arisfebriyanto193/EWS/EWS/eror_code.md

  #### Tabel Referensi Kode Anomali:

                    Kode                  |                 Status                 | Arti / Deskripsi Singkat
  ----------------------------------------|----------------------------------------|---------------------------------------------------------------
                     OK                   |             Normal / Aman              | Semua parameter sensor berada dalam batas aman
                     A1                   |             Baterai Lemah              | Tegangan baterai/aki lemah atau sensor daya 0.00V
                     A2                   |                 Bahaya                 | Kemiringan lereng Gyro Pitch / Roll ekstrem (≥ Ambang Bahaya)
                     A3                   |                 Siaga                  | Kemiringan lereng Gyro Pitch / Roll waspada (≥ Ambang Siaga)
                     A4                   |                 Bahaya                 | Curah hujan ekstrem tinggi (≥ Ambang Bahaya)
                     A5                   |                 Siaga                  | Curah hujan lebat (≥ Ambang Siaga)
                     A6                   |                 Bahaya                 | Getaran gempa / pergerakan tanah ekstrem (≥ Ambang Bahaya)
                     A7                   |                 Siaga                  | Kelembapan tanah kritis / jenuh air (≥ Ambang Siaga)
                     A8                   |                 Siaga                  | Getaran sesaat terdeteksi (tahap filter persistensi)
