arisfebriyanto193/EWS/dokumen/Penguatan_Kapasitas_Karang_Taruna_dan_Masyarakat_Karanggayam.pptx

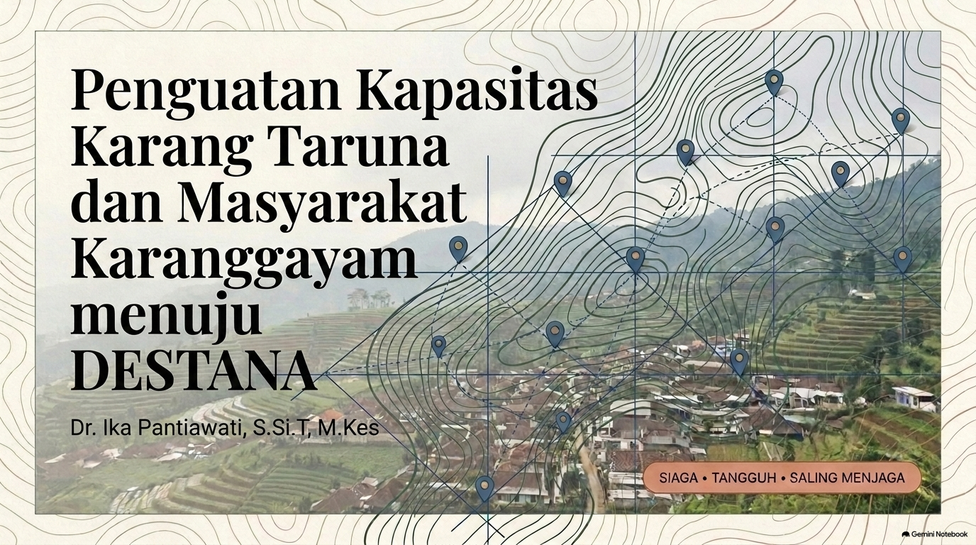
[picture p6: figure]

## Slide 2

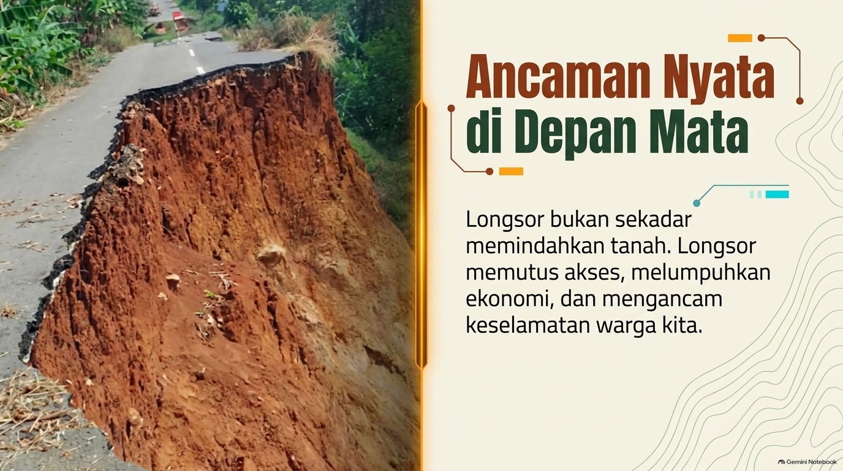
[picture p7: figure]

## Slide 3

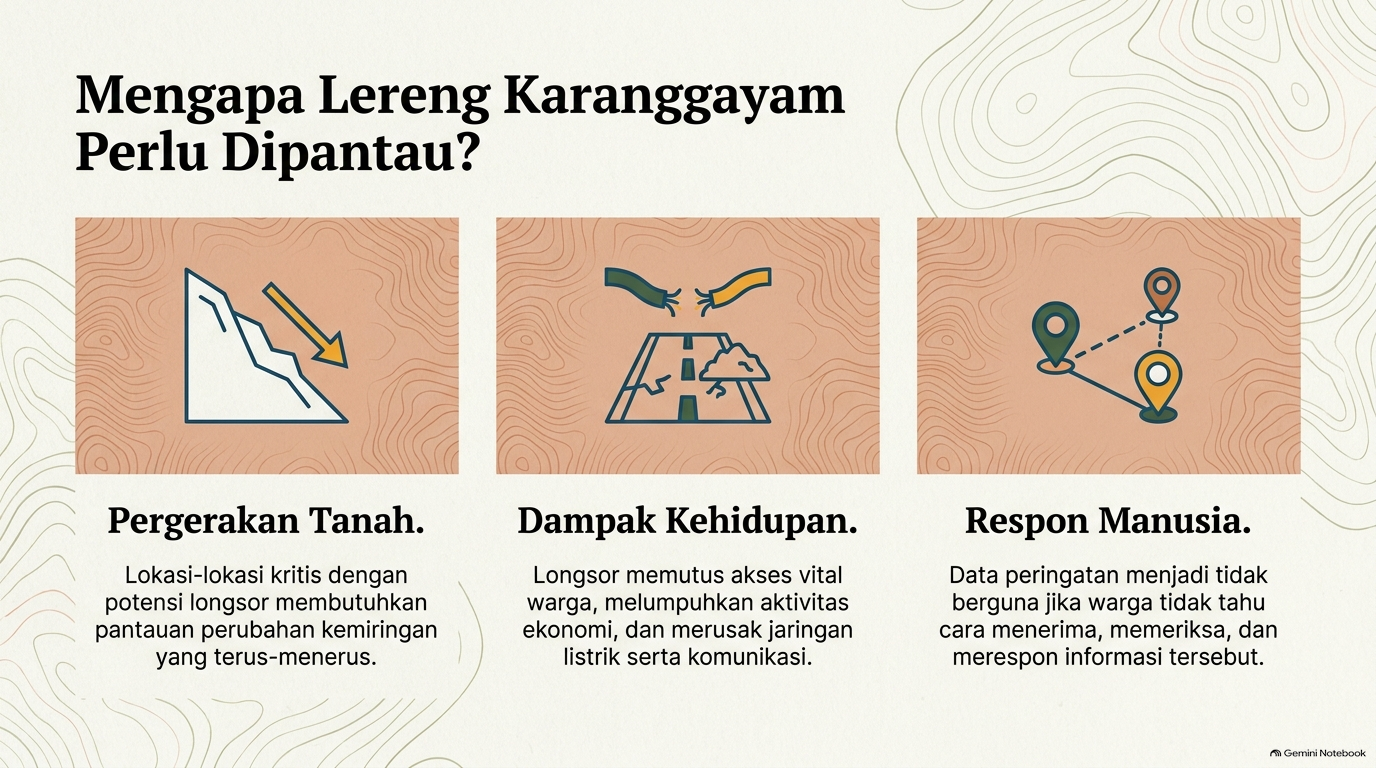
[picture p8: figure]

## Slide 4

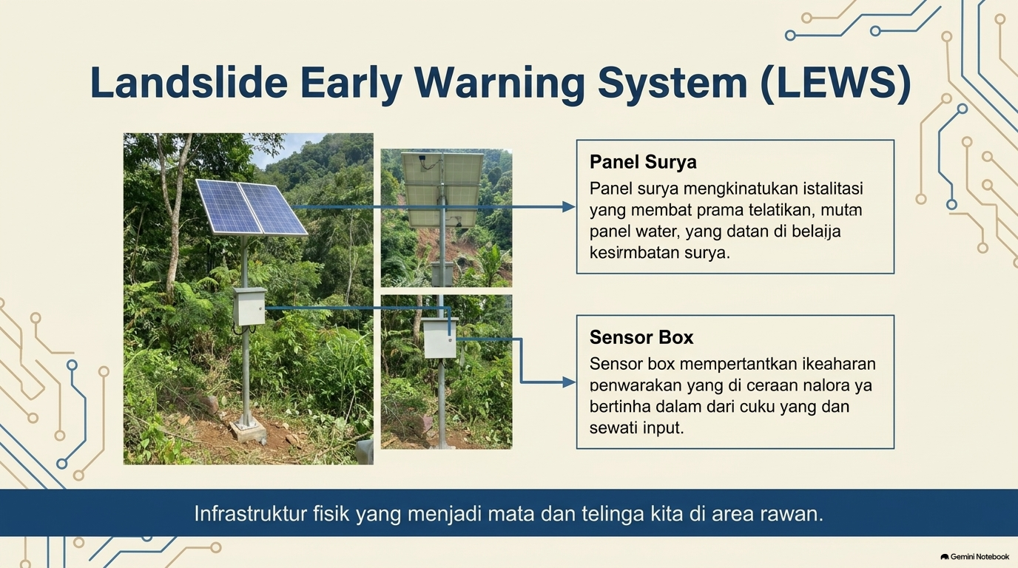
[picture p9: figure]

## Slide 5

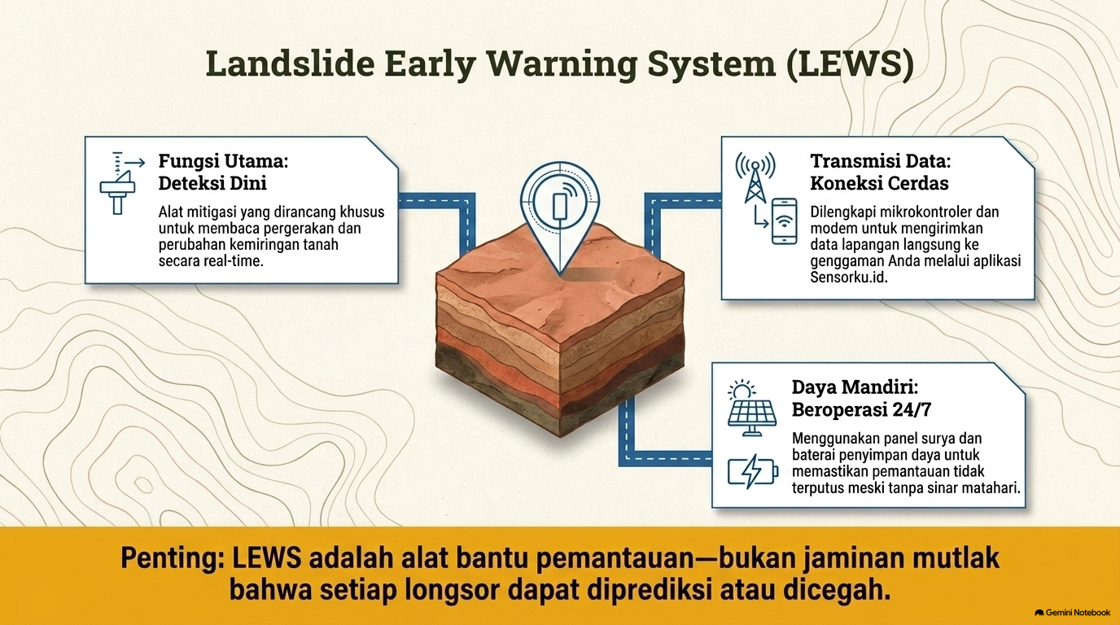
[picture p10: figure]

## Slide 6

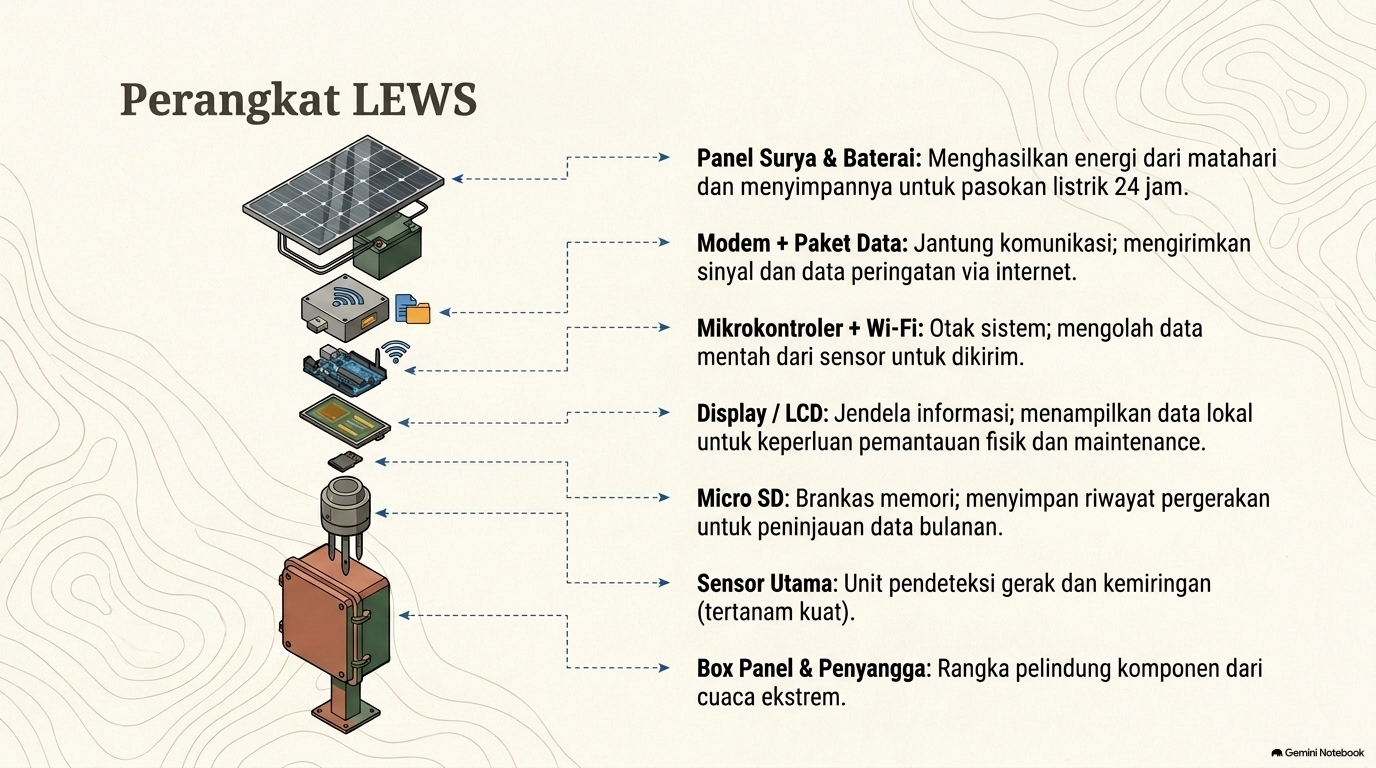
[picture p11: figure]

## Slide 7

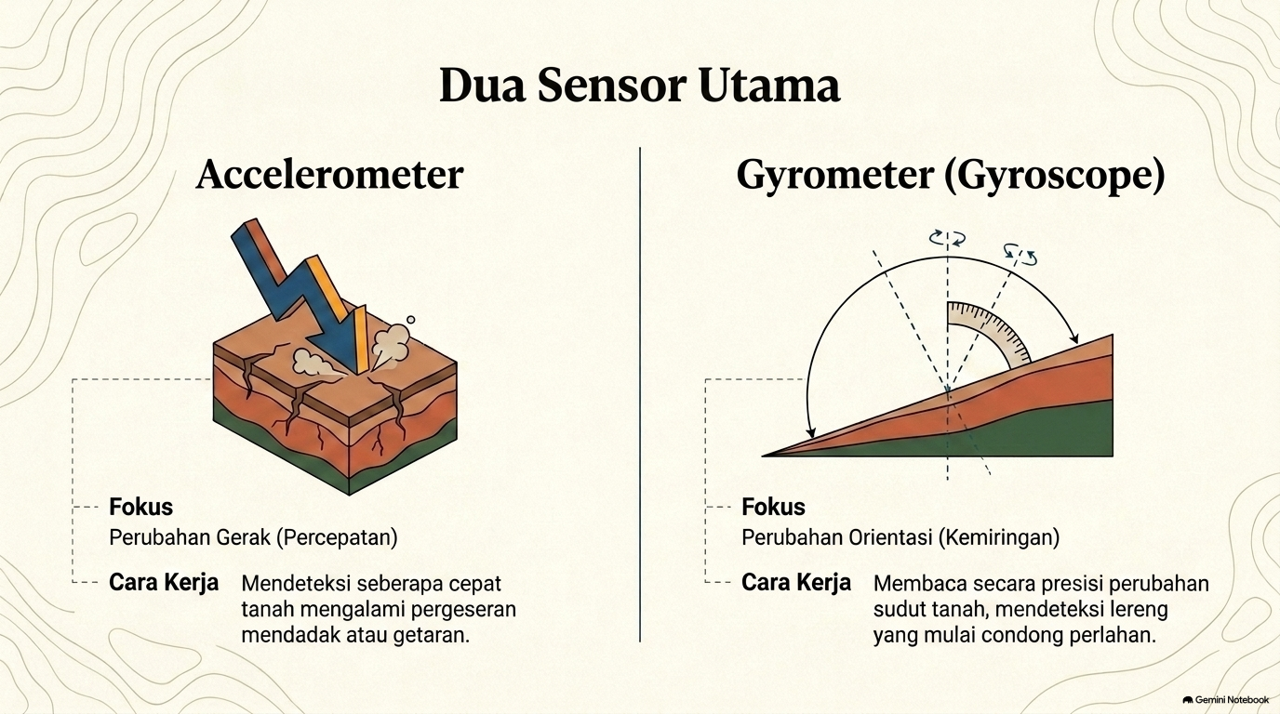
[picture p12: figure]

## Slide 8

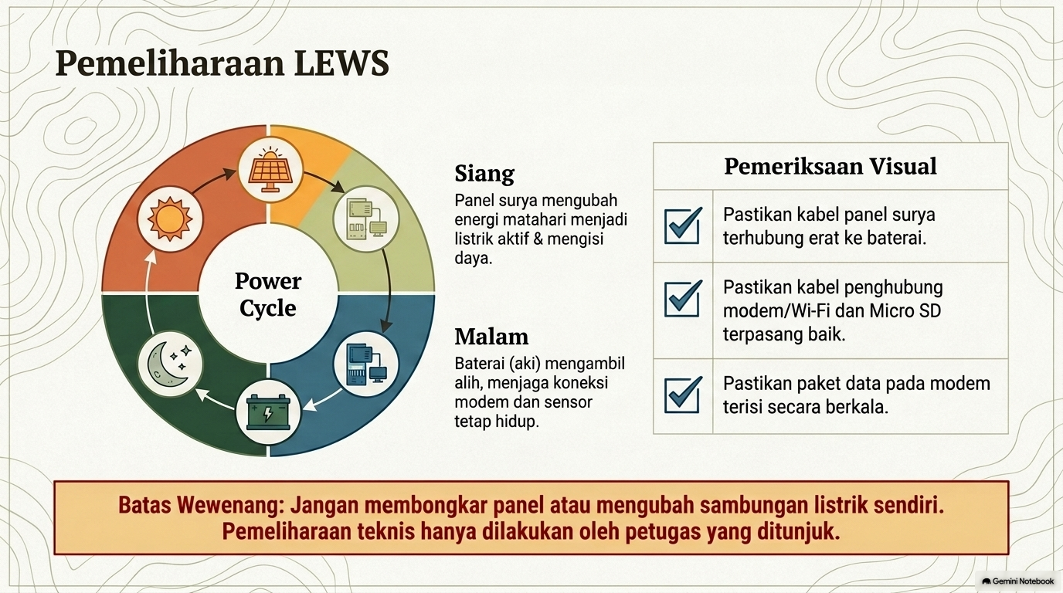
[picture p13: figure]

## Slide 9

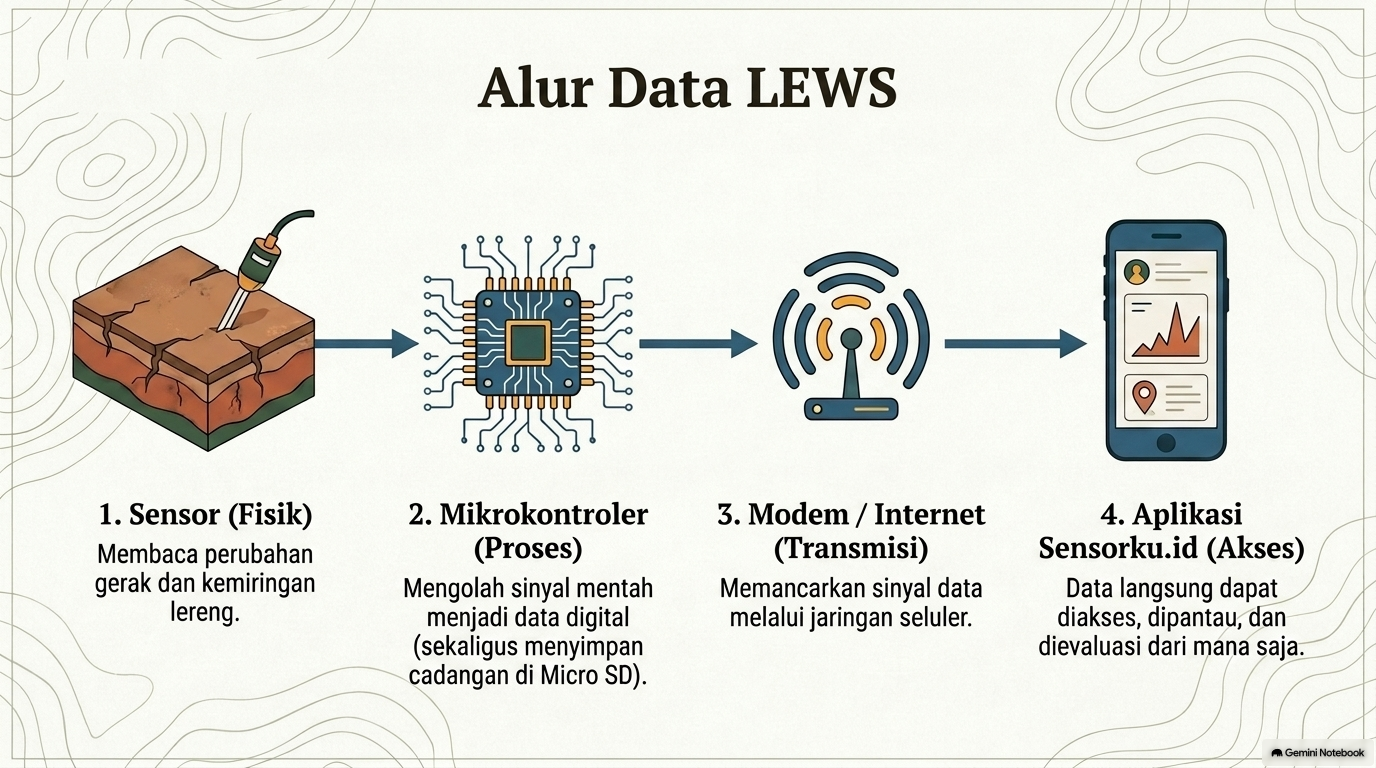
[picture p14: figure]

## Slide 10

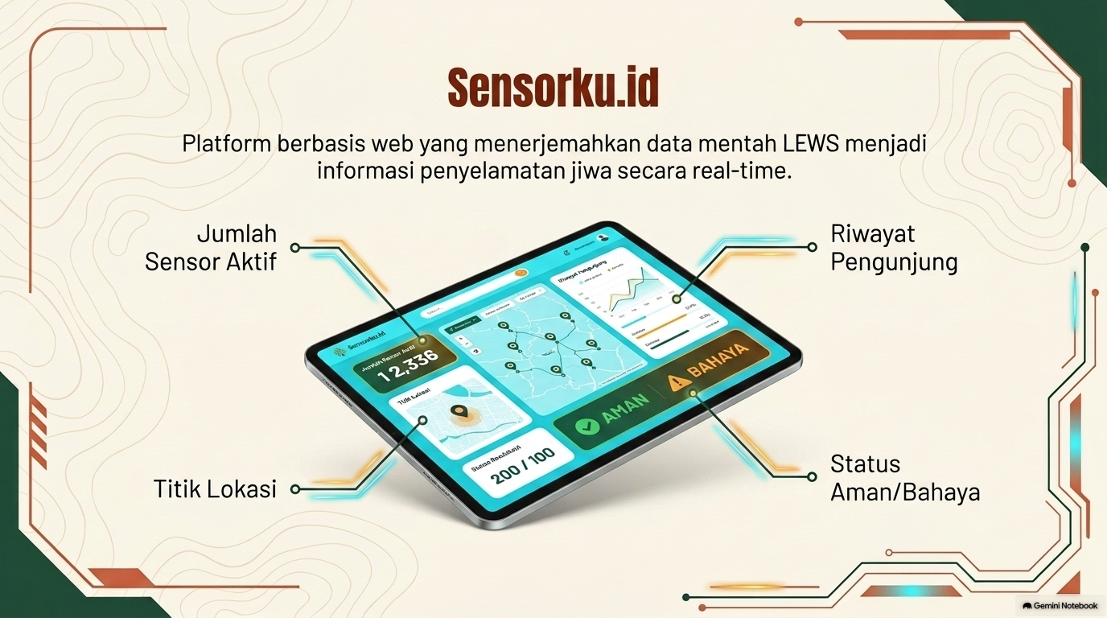
[picture p15: figure]

## Slide 11

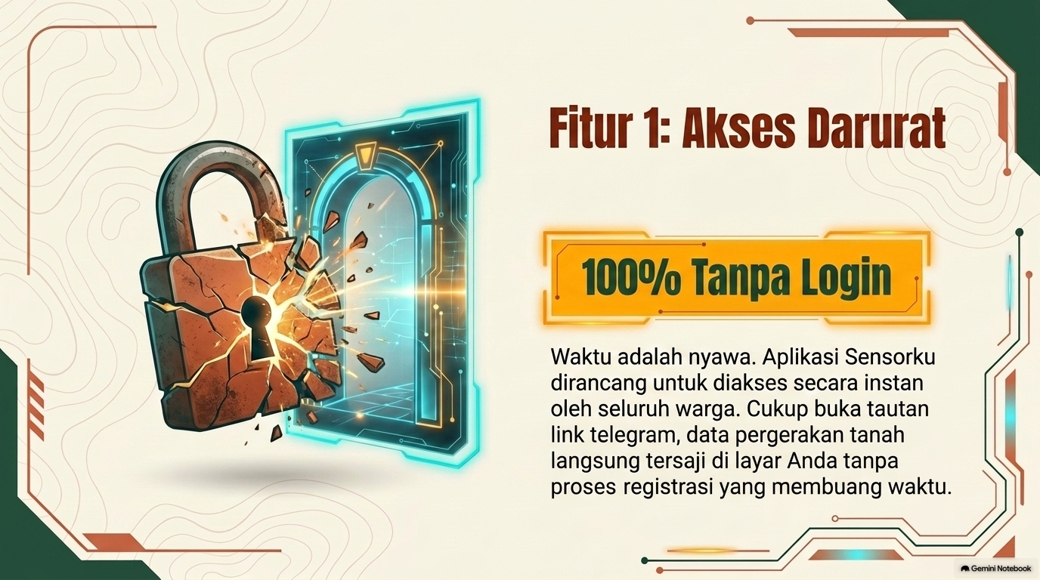
[picture p16: figure]

## Slide 12

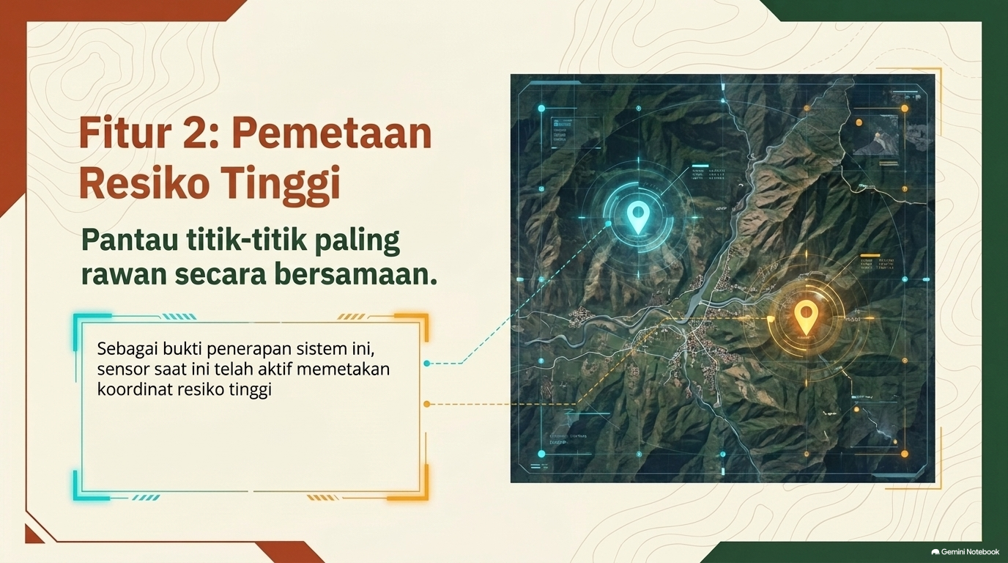
[picture p17: figure]

## Slide 13

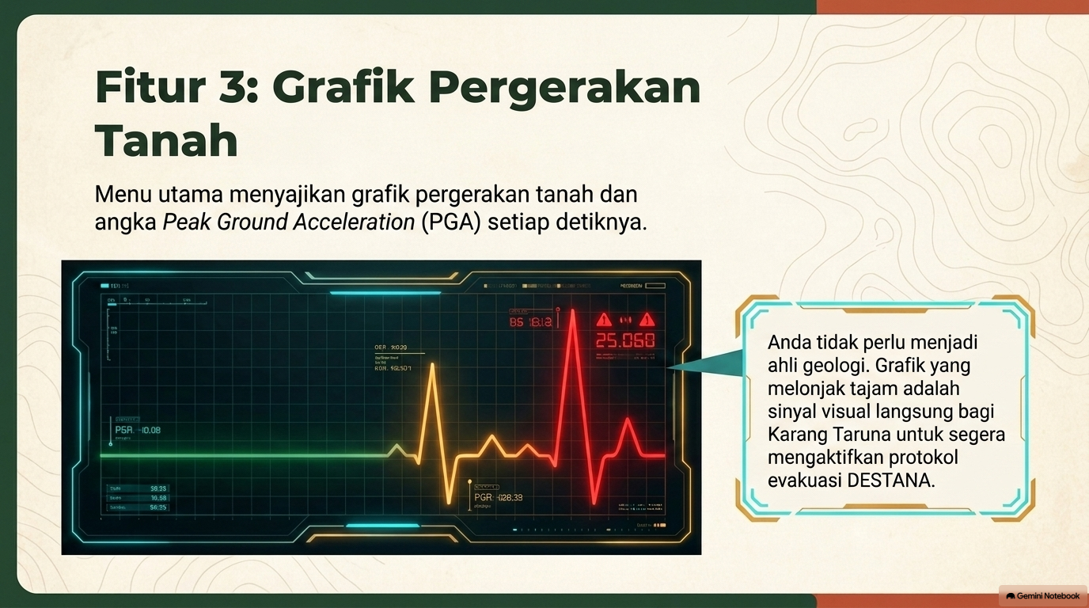
[picture p18: figure]

## Slide 14

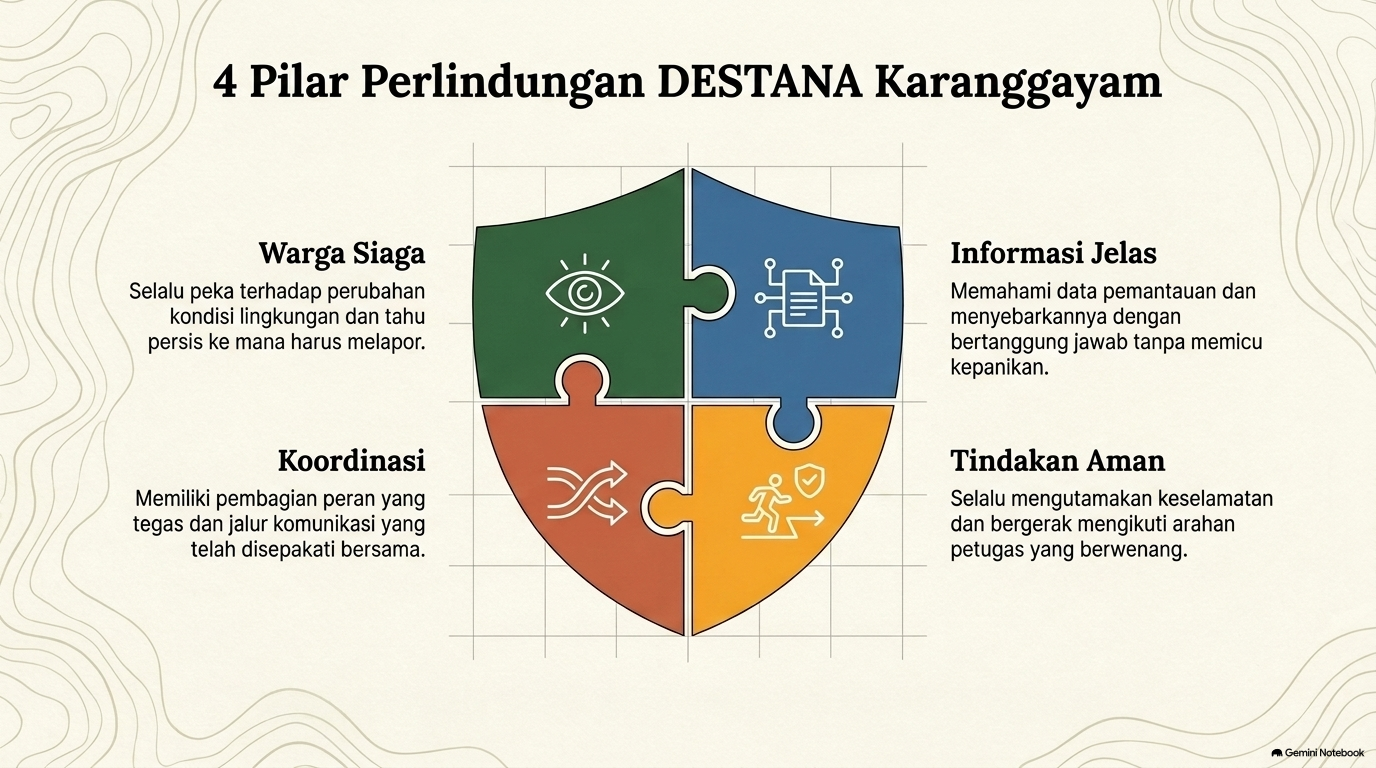
[picture p19: figure]

## Slide 15

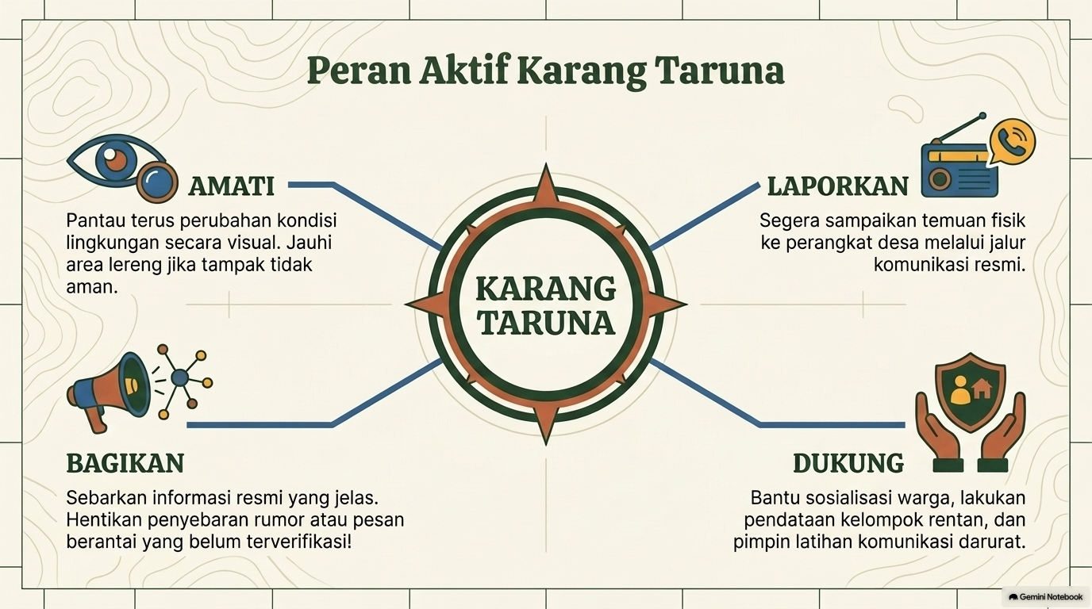
[picture p20: figure]

## Slide 16

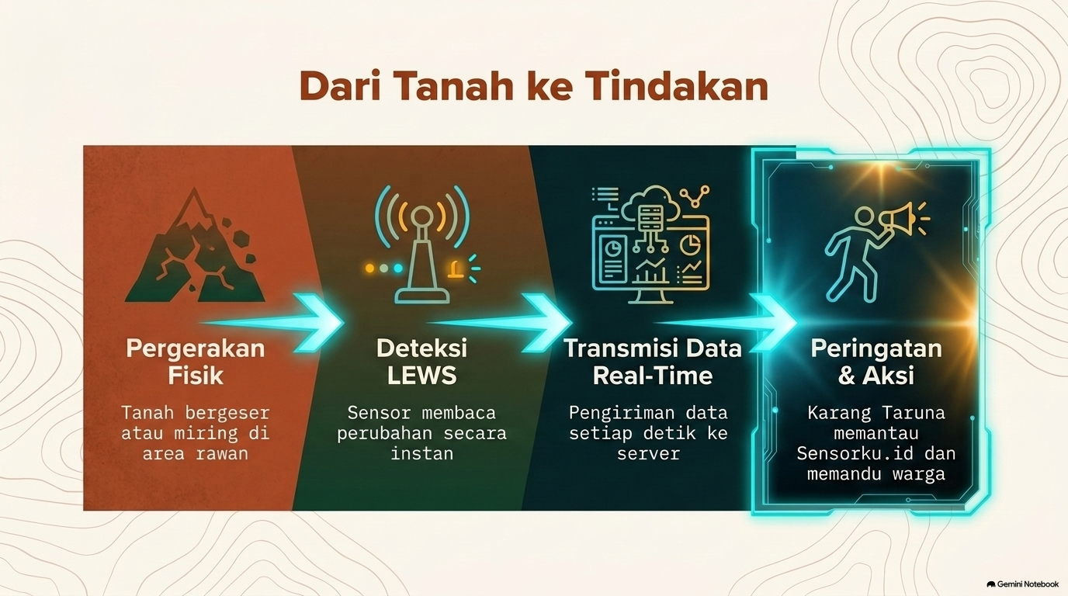
[picture p21: figure]

## Slide 17

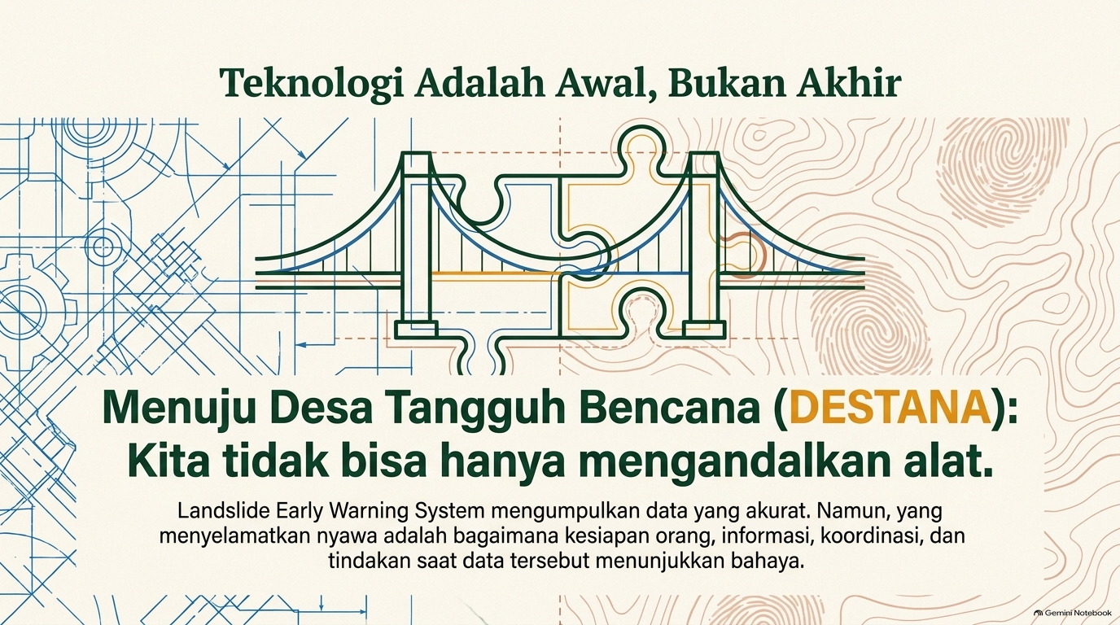
[picture p22: figure]

## Slide 18

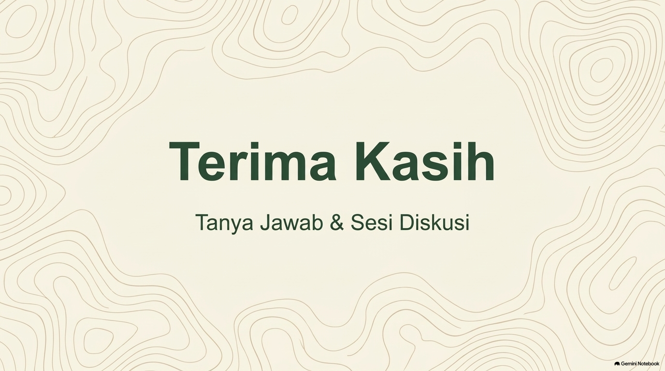
[picture p23: figure]
