arisfebriyanto193/EWS/3d/batre/bracket_check.png

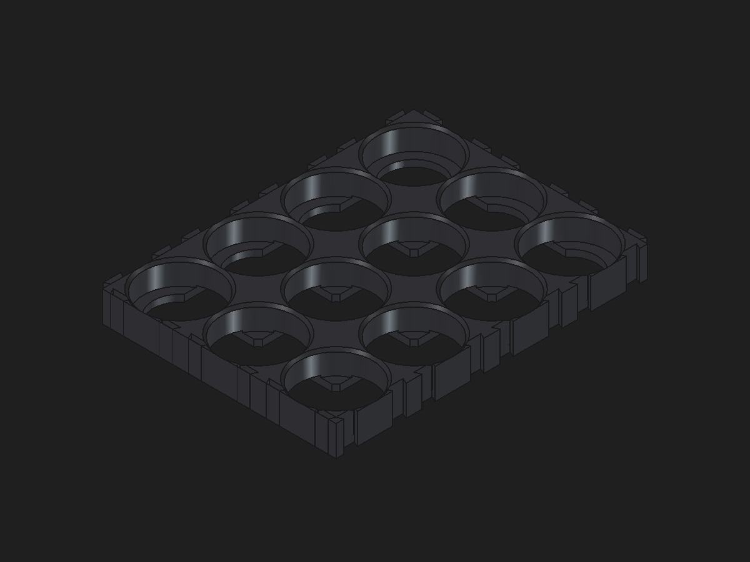
3d/batre/bracket_check.png
