arisfebriyanto193/EWS/3d/batre/bracket_check_bottom.png

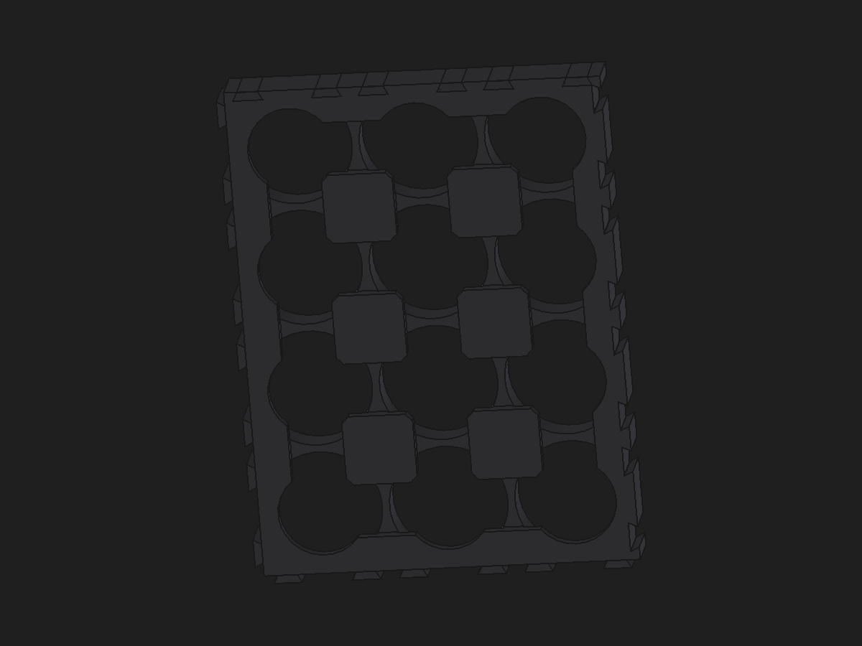
3d/batre/bracket_check_bottom.png
