arisfebriyanto193/EWS/EWS/docs/images/schematic_ews45_rev2-1.png

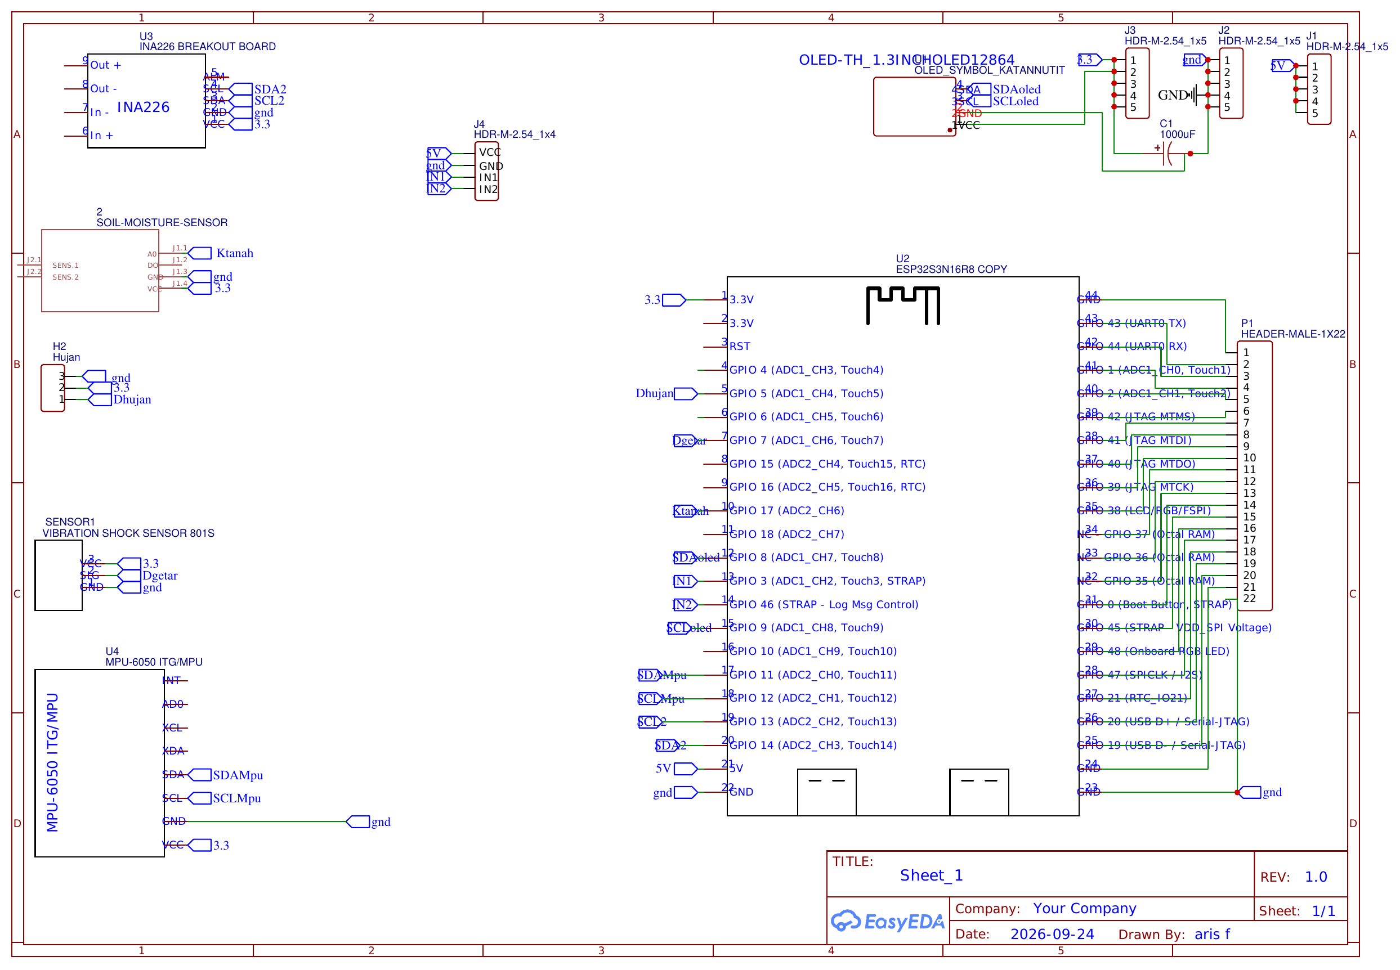
EWS/docs/images/schematic_ews45_rev2-1.png
