arisfebriyanto193/EWS/EWS/docs/images/screenshot_alarms.png

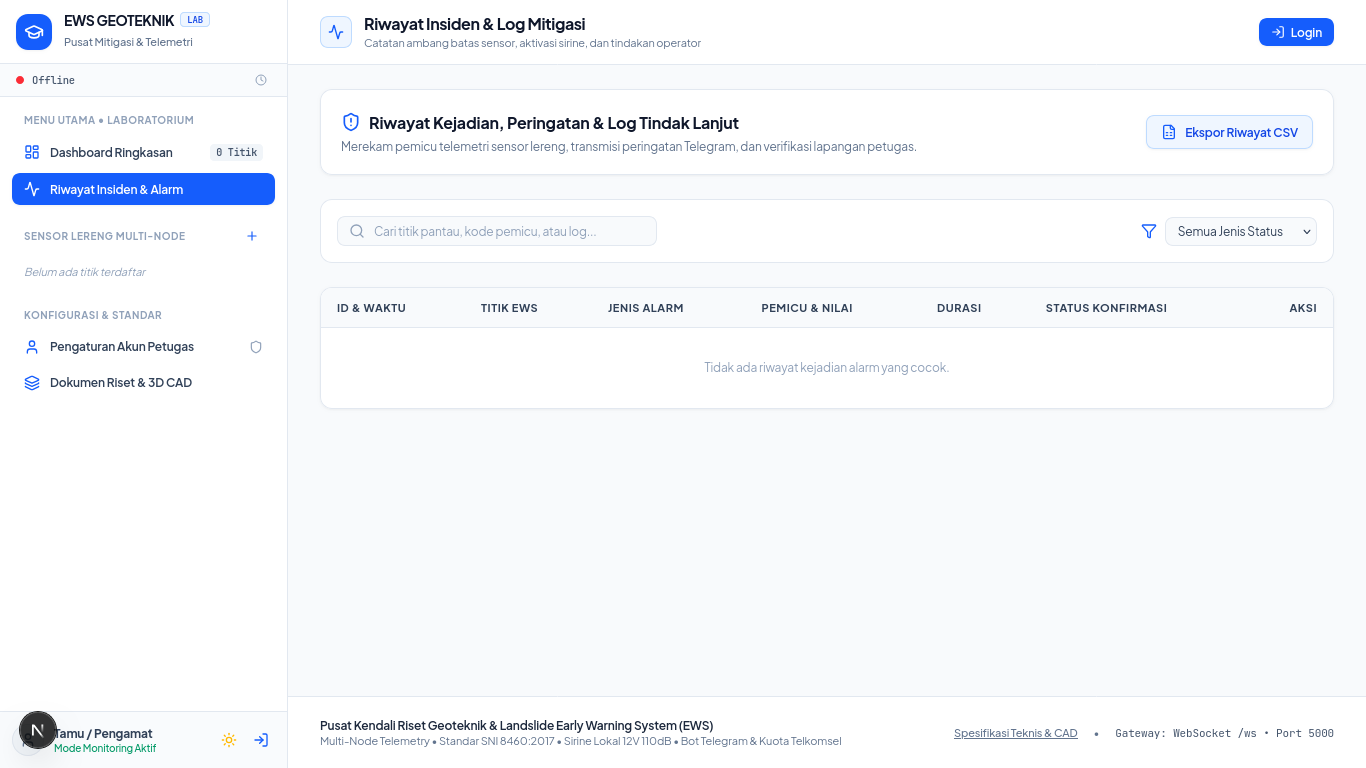
EWS/docs/images/screenshot_alarms.png
