arisfebriyanto193/EWS/EWS/PCB/toolpaths_preview.png

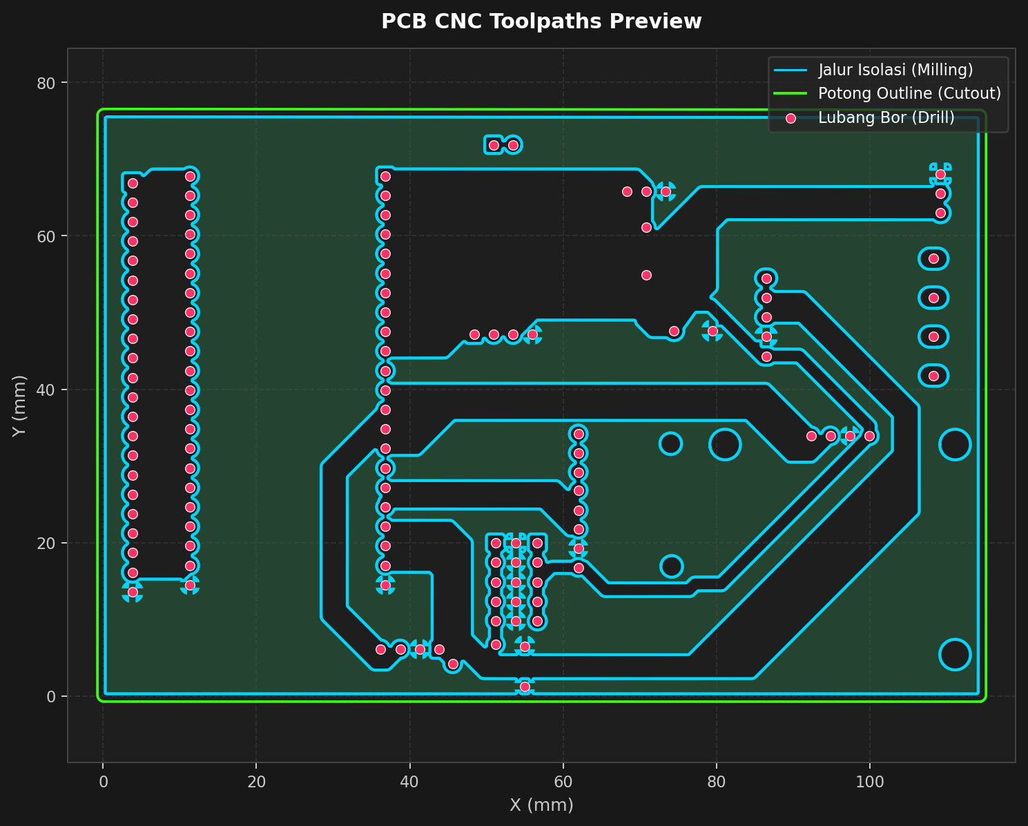
EWS/PCB/toolpaths_preview.png
