arisfebriyanto193/EWS/perangkap-hama/gcode/toolpaths_preview.png

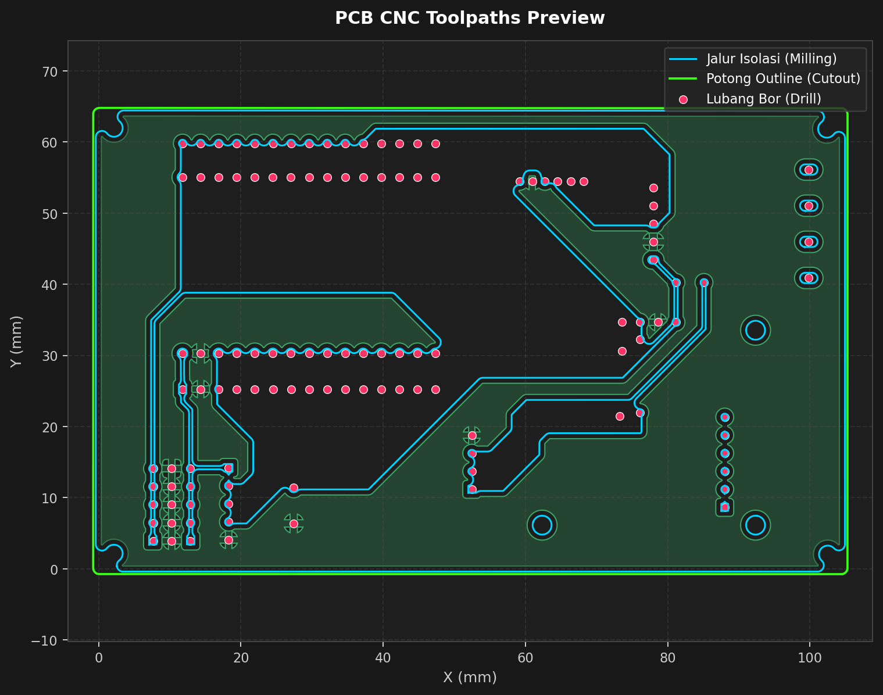
perangkap-hama/gcode/toolpaths_preview.png
