arisfebriyanto193/EWS/3d/batre/Bracket_21700_3S4P.step

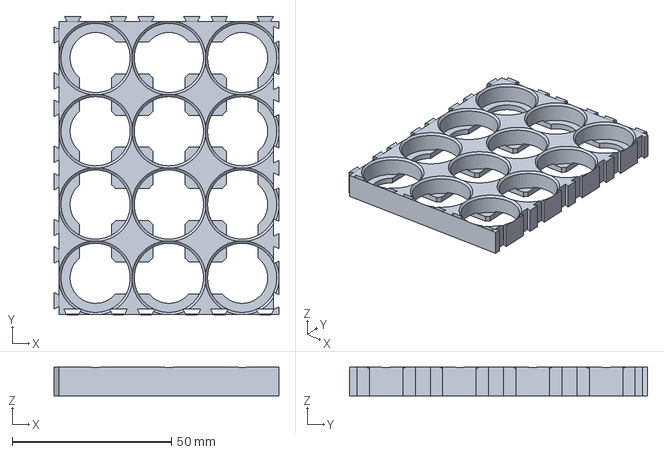
[picture p37: CAD file, 2026-10-11]
3d/batre/Bracket_21700_3S4P.step
70.5 x 93.5 x 9.00 mm
