arisfebriyanto193/EWS/EWS/Box_Panel_EWS.3mf

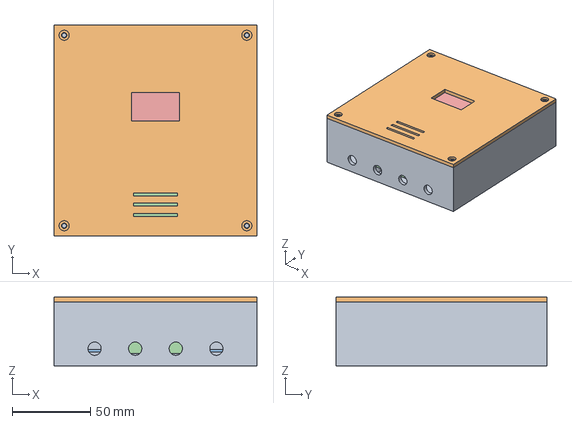
[picture p38: CAD file, 2026-10-11]
EWS/Box_Panel_EWS.3mf
130.0 x 135.0 x 44.0 mm
