arisfebriyanto193/EWS/(list of files, cad)

Other CAD files:
3d/batre/Bracket_21700_3S4P.FCStd
3d/batre/Bracket_21700_3S4P.stl
