arisfebriyanto193/EWS/perangkap-hama/pcb/Gerber_perangkap_hama_PCB_perangkap_hama_2_2026-09-30/How-to-order-PCB.txt

How to Order PCB

Please refer to:
https://docs.easyeda.com/en/PCB/Order-PCB
