arisfebriyanto193/EWS/EWS/PCB/Schematic_EWS45_2026-09-28.pdf

## INA226

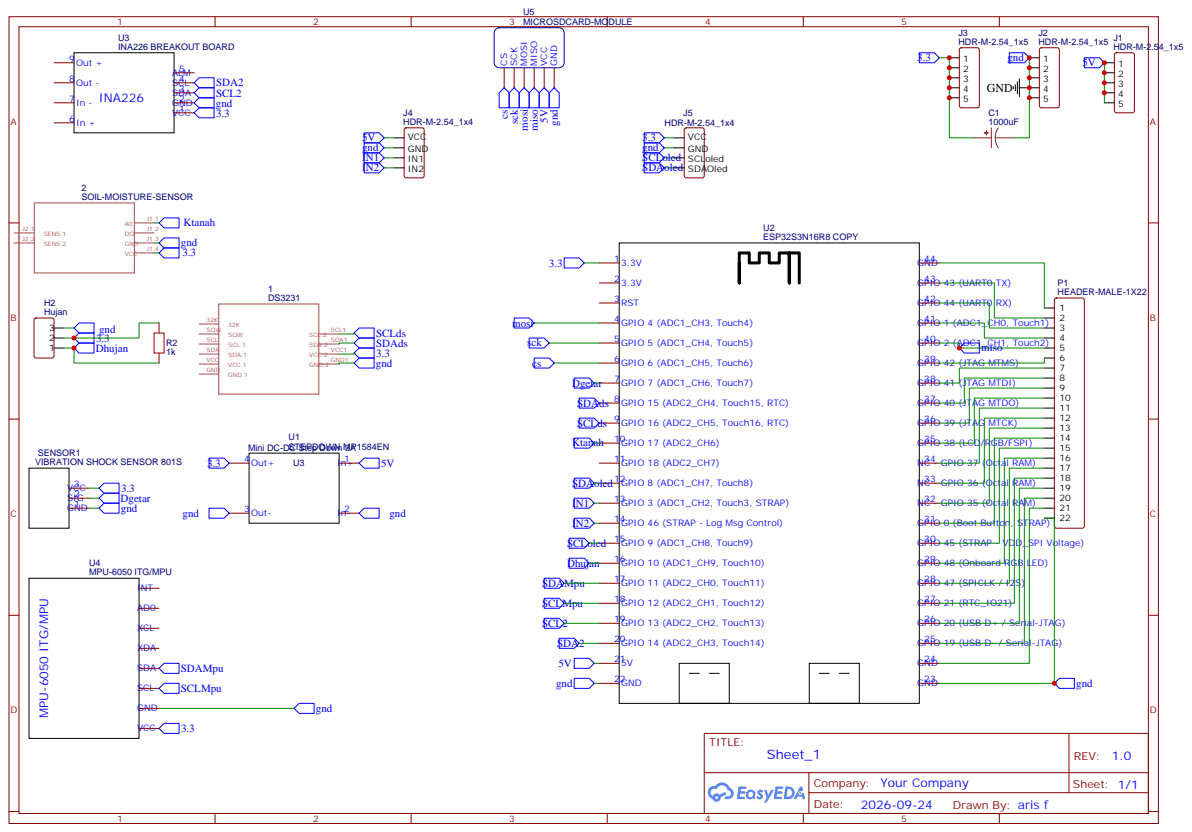
[picture p39: page 1]

GND44
GPIO 43 (UART0 TX) 43
GPIO 44 (UART0 RX) 42
GPIO 1 (ADC1_CH0, Touch1) 41
GPIO 2 (ADC1_CH1, Touch2) 40
GPIO 42 (JTAG MTMS) 39
GPIO 41 (JTAG MTDI) 38
GPIO 40 (JTAG MTDO) 37
GPIO 39 (JTAG MTCK) 36
GPIO 38 (LCD/RGB/FSPI) 35
NC - GPIO 37 (Octal RAM) 34
NC - GPIO 36 (Octal RAM) 33
NC - GPIO 35 (Octal RAM) 32
GPIO 0 (Boot Button, STRAP) 31
GPIO 45 (STRAP - VDD_SPI Voltage) 30
GPIO 48 (Onboard RGB LED) 29
GPIO 47 (SPICLK / I2S) 28
GPIO 21 (RTC_IO21) 27
GPIO 20 (USB D+ / Serial-JTAG) 26
GPIO 19 (USB D- / Serial-JTAG) 25
GND24

Mini DC-DC Step Down 3A
Out+ 4
