arisfebriyanto193/EWS/perangkap-hama/pcb/pcb/Schematic_perangkap_hama_2026-10-03.pdf

A | A

1

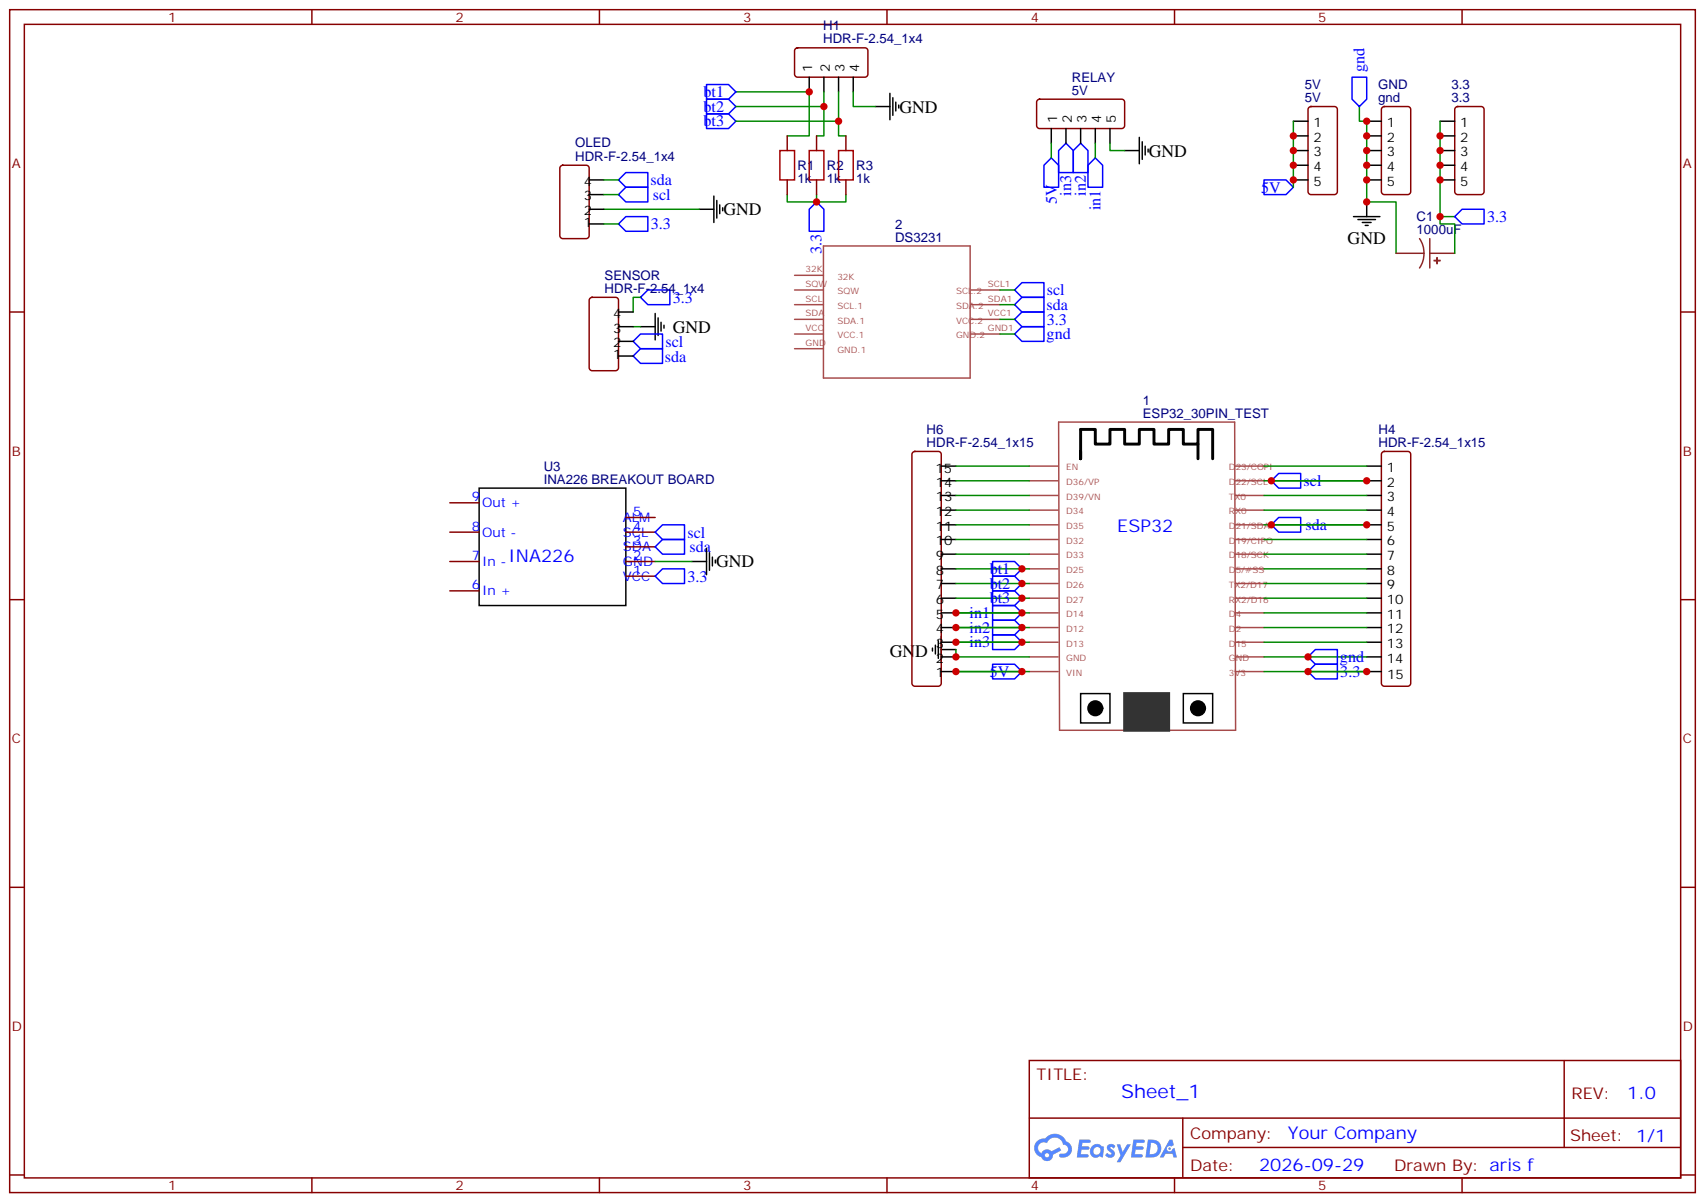
[picture p40: page 1]
