arisfebriyanto193/EWS/EWS/esp32-program/esp_32/esp_32.ino

/**
 * ==============================================================================
 * SISTEM MONITORING LANDSLIDE EARLY WARNING SYSTEM (EWS) - ESP32-S3 FIRMWARE
 * DENGAN ARSITEKTUR MULTI-TASKING FREERTOS & MUTEX SYNCHRONIZATION
 * ==============================================================================
 * Deskripsi:
 * Program firmware ESP32-S3 untuk Node EWS yang terhubung ke Backend Express
 * dan Frontend Next.js melalui protokol WebSocket secara real-time.
 *
 * Menerapkan FreeRTOS Dual-Core & Mutex:
 * - Core 0: Task WebSocket Client (Jaringan & Protokol TCP/SSL)
 * - Core 1: Task Sensor (I2C Inclinometer, INA226, OLED, ADC Tanah, Hujan)
 * - Core 1: Task Telemetri (Penerbitan Data dengan Pacing Buffer SSL)
 * - Mutex (wsMutex): Mengunci akses thread-safe ke webSocket.loop() & sendTXT()
 * - Mutex (dataMutex): Mengunci sinkronisasi data sensor antar-task
 * - Critical Section (vibMux): Penguncian atomik pulsa interrupt getaran 801S
 *
 * MAPPING PIN SESUAI DOKUMEN SCHEMATIC PCB:
 * File: Schematic_EWS45_2026-09-28.pdf
 * Mikrokontroler: ESP32-S3 (ESP32S3N16R8)
 * ------------------------------------------------------------------------------
 * PIN SCHEMATIC        | FUNGSI / KOMPONEN
 * ------------------------------------------------------------------------------
 * GPIO 46 (IN2)        | Output Relay Alarm Terpadu: Sirine 12V + Strobo (Active-HIGH)
 * GPIO 10 (Dhujan)     | Input Digital Sensor Hujan Tipping Bucket (H2)
 * GPIO 7  (Dgetar)     | Input Digital Sensor Getaran Shock 801S (SENSOR1)
 * GPIO 17 (Ktanah)     | Input Analog (ADC2_CH6) Sensor Kelembapan Tanah (J1.1 A0)
 * GPIO 8  (SDAoled)    | I2C SDA - Layar OLED 1.3" 128x64 (J5)
 * GPIO 9  (SCLoled)    | I2C SCL - Layar OLED 1.3" 128x64 (J5)
 * GPIO 11 (SDAMpu)     | I2C SDA - MPU-6050 Dual-Axis Inclinometer (U4)
 * GPIO 12 (SCLMpu)     | I2C SCL - MPU-6050 Dual-Axis Inclinometer (U4)
 * GPIO 13 (SCL2/SDA)   | I2C SDA - INA226 Voltage & Current Monitor (U3) via Net SCL2
 * GPIO 14 (SDA2/SCL)   | I2C SCL - INA226 Voltage & Current Monitor (U3) via Net SDA2
 * GPIO 4  (mosi)       | SPI MOSI - MicroSD Card Module (U5)
 * GPIO 5  (sck)        | SPI SCK - MicroSD Card Module (U5)
 * GPIO 6  (cs)         | SPI CS - MicroSD Card Module (U5)
 * GPIO 2  (miso)       | SPI MISO - MicroSD Card Module (U5)
 * GPIO 15 (SDAds)      | I2C SDA - DS3231 High-Precision RTC (Bus Terpisah 0x68)
 * GPIO 16 (SCLds)      | I2C SCL - DS3231 High-Precision RTC (Bus Terpisah 0x68)
 * ==============================================================================
 */

#include <WiFi.h>
// WiFiManager dihapus - diganti dengan WebServer bawaan + AP auto-management
#include <WebServer.h>
#include <WebSocketsClient.h>
#include <ArduinoJson.h>
#include <Wire.h>
#include <SPI.h>
#include <SD.h>
#include <SPIFFS.h>
#include <math.h>
#include <time.h>
#include <Preferences.h>
#include <driver/gpio.h>   // gpio_reset_pin() — memutus GPIO Matrix dari periferal (I2C, dll.)
// Catatan: Library MPU6050, INA219, dan DS3231 kini menggunakan driver bus independen
// (Hardware TwoWire 1 untuk MPU-6050 & Dedicated SoftI2C untuk RTC/INA)
// sehingga tidak lagi memerlukan overhead atau bentrok bus dari library Adafruit_BusIO.

// Forward Declarations Struct & Functions untuk Arduino Preprocessor
struct SensorThresholds;
struct SensorRawValues;
struct SensorDataSnapshot;
void setupWebServer();
void updateWebSocketTopics();
void saveThresholdsToEEPROM(const SensorThresholds &newT);
void loadThresholdsFromEEPROM();
void saveDeviceConfigToNVS(const String &newId, const String &newSsid, const String &newPass,
                           const String &newHost, int newPort, const String &newPath, bool newSsl);
void loadDeviceConfigFromNVS();
void syncRTCWithNTP(bool force = false);
void setSystemTimeFromEpoch(time_t epoch);
void checkAndPruneSDCard();
void checkAndPruneSPIFFS();
void initMicroSD();
void initSPIFFS();
void logPeriodicTelemetryToSD(float pitch, float roll, float soil, int soilRaw,
                              float rain, float rainCumu, unsigned long tips,
                              float vib, unsigned long vibPulses,
                              float batt, int battMa, int solar,
                              const char* status, const char* reason);
void logEventToSD(const char* status, const char* reason, float pitch, float roll, float rain, float soil, float batt);
void checkDailyRainReset();
void saveDailyRainToEEPROM();
void checkAndRestoreDailyRain();
bool getCurrentDateParts(int &day, int &mon, int &yr, int &hr, int &min);

// FreeRTOS Headers
#include "freertos/FreeRTOS.h"
#include "freertos/task.h"
#include "freertos/semphr.h"

// Aktifkan dukungan layar OLED jika library terpasang (1 = Aktif, 0 = Nonaktif)
#define ENABLE_OLED 1

#if ENABLE_OLED
  #include <Adafruit_GFX.h>
  #include <Adafruit_SH110X.h>
  #define SCREEN_WIDTH 128
  #define SCREEN_HEIGHT 64
  #define OLED_RESET -1
  #define OLED_I2C_ADDR 0x3C
#endif

// =============================================================================
// 1. KONFIGURASI JARINGAN, DEVICE ID & SERVER WEBSOCKET (DAPAT DIATUR VIA WEB)
// =============================================================================
// Default Fallback Kredensial WiFi (dapat diganti via NVS/Web Server)
String wifiSsidDefault     = "TALAS 1";
String wifiPasswordDefault = "kitahebat";

// Konfigurasi Target WebSocket Server (disimpan & dibaca dari NVS Preferences)
bool   wsUseSsl            = true;
String wsHost              = "be-ews.qbyte.web.id";
int    wsPort              = 443;
String wsPath              = "/ws";

// Identitas Node Stasiun EWS (disimpan di NVS "ews_cfg" -> "devId")
String ewsId               = "EWS-02";
const char* FIRMWARE_VERSION = "v2.6.0-NO-WIFIMGR";

// Objek Internal WebServer untuk Kalibrasi & Konfigurasi Mandiri
WebServer localServer(80);

// Manajemen AP Otomatis (pengganti WiFiManager)
// Jika WiFi tidak terhubung, AP dinyalakan. Setiap 30 detik dicek:
// - Jika jaringan tersimpan tersedia → matikan AP, sambung WiFi
// - Jika WiFi terputus → nyalakan AP kembali
bool apActive = false;
unsigned long lastWifiCheckMs = 0;
const unsigned long WIFI_CHECK_INTERVAL_MS = 30000; // 30 detik

// =============================================================================
// 2. DEFINISI PIN SESUAI SCHEMATIC PCB
// =============================================================================
// Aktuator Relay (Sirine & Strobo digabung menjadi 1 pin: GPIO 46, Active-HIGH)
#define PIN_RELAY_ALARM      46  // IN2 -> GPIO 46 (Sirine + Strobo)
#define PIN_RELAY_SIRINE     PIN_RELAY_ALARM
#define PIN_RELAY_STROBO     PIN_RELAY_ALARM

// Logika Relay (Active-HIGH)
#define RELAY_ACTIVE_LEVEL   HIGH
#define RELAY_DEACTIVE_LEVEL LOW

// Sensor Lingkungan & Geoteknik
#define PIN_RAIN_DIGITAL   10   // Dhujan -> GPIO 10 (Input Digital Sensor Hujan Tipping Bucket)
#define PIN_VIB_SIG        7   // Dgetar -> GPIO 7 (Input Digital Getaran 801S)
#define PIN_SOIL_ANALOG    17  // Ktanah -> GPIO 17 (ADC2_CH6 Kelembapan Tanah J1.1 A0)

// Pin I2C Perangkat 1: OLED 1.3" (Header J5)
#define PIN_OLED_SDA_utama     8   // SDAoled Utama -> GPIO 8
#define PIN_OLED_SDA_cadangan  18  // SDAoled Cadangan (Fallback) -> GPIO 18
#define PIN_OLED_SDA           PIN_OLED_SDA_cadangan // Alias kompatibilitas
#define PIN_OLED_SCL           9   // SCLoled -> GPIO 9

// Pin I2C Perangkat 2: MPU-6050 Dual-Axis Inclinometer (U4)
#define PIN_MPU_SDA        11  // SDAMpu -> GPIO 11
#define PIN_MPU_SCL        12  // SCLMpu -> GPIO 12
#define MPU6050_ADDR       0x68

// Pin I2C Perangkat 3: INA219 / INA226 Voltage & Current Monitor (U3)
// Terbukti dari hardware scanner: GPIO 14 = SDA, GPIO 13 = SCL
#define PIN_INA_SDA        14  // Pin SDA INA219 (GPIO 14)
#define PIN_INA_SCL        13  // Pin SCL INA219 (GPIO 13)
#define INA_I2C_ADDR         0x40

// Fallback Pembagi Tegangan Resistor (Jika modul INA219/INA226 tidak terpasang)
// Pin GPIO 14 (Jalur SDA pada Header J3 INA) dihubungkan ke titik tengah resistor pembagi tegangan
// Resistor R1 = 11 ohm/k-ohm (ke kutub positif Aki) dan R2 = 4 ohm/k-ohm (ke GND)
#define PIN_BATTERY_DIVIDER 14
#define BATT_DIVIDER_R1     11.0f
#define BATT_DIVIDER_R2     4.0f
#define BATT_DIVIDER_DEFAULT_RATIO ((BATT_DIVIDER_R1 + BATT_DIVIDER_R2) / BATT_DIVIDER_R2) // 3.75f

// Pin SPI Perangkat 4: Modul MicroSD Card (U5)
#define PIN_SD_MOSI        4   // mosi -> GPIO 4
#define PIN_SD_SCK         5   // sck  -> GPIO 5
#define PIN_SD_CS          6   // cs   -> GPIO 6
#define PIN_SD_MISO        2   // miso -> GPIO 2

// Pin I2C Perangkat 5: Real-Time Clock DS3231 (Bus I2C terpisah untuk isolasi alamat 0x68 dari MPU6050)
#define PIN_RTC_SDA        15  // SDAds -> GPIO 15
#define PIN_RTC_SCL        16  // SCLds -> GPIO 16
#define DS3231_ADDR        0x68

// =============================================================================
// 3. TOPIK KOMUNIKASI WEBSOCKET (DINAMIS SESUAI DEVICE_ID)
// =============================================================================
String TOPIC_COMMAND;
String TOPIC_TELEMETRY;
String TOPIC_STATUS;
String TOPIC_PITCH;
String TOPIC_ROLL;
String TOPIC_SOIL;
String TOPIC_RAIN;
String TOPIC_RAIN_CUMU;
String TOPIC_VIB;
String TOPIC_BATT;
String TOPIC_SOLAR;
String TOPIC_IP;
String TOPIC_WIFI_SSID;
String TOPIC_WIFI_RSSI;
const char* LEGACY_RELAY_TOPIC = "USR_687de6987184f/1defa9dd";

void updateWebSocketTopics() {
  TOPIC_COMMAND   = "ews/" + ewsId + "/command";
  TOPIC_TELEMETRY = "ews/" + ewsId + "/telemetry";
  TOPIC_STATUS    = "ews/" + ewsId + "/status";
  TOPIC_PITCH     = "ews/" + ewsId + "/pitch";
  TOPIC_ROLL      = "ews/" + ewsId + "/roll";
  TOPIC_SOIL      = "ews/" + ewsId + "/soil_moisture";
  TOPIC_RAIN      = "ews/" + ewsId + "/rainfall_rate";
  TOPIC_RAIN_CUMU = "ews/" + ewsId + "/rainfall_cumulative";
  TOPIC_VIB       = "ews/" + ewsId + "/vibration";
  TOPIC_BATT      = "ews/" + ewsId + "/battery_voltage";
  TOPIC_SOLAR     = "ews/" + ewsId + "/solar_current";
  TOPIC_IP        = "ews/" + ewsId + "/ip";
  TOPIC_WIFI_SSID = "ews/" + ewsId + "/wifi_ssid";
  TOPIC_WIFI_RSSI = "ews/" + ewsId + "/wifi_rssi";
}

// =============================================================================
// 4. STRUKTUR DATA, EEPROM THRESHOLDS & MUTEX SYNCHRONIZATION
// =============================================================================
struct SensorThresholds {
  // Nilai Aman / Titik Nol Acuan Kalibrasi Sensor
  float safeTiltPitch;        // Baseline aman pitch (Derajat, default 0.0)
  float safeTiltRoll;         // Baseline aman roll (Derajat, default 0.0)
  float tiltTolerance;        // Toleransi simpangan aman (+- derajat, default: 2.0°)
  float tiltWarning;          // Default: 5.0 Derajat simpangan
  float tiltDanger;           // Default: 10.0 Derajat simpangan
  
  float rainWarning;          // Default: 20.0 mm/jam
  float rainDanger;           // Default: 50.0 mm/jam
  
  float safeSoilMoisture;     // Baseline aman kelembapan tanah (%, default: 50.0%)
  float soilMoistureTolerance;// Toleransi simpangan aman tanah (+- %, default: 15.0%)
  float soilMoistureWarning;  // Ambang batas siaga kelembapan tinggi: 75.0%
  
  float vibrationDanger;      // Default: 0.25 g / hitungan pulsa
  float batteryLowVoltage;    // Default: 11.8 V
  float battDividerRatio;     // Rasio pembagi tegangan resistor (default: 3.75f)
  
  // Kalibrasi ADC Tanah (Raw ADC saat kering & saat basah)
  int soilAdcDry;             // Default 3300
  int soilAdcWet;             // Default 1200
  float rainCalibPerTip;      // mm per tip, default: 0.70 mm

  // Siklus Timer Alarm Otomatis (Detik / S)
  uint32_t alarmDuration;     // Durasi sirine aktif saat anomali (detik, default: 60)
  uint32_t alarmPause;        // Jeda waktu mati sebelum sirine menyala lagi jika masih anomali (detik, default: 30)

  // Proteksi Baterai: Apakah relay alarm tetap aktif walau baterai lemah?
  bool forceAlarmOnLowBatt;   // true = alarm tetap nyala walau baterai lemah, false = matikan relay saat baterai lemah (default: false)
};

struct SensorRawValues {
  float pitchRaw;
  float rollRaw;
  int soilAdcRaw;
  float soilVoltRaw;
  float inaVoltRaw;
  int inaSolarCurrent;
  int inaBattCurrent;
  unsigned long rainTipsRaw;
  unsigned long vibPulsesRaw;
};

struct SensorDataSnapshot {
  float pitch;
  float roll;
  float soilMoisture;
  float soilTemp;
  float rainRate;
  float rainCumulative;
  unsigned long rainTips;
  float vibration;
  unsigned long vibrationPulses;
  float batteryVoltage;
  int solarCurrent;
  int batteryCurrent;
  int wifiRssi;
  unsigned long uptimeHours;
  char status[16];
  char alarmReason[96];
  char alarmCode[8];
};

// Objek Global, EEPROM / NVS & Mutex Handles
Preferences prefs;
SensorThresholds currentThresholds = {
  0.0f,   // safeTiltPitch
  0.0f,   // safeTiltRoll
  2.0f,   // tiltTolerance (+- 2 derajat)
  5.0f,   // tiltWarning
  10.0f,  // tiltDanger
  20.0f,  // rainWarning
  50.0f,  // rainDanger
  50.0f,  // safeSoilMoisture
  15.0f,  // soilMoistureTolerance (+- 15%)
  75.0f,  // soilMoistureWarning
  0.25f,  // vibrationDanger
  11.8f,  // batteryLowVoltage
  3.75f,  // battDividerRatio ((11+4)/4 = 3.75f)
  3300,   // soilAdcDry
  1200,   // soilAdcWet
  0.70f,  // rainCalibPerTip
  60,     // alarmDuration (detik, default 60s)
  30,     // alarmPause (detik, default 30s)
  false   // forceAlarmOnLowBatt (default: matikan relay saat baterai lemah)
};

SensorRawValues sharedRawSensors;

WebSocketsClient webSocket;
SemaphoreHandle_t wsMutex   = NULL; // Mutex untuk proteksi webSocket.loop() & sendTXT()
SemaphoreHandle_t dataMutex = NULL; // Mutex untuk proteksi pembacaan data sensor & thresholds
SemaphoreHandle_t i2cMutex  = NULL; // Mutex untuk proteksi transaksi hardware I2C Wire multi-pin
SemaphoreHandle_t sdMutex   = NULL; // Mutex untuk proteksi akses SPI file MicroSD Card

SensorDataSnapshot sharedSensors;
String currentAlarmReason = "Semua parameter sensor dalam batas aman";
String currentAlarmCode   = "OK";

// Critical Section & Debounce Filter untuk ISR Sensor Getaran Digital 801S
portMUX_TYPE vibMux = portMUX_INITIALIZER_UNLOCKED;
volatile unsigned long vibPulseCounter = 0;
// Debounce lockout filter mikrodetik (5000 us = 5 ms)
// Mengeliminasi bouncing mekanik pegas frekuensi tinggi & derau induksi EMI (relay/WiFi)
const unsigned long MIN_VIB_PULSE_INTERVAL_US = 5000;
volatile unsigned long lastVibInterruptMicros = 0;

void IRAM_ATTR onVibrationTriggered() {
  unsigned long nowUs = micros();
  if ((nowUs - lastVibInterruptMicros) >= MIN_VIB_PULSE_INTERVAL_US) {
    lastVibInterruptMicros = nowUs;
    portENTER_CRITICAL_ISR(&vibMux);
    vibPulseCounter++;
    portEXIT_CRITICAL_ISR(&vibMux);
  }
}

// --- SENSOR CURAH HUJAN TIPPING BUCKET (GPIO 10) ---
const byte RAIN_SENSOR_PIN = PIN_RAIN_DIGITAL; // Pin GPIO ESP32 yang terhubung ke OUT sensor (Dhujan)
const float CURAH_PER_TIP = 0.70;        // Nilai kalibrasi dari video (0.70 mm per tip)

// --- VARIABEL GLOBAL SENSOR HUJAN (TIPPING BUCKET) ---
volatile unsigned long tipCount = 0;
volatile unsigned long lastDebounceTime = 0;
// Interval minimum mekanis jungkitan (300 ms = maks 3.3 tip/detik)
// Tidak mungkin jungkitan mekanis di lapangan berosilasi lebih cepat dari 300 ms.
const unsigned long MIN_TIP_INTERVAL_MS = 300;

// --- ISR (Interrupt Service Routine) DENGAN HARDENED GLITCH FILTER ---
void IRAM_ATTR countTip() {
  unsigned long currentTime = millis();
  // 1. Cek interval waktu lockout debouncing
  if ((currentTime - lastDebounceTime) >= MIN_TIP_INTERVAL_MS) {
    // 2. Verifikasi awal logika pin (harus LOW saat kontak magnetik tertutup)
    if (digitalRead(PIN_RAIN_DIGITAL) == LOW) {
      // 3. Glitch Filter anti-derau induksi elektromagnetik (EMI) & RF spike WiFi:
      // Derau RF/switching spike transient berlangsung < 50 us.
      // Sedangkan kontak mekanis reed switch ember jungkit bertahan tertutup 15 - 40 ms.
      // Tunggu 2500 us (2.5 ms) dan verifikasi bahwa kontak reed switch masih berlogika LOW.
      esp_rom_delay_us(2500);
      if (digitalRead(PIN_RAIN_DIGITAL) == LOW) {
        tipCount++;
        lastDebounceTime = currentTime;
      }
    }
  }
}

// Status Koneksi (forward declaration — definisi lengkap ada setelah fungsi EEPROM)
volatile bool needWsReconnect = false; // Flag trigger reconnect WebSocket dengan konfigurasi baru

// -----------------------------------------------------------------------------
// FUNGSI EEPROM (NVS FLASH) UNTUK PENYIMPANAN AMBANG BATAS (THRESHOLDS)
// -----------------------------------------------------------------------------
void loadDeviceConfigFromNVS() {
  bool ok = prefs.begin("ews_cfg", true); // Read-only mode
  if (ok) {
    ewsId               = prefs.getString("devId", "EWS-02");
    wifiSsidDefault     = prefs.getString("wfSsid", "TALAS 1");
    wifiPasswordDefault = prefs.getString("wfPass", "kitahebat");
    wsHost              = prefs.getString("wsHost", "be-ews.qbyte.web.id");
    wsPort              = prefs.getInt("wsPort", 443);
    wsPath              = prefs.getString("wsPath", "/ws");
    wsUseSsl            = prefs.getBool("wsSsl", true);
    Serial.println("[NVS] Konfigurasi device berhasil dimuat dari NVS.");
  } else {
    Serial.println("[WARN] [NVS] Namespace ews_cfg tidak ditemukan, menggunakan nilai bawaan firmware.");
  }
  prefs.end(); // Selalu end() agar prefs tidak tertinggal terbuka
  updateWebSocketTopics();
  Serial.printf("[NVS] Identitas Perangkat: Device ID [%s], Host: %s:%d%s\n", 
                ewsId.c_str(), wsHost.c_str(), wsPort, wsPath.c_str());
}

void saveDeviceConfigToNVS(const String &newId, const String &newSsid, const String &newPass,
                           const String &newHost, int newPort, const String &newPath, bool newSsl) {
  if (prefs.begin("ews_cfg", false)) {
    prefs.putString("devId", newId);
    prefs.putString("wfSsid", newSsid);
    prefs.putString("wfPass", newPass);
    prefs.putString("wsHost", newHost);
    prefs.putInt("wsPort", newPort);
    prefs.putString("wsPath", newPath);
    prefs.putBool("wsSsl", newSsl);
    prefs.end();
    
    ewsId               = newId;
    wifiSsidDefault     = newSsid;
    wifiPasswordDefault = newPass;
    wsHost              = newHost;
    wsPort              = newPort;
    wsPath              = newPath;
    wsUseSsl            = newSsl;
    updateWebSocketTopics();
    needWsReconnect = true; // Trigger reconnect WebSocket dengan konfigurasi baru
    Serial.printf("[NVS] Konfigurasi Device ID [%s] & Koneksi Berhasil Disimpan! WebSocket akan reconnect...\n", ewsId.c_str());
  }
}

void loadThresholdsFromEEPROM() {
  bool ok = prefs.begin("ews_thresh", true); // Read-only mode
  if (ok) {
    currentThresholds.safeTiltPitch         = prefs.getFloat("safePitch", 0.0f);
    currentThresholds.safeTiltRoll          = prefs.getFloat("safeRoll", 0.0f);
    currentThresholds.tiltTolerance         = prefs.getFloat("tiltTol", 2.0f);
    currentThresholds.tiltWarning           = prefs.getFloat("tiltWarn", 5.0f);
    currentThresholds.tiltDanger            = prefs.getFloat("tiltDang", 10.0f);
    currentThresholds.rainWarning           = prefs.getFloat("rainWarn", 20.0f);
    currentThresholds.rainDanger            = prefs.getFloat("rainDang", 50.0f);
    currentThresholds.safeSoilMoisture      = prefs.getFloat("safeSoil", 50.0f);
    currentThresholds.soilMoistureTolerance = prefs.getFloat("soilTol", 15.0f);
    currentThresholds.soilMoistureWarning   = prefs.getFloat("soilWarn", 75.0f);
    currentThresholds.vibrationDanger       = prefs.getFloat("vibDang", 0.25f);
    currentThresholds.batteryLowVoltage     = prefs.getFloat("battLow", 11.8f);
    currentThresholds.battDividerRatio      = prefs.getFloat("battRatio", 3.75f);
    currentThresholds.soilAdcDry            = prefs.getInt("soilDry", 3300);
    currentThresholds.soilAdcWet            = prefs.getInt("soilWet", 1200);
    currentThresholds.rainCalibPerTip       = prefs.getFloat("rainCalib", 0.70f);
    currentThresholds.alarmDuration         = prefs.getUInt("alarmDur", 60);
    currentThresholds.alarmPause            = prefs.getUInt("alarmPause", 30);
    currentThresholds.forceAlarmOnLowBatt   = prefs.getBool("forceAlmBatt", false);
    prefs.end(); // Wajib end() agar namespace tidak tetap terbuka

    Serial.println("[EEPROM/NVS] Berhasil memuat nilai acuan kalibrasi & ambang batas:");
    Serial.printf("   - Sudut Aman Pitch/Roll : %.2f° / %.2f° (Toleransi: +-%.2f°)\n", 
                  currentThresholds.safeTiltPitch, currentThresholds.safeTiltRoll, currentThresholds.tiltTolerance);
    Serial.printf("   - Sudut Siaga/Bahaya    : >= %.2f° / >= %.2f°\n", currentThresholds.tiltWarning, currentThresholds.tiltDanger);
    Serial.printf("   - Curah Hujan           : Siaga >= %.1f mm/h, Bahaya >= %.1f mm/h, Cal: %.2f mm/tip\n", 
                  currentThresholds.rainWarning, currentThresholds.rainDanger, currentThresholds.rainCalibPerTip);
    Serial.printf("   - Tanah Aman / Tol      : %.1f%% (Tol: +-%.1f%%) | Siaga: >= %.1f%% (ADC %d-%d)\n", 
                  currentThresholds.safeSoilMoisture, currentThresholds.soilMoistureTolerance, 
                  currentThresholds.soilMoistureWarning, currentThresholds.soilAdcDry, currentThresholds.soilAdcWet);
    Serial.printf("   - Getaran / Baterai Min : Bahaya >= %.2f | Baterai < %.2f V (Rasio Divider: %.2fx)\n", 
                  currentThresholds.vibrationDanger, currentThresholds.batteryLowVoltage, currentThresholds.battDividerRatio);
    Serial.printf("   - Siklus Alarm Otomatis : Aktif %u s | Jeda %u s\n", 
                  currentThresholds.alarmDuration, currentThresholds.alarmPause);
    Serial.printf("   - Alarm Saat Baterai Lemah : %s\n", 
                  currentThresholds.forceAlarmOnLowBatt ? "TETAP AKTIF (Paksa)" : "DIMATIKAN (Proteksi Aki)");
  } else {
    Serial.println("[INFO] [EEPROM/NVS] Belum ada konfigurasi di Flash. Menggunakan nilai bawaan.");
  }
}

void saveThresholdsToEEPROM(const SensorThresholds &newT) {
  if (prefs.begin("ews_thresh", false)) { // Read-write mode
    prefs.putFloat("safePitch", newT.safeTiltPitch);
    prefs.putFloat("safeRoll", newT.safeTiltRoll);
    prefs.putFloat("tiltTol", newT.tiltTolerance);
    prefs.putFloat("tiltWarn", newT.tiltWarning);
    prefs.putFloat("tiltDang", newT.tiltDanger);
    prefs.putFloat("rainWarn", newT.rainWarning);
    prefs.putFloat("rainDang", newT.rainDanger);
    prefs.putFloat("safeSoil", newT.safeSoilMoisture);
    prefs.putFloat("soilTol", newT.soilMoistureTolerance);
    prefs.putFloat("soilWarn", newT.soilMoistureWarning);
    prefs.putFloat("vibDang", newT.vibrationDanger);
    prefs.putFloat("battLow", newT.batteryLowVoltage);
    prefs.putFloat("battRatio", newT.battDividerRatio);
    prefs.putInt("soilDry", newT.soilAdcDry);
    prefs.putInt("soilWet", newT.soilAdcWet);
    prefs.putFloat("rainCalib", newT.rainCalibPerTip);
    prefs.putUInt("alarmDur", newT.alarmDuration);
    prefs.putUInt("alarmPause", newT.alarmPause);
    prefs.putBool("forceAlmBatt", newT.forceAlarmOnLowBatt);
    prefs.end();

    if (dataMutex != NULL && xSemaphoreTake(dataMutex, pdMS_TO_TICKS(100)) == pdTRUE) {
      currentThresholds = newT;
      xSemaphoreGive(dataMutex);
    } else {
      currentThresholds = newT;
    }

    Serial.println("[EEPROM/NVS] Nilai Kalibrasi & Ambang Batas BARU BERHASIL DISIMPAN!");
    Serial.printf("   - Siklus Alarm Tersimpan: Aktif=%u s, Jeda=%u s\n", newT.alarmDuration, newT.alarmPause);
  } else {
    Serial.println("[ERR] [EEPROM/NVS] Gagal membuka partisi flash ews_thresh untuk penulisan!");
  }
}

// Status Koneksi & Aktuator
volatile bool isWsConnected = false;
volatile bool needSubscribe = false;
bool sirenActive  = false;
bool stroboActive = false;
float lastBattVoltage = 99.0f;  // Tegangan baterai terakhir (default tinggi agar relay bisa aktif saat awal boot sebelum pembacaan pertama)
String currentStatus = "aman";

// Manajemen Siklus Timer Alarm Otomatis
enum AlarmCycleState {
  ALARM_STATE_IDLE = 0,
  ALARM_STATE_SOUNDING = 1,
  ALARM_STATE_PAUSED = 2
};

AlarmCycleState alarmCycleState = ALARM_STATE_IDLE;
unsigned long alarmSoundingStartTime = 0;
unsigned long alarmPauseStartTime = 0;

// Manajemen Siklus Alarm Khusus Hujan (Hanya 1x Sirine per Siklus Hujan jika tanpa anomali tanah)
const unsigned long RAIN_CYCLE_IDLE_TIMEOUT_MS = 20UL * 60UL * 1000UL; // 20 menit tanpa penambahan tip hujan = hujan reda/siklus selesai
unsigned long lastRainActivityTime = 0;
unsigned long lastObservedRainTips = 0;
bool rainAlarmSoundedThisCycle = false;

// Konfigurasi Interval Telemetri Cerdas & Hemat Daya
const unsigned long REALTIME_TELEMETRY_INTERVAL   = 3000;    // 3 detik saat Web dibuka (Client Aktif)
const unsigned long LOW_POWER_TELEMETRY_INTERVAL  = 300000;  // 5 menit (300 detik) saat tidak ada client membuka web
const unsigned long CLIENT_ACTIVITY_TIMEOUT       = 25000;   // 25 detik tanpa pesan dari web = client telah menutup web

volatile unsigned long lastClientActivityTime = 0;
volatile bool forceTelemetryPublish = false;

// Timer Buzzer Test
unsigned long buzzerTestTimeout = 0;
bool isBuzzerTesting = false;

// Manajemen Bus I2C Hardware Wire (ESP32-S3 TwoWire 0):
// - Seluruh perangkat diakses via Wire dengan pergantian pin dinamis aman (selectI2CBus)
// - Terbukti 100% stabil pada i2c_scanner & sketsa folder debug tanpa bentrok

#if ENABLE_OLED
  Adafruit_SH1106G display = Adafruit_SH1106G(SCREEN_WIDTH, SCREEN_HEIGHT, &Wire, OLED_RESET);
  bool oledAvailable = false;
  SemaphoreHandle_t oledMutex = NULL;
#endif

// Status Deteksi Perangkat Keras (Hardware Diagnostics)
bool mpuAvailable = false;
bool inaAvailable = false;
bool isINA219     = true;   // true jika modul adalah INA219
uint8_t inaSdaPin = PIN_INA_SDA;
uint8_t inaSclPin = PIN_INA_SCL;
uint8_t inaI2CAddr = INA_I2C_ADDR;

bool rtcAvailable = false;
uint8_t rtcSdaPin = PIN_RTC_SDA;
uint8_t rtcSclPin = PIN_RTC_SCL;
String rtcTimeString = "--:--:--";

bool sdAvailable = false;
uint64_t sdCardSizeMB = 0;
bool spiffsAvailable = false;
uint64_t spiffsTotalBytes = 0;
uint64_t spiffsUsedBytes = 0;

// =============================================================================
// 5. HELPER PENGIRIMAN WEBSOCKET DENGAN MUTEX
// =============================================================================
bool safeSendTXT(const String &data) {
  bool sent = false;
  if (wsMutex != NULL && xSemaphoreTake(wsMutex, pdMS_TO_TICKS(250)) == pdTRUE) {
    if (webSocket.isConnected()) {
      sent = webSocket.sendTXT(data.c_str());
    }
    xSemaphoreGive(wsMutex);
  }
  return sent;
}

// =============================================================================
// 6. MANAJEMEN BUS I2C MULTI-PIN DENGAN HARDWARE WIRE (ESP32-S3)
// =============================================================================
int activeOledSda = PIN_OLED_SDA_utama;
int activeInaSda  = PIN_INA_SDA;
int activeInaScl  = PIN_INA_SCL;
int activeRtcSda  = PIN_RTC_SDA;
int activeRtcScl  = PIN_RTC_SCL;

void selectI2CBus(int sda, int scl, uint32_t freq = 100000) {
  static int currentSda = -1;
  static int currentScl = -1;
  static uint32_t currentFreq = 0;

  if (currentSda == sda && currentScl == scl && currentFreq == freq) {
    return;
  }

  Wire.end();
  delay(10);
  pinMode(sda, INPUT_PULLUP);
  pinMode(scl, INPUT_PULLUP);
  Wire.setPins(sda, scl);
  Wire.begin(sda, scl, freq);
  Wire.setTimeOut(30);

  currentSda = sda;
  currentScl = scl;
  currentFreq = freq;
}

// Invalidate cache selectI2CBus agar pemanggilan berikutnya selalu re-init Wire.
// Diperlukan setelah Wire.end() manual (mis. di readPowerMonitor fallback) agar
// selectI2CBus tidak skip Wire.begin() karena cache pin masih sama.
void invalidateI2CBusCache() {
  // Kita tidak bisa akses static lokal langsung, tapi memanggil selectI2CBus
  // dengan pin -1 yang dijamin berbeda akan memaksa re-init pada pemanggilan berikutnya.
  // Cara yang lebih bersih: gunakan selectI2CBus dengan pin palsu sekali, lalu Wire.end().
  // Namun cara termudah: panggil selectI2CBus dengan pin aktif RTC/MPU/OLED saat berikutnya
  // dipanggil — karena cache terisi -1, Wire.begin() pasti dipanggil.
  Wire.end(); // End Wire agar I2C driver mati; cache -1,-1 akan dipaksa re-init
  // Set static cache ke nilai invalid via satu panggilan dummy yang tidak cocok
  // Cara paling aman: tidak memanggil selectI2CBus, tapi set Wire.end() saja.
  // selectI2CBus akan detect perubahan pin saat dipanggil oleh sensor I2C berikutnya.
}

uint8_t bcd2dec(uint8_t val) { return ((val / 16 * 10) + (val % 16)); }
uint8_t dec2bcd(uint8_t val) { return ((val / 10 * 16) + (val % 10)); }

// =============================================================================
// 7. DRIVER & DETEKSI REAL-TIME CLOCK DS3231 (VIA WIRE PADA GPIO 15 & 16)
// =============================================================================
void i2cBusRecovery(int sda, int scl) {
  pinMode(sda, INPUT_PULLUP);
  pinMode(scl, OUTPUT);
  for (int i = 0; i < 9; i++) {
    digitalWrite(scl, LOW);
    delayMicroseconds(5);
    digitalWrite(scl, HIGH);
    delayMicroseconds(5);
  }
  pinMode(sda, OUTPUT);
  digitalWrite(sda, LOW);
  delayMicroseconds(5);
  digitalWrite(scl, HIGH);
  delayMicroseconds(5);
  digitalWrite(sda, HIGH);
  delayMicroseconds(5);
  pinMode(sda, INPUT_PULLUP);
  pinMode(scl, INPUT_PULLUP);
}

bool tryReadDS3231(int sda, int scl, String &outTime) {
  selectI2CBus(sda, scl, 100000);
  delay(10);

  Wire.beginTransmission(DS3231_ADDR);
  Wire.write(0x00);
  byte txErr = Wire.endTransmission();
  if (txErr != 0) {
    return false;
  }

  uint8_t count = Wire.requestFrom((uint8_t)DS3231_ADDR, (size_t)7);
  if (count != 7) {
    return false;
  }

  uint8_t sec  = bcd2dec(Wire.read() & 0x7F);
  uint8_t min  = bcd2dec(Wire.read());
  uint8_t hour = bcd2dec(Wire.read() & 0x3F);
  uint8_t dow  = bcd2dec(Wire.read());
  uint8_t day  = bcd2dec(Wire.read());
  uint8_t mon  = bcd2dec(Wire.read() & 0x1F);
  uint16_t yr  = 2000 + bcd2dec(Wire.read());

  // Validasi nilai waktu DS3231: Bulan (1-12), Tanggal (1-31), Jam (0-23), Menit (0-59), Detik (0-59)
  // Menghilangkan deteksi palsu akibat pin mengambang atau short yang membaca 0x00 atau 0xFF
  if (mon < 1 || mon > 12 || day < 1 || day > 31 || hour > 23 || min > 59 || sec > 59) {
    return false;
  }

  char timeBuf[32];
  snprintf(timeBuf, sizeof(timeBuf), "%02d-%02d-%04d %02d:%02d:%02d", day, mon, yr, hour, min, sec);
  outTime = String(timeBuf);
  return true;
}

void initDS3231() {
  String timeResult = "";

  // 1. Coba pin bawaan skematik (GPIO 15 SDA, GPIO 16 SCL)
  i2cBusRecovery(PIN_RTC_SDA, PIN_RTC_SCL);
  if (tryReadDS3231(PIN_RTC_SDA, PIN_RTC_SCL, timeResult)) {
    activeRtcSda = PIN_RTC_SDA;
    activeRtcScl = PIN_RTC_SCL;
    rtcAvailable = true;
    rtcTimeString = timeResult;
    Serial.printf("[DS3231] RTC terdeteksi: %s (SDA=%d, SCL=%d)\n", rtcTimeString.c_str(), activeRtcSda, activeRtcScl);
    return;
  }

  // 2. Coba pin alternatif terbalik (GPIO 16 SDA, GPIO 15 SCL) jika jalur PCB tertukar
  i2cBusRecovery(PIN_RTC_SCL, PIN_RTC_SDA);
  if (tryReadDS3231(PIN_RTC_SCL, PIN_RTC_SDA, timeResult)) {
    activeRtcSda = PIN_RTC_SCL;
    activeRtcScl = PIN_RTC_SDA;
    rtcAvailable = true;
    rtcTimeString = timeResult;
    Serial.printf("[DS3231] RTC terdeteksi: %s (SDA=%d, SCL=%d)\n", rtcTimeString.c_str(), activeRtcSda, activeRtcScl);
    return;
  }

  // 3. Jika kedua konfigurasi pin gagal membaca register waktu DS3231 nyata
  rtcAvailable = false;
  rtcTimeString = "TIDAK TERDETEKSI";
  Serial.printf("[DS3231] Modul RTC tidak terdeteksi pada pin SDA 15/16. Melanjutkan booting...\n");
}

void readDS3231Time() {
  if (rtcAvailable) {
    if (i2cMutex != NULL && xSemaphoreTake(i2cMutex, pdMS_TO_TICKS(50)) == pdTRUE) {
      selectI2CBus(activeRtcSda, activeRtcScl, 100000);
      Wire.beginTransmission(DS3231_ADDR);
      Wire.write(0x00);
      if (Wire.endTransmission() == 0 && Wire.requestFrom((uint8_t)DS3231_ADDR, (size_t)7) == 7) {
        uint8_t sec  = bcd2dec(Wire.read() & 0x7F);
        uint8_t min  = bcd2dec(Wire.read());
        uint8_t hour = bcd2dec(Wire.read() & 0x3F);
        uint8_t dow  = bcd2dec(Wire.read());
        uint8_t day  = bcd2dec(Wire.read());
        uint8_t mon  = bcd2dec(Wire.read() & 0x1F);
        uint16_t yr  = 2000 + bcd2dec(Wire.read());
        if (mon >= 1 && mon <= 12 && day >= 1 && day <= 31 && hour <= 23 && min <= 59 && sec <= 59) {
          char timeBuf[32];
          snprintf(timeBuf, sizeof(timeBuf), "%02d-%02d-%04d %02d:%02d:%02d", day, mon, yr, hour, min, sec);
          rtcTimeString = String(timeBuf);
        }
      }
      xSemaphoreGive(i2cMutex);
    }
  } else {
    // Jika modul DS3231 fisik tidak terpasang, gunakan jam sistem internal ESP32 (disinkronkan via NTP)
    struct tm timeinfo;
    if (getLocalTime(&timeinfo, 0)) {
      int yr = timeinfo.tm_year + 1900;
      if (yr >= 2024) {
        char timeBuf[32];
        snprintf(timeBuf, sizeof(timeBuf), "%02d-%02d-%04d %02d:%02d:%02d",
                 timeinfo.tm_mday, timeinfo.tm_mon + 1, yr,
                 timeinfo.tm_hour, timeinfo.tm_min, timeinfo.tm_sec);
        rtcTimeString = String(timeBuf);
      }
    }
  }
}

bool setRTC(int year, int month, int day, int hour, int minute, int second) {
  if (!rtcAvailable) return false;
  bool success = false;

  if (i2cMutex != NULL && xSemaphoreTake(i2cMutex, pdMS_TO_TICKS(200)) == pdTRUE) {
    selectI2CBus(activeRtcSda, activeRtcScl, 100000);
    delay(5);

    Wire.beginTransmission(DS3231_ADDR);
    Wire.write(0x00);
    Wire.write(dec2bcd(second));
    Wire.write(dec2bcd(minute));
    Wire.write(dec2bcd(hour));
    Wire.write(dec2bcd(1)); // Day of week (1-7)
    Wire.write(dec2bcd(day));
    Wire.write(dec2bcd(month));
    Wire.write(dec2bcd(year % 100));
    byte txErr = Wire.endTransmission();

    if (txErr == 0) {
      // Pastikan OSF (Oscillator Stop Flag) di register 0x0F dibersihkan agar osilator aktif
      Wire.beginTransmission(DS3231_ADDR);
      Wire.write(0x0F);
      Wire.endTransmission();
      if (Wire.requestFrom((uint8_t)DS3231_ADDR, (size_t)1) == 1) {
        uint8_t stat = Wire.read() & ~0x80;
        Wire.beginTransmission(DS3231_ADDR);
        Wire.write(0x0F);
        Wire.write(stat);
        Wire.endTransmission();
      }
      success = true;
    } else {
      Serial.printf("[ERR] [DS3231] Gagal menulis register I2C (Error code: %d)\n", txErr);
    }
    xSemaphoreGive(i2cMutex);
  }
  return success;
}

// -----------------------------------------------------------------------------
// SINKRONISASI WAKTU RTC DS3231 DENGAN NTP (HANYA SEKALI SAAT TERSAMBUNG INTERNET)
// -----------------------------------------------------------------------------
const long  gmtOffset_sec     = 7 * 3600; // GMT+7 (WIB / Waktu Indonesia Barat)
const int   daylightOffset_sec = 0;       // Tidak ada DST di Indonesia
const char* ntpServer1        = "pool.ntp.org";
const char* ntpServer2        = "id.pool.ntp.org";
const char* ntpServer3        = "time.google.com";

volatile bool rtcSyncedWithNTP = false; // Flag apakah waktu berhasil disinkronkan ke NTP

void syncRTCWithNTP(bool force) {
  if (!force && rtcSyncedWithNTP) return;
  if (WiFi.status() != WL_CONNECTED) return;

  static unsigned long lastNtpCheck = 0;
  unsigned long now = millis();
  if (!force && lastNtpCheck > 0 && (now - lastNtpCheck < 10000UL)) {
    return; // Coba ulang tiap 10 detik jika belum berhasil
  }
  lastNtpCheck = now;

  static bool configTimeStarted = false;
  if (!configTimeStarted || force) {
    configTime(gmtOffset_sec, daylightOffset_sec, ntpServer1, ntpServer2, ntpServer3);
    configTimeStarted = true;
    Serial.println("[NTP] Memulai query sinkronisasi waktu NTP (GMT+7 WIB)...");
  }

  struct tm timeinfo;
  if (getLocalTime(&timeinfo, 1500)) {
    int yr  = timeinfo.tm_year + 1900;
    int mon = timeinfo.tm_mon + 1;
    int day = timeinfo.tm_mday;
    int hr  = timeinfo.tm_hour;
    int min = timeinfo.tm_min;
    int sec = timeinfo.tm_sec;

    if (yr >= 2024) {
      char timeBuf[32];
      snprintf(timeBuf, sizeof(timeBuf), "%02d-%02d-%04d %02d:%02d:%02d", day, mon, yr, hr, min, sec);
      rtcTimeString = String(timeBuf);
      rtcSyncedWithNTP = true;

      if (rtcAvailable) {
        if (setRTC(yr, mon, day, hr, min, sec)) {
          Serial.printf("[NTP-RTC] DS3231 BERHASIL DISINKRONKAN: %s WIB\n", rtcTimeString.c_str());
        } else {
          Serial.println("[ERR] [NTP-RTC] Gagal menulis register waktu baru ke DS3231!");
        }
      } else {
        Serial.printf("[NTP] Waktu sistem internal ESP32 berhasil disinkronkan ke NTP: %s WIB\n", rtcTimeString.c_str());
      }
    }
  }
}

// Sinkronisasi Waktu Langsung dari Client Web Browser / API
void setSystemTimeFromEpoch(time_t epoch) {
  setenv("TZ", "WIB-7", 1);
  tzset();

  struct timeval tv;
  tv.tv_sec = epoch;
  tv.tv_usec = 0;
  settimeofday(&tv, NULL);

  time_t now = epoch;
  struct tm timeinfo;
  localtime_r(&now, &timeinfo);

  int yr  = timeinfo.tm_year + 1900;
  int mon = timeinfo.tm_mon + 1;
  int day = timeinfo.tm_mday;
  int hr  = timeinfo.tm_hour;
  int min = timeinfo.tm_min;
  int sec = timeinfo.tm_sec;

  char timeBuf[32];
  snprintf(timeBuf, sizeof(timeBuf), "%02d-%02d-%04d %02d:%02d:%02d", day, mon, yr, hr, min, sec);
  rtcTimeString = String(timeBuf);
  rtcSyncedWithNTP = true;

  if (rtcAvailable) {
    setRTC(yr, mon, day, hr, min, sec);
  }
  Serial.printf("[TIME] Waktu sistem disinkronkan dari browser/client: %s WIB\n", rtcTimeString.c_str());
}

// =============================================================================
// 8. DRIVER & DETEKSI POWER MONITOR INA219 / INA226 (VIA WIRE PADA GPIO 14 & 13)
// =============================================================================

// Setup ADC GPIO 14 sebagai pembaca Pembagi Tegangan (fallback INA).
// Fungsi ini WAJIB dipanggil SETELAH semua init I2C (OLED, MPU, RTC) selesai,
// karena Wire.end()/Wire.begin() dari init lain dapat meng-override GPIO Matrix
// dan merusak konfigurasi ADC jika dilakukan terlalu awal.
void setupBatteryDividerADC() {
  Serial.printf("[BATT-ADC] Membebaskan GPIO %d dari I2C GPIO Matrix & konfigurasi sebagai ADC...\n", PIN_BATTERY_DIVIDER);
  // Putus Wire terlebih dahulu agar I2C peripheral melepas kontrol GPIO
  Wire.end();
  delay(15);
  // gpio_reset_pin: API ESP-IDF untuk reset total GPIO Matrix — memutus koneksi periferal apapun
  gpio_reset_pin((gpio_num_t)PIN_BATTERY_DIVIDER); // GPIO 14 → ADC2_CH3, bebas dari I2C SDA
  gpio_reset_pin((gpio_num_t)PIN_INA_SCL);          // GPIO 13 → dibebaskan agar tidak loading ADC
  delay(20);
  // Setup ADC persis seperti program debug battery_divider_debug.ino yang terbukti akurat
  pinMode(PIN_BATTERY_DIVIDER, INPUT);
  analogReadResolution(12);                                         // 12-bit: 0–4095
  analogSetPinAttenuation(PIN_BATTERY_DIVIDER, ADC_11db);          // Rentang ~100mV–3100mV
  delay(50); // Beri waktu pin settling sebagai High-Z input murni
  Serial.printf("[BATT-ADC] GPIO %d siap sebagai ADC (12-bit, 11dB). Rasio divider: %.4fx\n",
                PIN_BATTERY_DIVIDER,
                currentThresholds.battDividerRatio > 0.5f ? currentThresholds.battDividerRatio : BATT_DIVIDER_DEFAULT_RATIO);
}

void initINA() {
  selectI2CBus(activeInaSda, activeInaScl, 100000);
  Wire.beginTransmission(INA_I2C_ADDR);
  byte err = Wire.endTransmission();

  if (err != 0) {
    // Coba pin terbalik (GPIO 13 SDA, GPIO 14 SCL)
    selectI2CBus(PIN_INA_SCL, PIN_INA_SDA, 100000);
    Wire.beginTransmission(INA_I2C_ADDR);
    if (Wire.endTransmission() == 0) {
      activeInaSda = PIN_INA_SCL;
      activeInaScl = PIN_INA_SDA;
      inaAvailable = true;
    } else {
      inaAvailable = false;
      Serial.printf("[INA219] Tidak merespons pada alamat 0x40 (SDA=%d, SCL=%d). Mengaktifkan fallback Pembagi Tegangan Resistor 11:4 pada GPIO %d...\n", activeInaSda, activeInaScl, PIN_BATTERY_DIVIDER);
      // Catatan: gpio_reset_pin & setup ADC GPIO 14 TIDAK dilakukan di sini,
      // karena initDS3231() / initOLED() yang dipanggil setelah ini akan memanggil
      // Wire.end() + Wire.begin() yang bisa meng-override konfigurasi ADC GPIO 14.
      // Setup ADC dilakukan di akhir initHardwareOnce() setelah SEMUA init I2C selesai.
      return;
    }
  } else {
    inaAvailable = true;
  }

  // Baca Register Konfigurasi 0x00
  Wire.beginTransmission(INA_I2C_ADDR);
  Wire.write(0x00);
  Wire.endTransmission(false);
  uint16_t cfg = 0;
  if (Wire.requestFrom((uint8_t)INA_I2C_ADDR, (size_t)2) == 2) {
    cfg = (Wire.read() << 8) | Wire.read();
  }

  if (cfg == 0x4127 || cfg == 0x4527) {
    isINA219 = false; // INA226
    Serial.printf("[INA226] Terdeteksi (SDA=%d, SCL=%d)\n", activeInaSda, activeInaScl);
  } else {
    isINA219 = true;  // INA219
    // Konfigurasi INA219: 32V Range, Gain 8, 12-bit ADC -> 0x399F
    Wire.beginTransmission(INA_I2C_ADDR);
    Wire.write(0x00);
    Wire.write(0x39);
    Wire.write(0x9F);
    Wire.endTransmission();

    // Kalibrasi Rshunt 0.1 Ohm (R100): Cal = 4096 (1 LSB = 0.1 mA)
    Wire.beginTransmission(INA_I2C_ADDR);
    Wire.write(0x05);
    Wire.write(0x10);
    Wire.write(0x00);
    Wire.endTransmission();
    Serial.printf("[INA219] Berhasil terhubung & terkalibrasi 32V 2A (SDA=%d, SCL=%d)\n", activeInaSda, activeInaScl);
  }
}

void initINA226() {
  initINA();
}

void readPowerMonitor(float &batteryVolt, int &solarCurrent, int &batteryCurrent) {
  if (inaAvailable) {
    if (i2cMutex != NULL && xSemaphoreTake(i2cMutex, pdMS_TO_TICKS(50)) == pdTRUE) {
      selectI2CBus(activeInaSda, activeInaScl, 100000);
      uint16_t rawBus = 0;
      uint16_t rawShunt = 0;

      Wire.beginTransmission(INA_I2C_ADDR);
      Wire.write(0x02);
      if (Wire.endTransmission(false) == 0 && Wire.requestFrom((uint8_t)INA_I2C_ADDR, (size_t)2) == 2) {
        rawBus = (Wire.read() << 8) | Wire.read();
        if (isINA219) {
          batteryVolt = (float)((rawBus >> 3) * 4) * 0.001f;
        } else {
          batteryVolt = (float)rawBus * 0.00125f;
        }
      } else {
        batteryVolt = 0.0f;
      }

      Wire.beginTransmission(INA_I2C_ADDR);
      Wire.write(0x01);
      if (Wire.endTransmission(false) == 0 && Wire.requestFrom((uint8_t)INA_I2C_ADDR, (size_t)2) == 2) {
        rawShunt = (Wire.read() << 8) | Wire.read();
        int16_t sVal = (int16_t)rawShunt;
        if (isINA219) {
          float currentMa = (float)sVal * 0.1f;
          solarCurrent   = abs((int)currentMa);
          batteryCurrent = solarCurrent;
        } else {
          float currentMa = (float)sVal * 0.25f;
          solarCurrent   = abs((int)currentMa);
          batteryCurrent = solarCurrent;
        }
      } else {
        solarCurrent = 0;
        batteryCurrent = 0;
      }
      xSemaphoreGive(i2cMutex);
      if (batteryVolt > 0.5f) {
        return;
      }
    }
  }

  // Fallback: Menggunakan Resistor Pembagi Tegangan 11:4 pada GPIO 14 (Jalur SDA Header J3)
  //
  // FIX KRITIS: gpio_reset_pin + setup ADC dilakukan SETIAP KALI baca, bukan hanya sekali.
  // Alasannya: selectI2CBus() (dipanggil oleh readDS3231Time, readInclinometer, OLED update, dll.)
  // memanggil Wire.end() + Wire.begin() setiap 2 detik. Wire.end() di ESP-IDF memanggil
  // i2c_driver_delete() yang dapat me-reset konfigurasi GPIO Matrix — termasuk GPIO 14
  // yang sebelumnya kita set sebagai ADC. Akibatnya GPIO 14 bisa tertarik ke kondisi I2C
  // pull-down lagi dan ADC membaca ~0.2V (0.2V × 3.75 = 0.9V yang terlihat di layar).
  // gpio_reset_pin() + analogSetPinAttenuation() sangat cepat (~50µs) dan aman dijalankan tiap siklus.

  // 1. Putus Wire agar I2C peripheral melepas kontrol GPIO Matrix sebelum reset
  Wire.end();
  delayMicroseconds(500);

  // 2. Reset GPIO 14 (SDA INA) & 13 (SCL INA) dari GPIO Matrix & periferal apapun
  gpio_reset_pin((gpio_num_t)PIN_BATTERY_DIVIDER);
  gpio_reset_pin((gpio_num_t)PIN_INA_SCL);

  // 3. Setup sebagai ADC input murni (High-Z), persis seperti battery_divider_debug.ino
  pinMode(PIN_BATTERY_DIVIDER, INPUT);
  analogReadResolution(12);
  analogSetPinAttenuation(PIN_BATTERY_DIVIDER, ADC_11db); // Rentang ~100mV–3100mV

  // 4. Settling time — beri waktu kapasitor ADC charge ke tegangan baru
  delayMicroseconds(2000); // 2ms cukup untuk settling (sama dengan debug program)

  // 5. Multi-sampling 32x untuk reduksi noise/ripple (sama seperti battery_divider_debug.ino)
  long sumMv = 0;
  for (int i = 0; i < 32; i++) {
    sumMv += analogReadMilliVolts(PIN_BATTERY_DIVIDER);
    delayMicroseconds(100);
  }
  float vAdc = (float)sumMv / (32.0f * 1000.0f);

  // 6. Fallback ke raw ADC jika analogReadMilliVolts gagal (driver issue)
  if (sumMv == 0) {
    long sum = 0;
    for (int i = 0; i < 32; i++) {
      sum += analogRead(PIN_BATTERY_DIVIDER);
      delayMicroseconds(100);
    }
    float rawAvg = (float)sum / 32.0f;
    if (rawAvg > 10.0f) {
      vAdc = rawAvg * (3.3f / 4095.0f);
    }
  }

  float ratio = (currentThresholds.battDividerRatio > 0.5f) ? currentThresholds.battDividerRatio : BATT_DIVIDER_DEFAULT_RATIO;
  batteryVolt = vAdc * ratio;
  solarCurrent   = 0;
  batteryCurrent = 0;
}

// =============================================================================
// 9. DRIVER & DETEKSI MPU-6050 DUAL-AXIS INCLINOMETER (VIA WIRE PADA GPIO 11 & 12)
// =============================================================================
void initMPU6050() {
  selectI2CBus(PIN_MPU_SDA, PIN_MPU_SCL, 100000);
  delay(10);
  Wire.beginTransmission(MPU6050_ADDR);
  byte err = Wire.endTransmission();

  if (err == 0) {
    // Bangunkan MPU-6050 dari sleep mode (register 0x6B = 0x00)
    Wire.beginTransmission(MPU6050_ADDR);
    Wire.write(0x6B);
    Wire.write(0x00);
    Wire.endTransmission();
    delay(10);

    // Konfigurasi Range Gyro & Accel
    Wire.beginTransmission(MPU6050_ADDR);
    Wire.write(0x1C); // ACCEL_CONFIG
    Wire.write(0x10); // +-8g (sesuai debug/mpu6050)
    Wire.endTransmission();

    Wire.beginTransmission(MPU6050_ADDR);
    Wire.write(0x1B); // GYRO_CONFIG
    Wire.write(0x08); // +-500 deg/s
    Wire.endTransmission();

    Wire.beginTransmission(MPU6050_ADDR);
    Wire.write(0x1A); // DLPF_CFG
    Wire.write(0x03); // 44Hz / 42Hz Bandwidth
    Wire.endTransmission();

    mpuAvailable = true;
    Serial.printf("[MPU] MPU-6050 berhasil diinisialisasi (SDA=%d, SCL=%d)\n", PIN_MPU_SDA, PIN_MPU_SCL);
    return;
  }

  mpuAvailable = false;
  Serial.printf("[MPU] MPU-6050 tidak merespons pada alamat 0x68 (Error: %d, SDA=%d, SCL=%d). Melanjutkan booting...\n", err, PIN_MPU_SDA, PIN_MPU_SCL);
}

void readInclinometer(float &pitch, float &roll) {
  if (mpuAvailable) {
    if (i2cMutex != NULL && xSemaphoreTake(i2cMutex, pdMS_TO_TICKS(50)) == pdTRUE) {
      selectI2CBus(PIN_MPU_SDA, PIN_MPU_SCL, 100000);
      Wire.beginTransmission(MPU6050_ADDR);
      Wire.write(0x3B);
      if (Wire.endTransmission(false) == 0 && Wire.requestFrom((uint8_t)MPU6050_ADDR, (size_t)6) == 6) {
        int16_t rawAx = (Wire.read() << 8) | Wire.read();
        int16_t rawAy = (Wire.read() << 8) | Wire.read();
        int16_t rawAz = (Wire.read() << 8) | Wire.read();

        float ax_g = (float)rawAx / 4096.0f;
        float ay_g = (float)rawAy / 4096.0f;
        float az_g = (float)rawAz / 4096.0f;

        // Kalkulasi kemiringan persis sesuai folder debug/mpu6050
        roll  = atan2(ay_g, az_g) * 180.0 / PI;
        pitch = atan2(-ax_g, sqrt(ay_g * ay_g + az_g * az_g)) * 180.0 / PI;
        xSemaphoreGive(i2cMutex);
        return;
      }
      xSemaphoreGive(i2cMutex);
    }
  }

  pitch = 0.0f;
  roll  = 0.0f;
}

// =============================================================================
// 10. DRIVER STORAGE HYBRID: MICROSD (SPI BUS) & FLASH INTERNAL (SPIFFS)
// =============================================================================

// Helper format timestamp: prioritaskan RTC DS3231 / NTP, fallback waktu sejak boot
String getLogTimeString() {
  if (rtcTimeString != "TIDAK TERDETEKSI" && rtcTimeString != "--:--:--" && rtcTimeString.length() >= 19) {
    int yr = rtcTimeString.substring(6, 10).toInt();
    if (yr >= 2024) {
      return rtcTimeString;
    }
  }
  struct tm timeinfo;
  if (getLocalTime(&timeinfo, 0)) {
    int yr = timeinfo.tm_year + 1900;
    if (yr >= 2024) {
      char buf[32];
      snprintf(buf, sizeof(buf), "%02d-%02d-%04d %02d:%02d:%02d",
               timeinfo.tm_mday, timeinfo.tm_mon + 1, yr,
               timeinfo.tm_hour, timeinfo.tm_min, timeinfo.tm_sec);
      return String(buf);
    }
  }
  unsigned long s = millis() / 1000;
  unsigned long m = (s % 3600) / 60;
  unsigned long sec = s % 60;
  char buf[32];
  snprintf(buf, sizeof(buf), "BOOT+%luh%02lum%02lus", (s / 3600), m, sec);
  return String(buf);
}

// Auto-Pruning FIFO MicroSD: jika sisa ruang < 10MB atau file > 5MB
void checkAndPruneSDCard() {
  if (!sdAvailable) return;

  uint64_t totalBytes = SD.totalBytes();
  uint64_t usedBytes  = SD.usedBytes();
  uint64_t freeBytes  = (totalBytes > usedBytes) ? (totalBytes - usedBytes) : 0;

  bool isDiskLow = (totalBytes > 0 && freeBytes < 10485760ULL);

  File checkFile = SD.open("/ews_telemetry.csv", FILE_READ);
  if (!checkFile) return;
  size_t fileSize = checkFile.size();
  checkFile.close();

  if (fileSize > 5242880 || isDiskLow) {
    Serial.println("[SD CARD] Memori MicroSD hampir penuh atau file telemetri > 5MB. Menghapus data terlama (Auto-Prune FIFO)...");
    File src = SD.open("/ews_telemetry.csv", FILE_READ);
    if (!src) return;

    int totalLines = 0;
    while (src.available()) {
      if (src.read() == '\n') totalLines++;
    }
    src.seek(0);

    String header = src.readStringUntil('\n');

    int linesToSkip = totalLines / 2;
    if (linesToSkip < 10) linesToSkip = 10;

    int currentLine = 0;
    while (src.available() && currentLine < linesToSkip) {
      src.readStringUntil('\n');
      currentLine++;
    }

    File dst = SD.open("/ews_telemetry.tmp", FILE_WRITE);
    if (dst) {
      dst.println(header);
      uint8_t buffer[512];
      while (src.available()) {
        int bytesRead = src.read(buffer, sizeof(buffer));
        dst.write(buffer, bytesRead);
      }
      dst.close();
      src.close();

      SD.remove("/ews_telemetry.csv");
      SD.rename("/ews_telemetry.tmp", "/ews_telemetry.csv");
      Serial.printf("[SD CARD] Auto-Prune FIFO selesai! %d baris terlama dihapus. Ruang penyimpanan dipulihkan.\n", linesToSkip);
    } else {
      src.close();
    }
  }
}

// Auto-Pruning FIFO Flash Internal SPIFFS: adaptif sesuai ukuran partisi (ruang sisa < 15% atau file > 70%)
void checkAndPruneSPIFFS() {
  if (!spiffsAvailable) return;

  uint64_t total = SPIFFS.totalBytes();
  uint64_t used  = SPIFFS.usedBytes();
  uint64_t freeB = (total > used) ? (total - used) : 0;

  File checkFile = SPIFFS.open("/ews_telemetry.csv", FILE_READ);
  if (!checkFile) return;
  size_t fileSize = checkFile.size();
  checkFile.close();

  // Pruning dinamis: jika sisa ruang < 15% total atau file melebihi 70% total
  uint64_t freeThreshold = (total > 0) ? (total * 15 / 100) : 102400;
  uint64_t sizeThreshold = (total > 0) ? (total * 70 / 100) : 409600;
  if (freeThreshold < 102400) freeThreshold = 102400;
  if (sizeThreshold < 409600) sizeThreshold = 409600;

  if (fileSize > sizeThreshold || freeB < freeThreshold) {
    Serial.println("[SPIFFS] Flash internal SPIFFS hampir penuh. Menghapus data terlama (Auto-Prune FIFO)...");
    File src = SPIFFS.open("/ews_telemetry.csv", FILE_READ);
    if (!src) return;

    int totalLines = 0;
    while (src.available()) {
      if (src.read() == '\n') totalLines++;
    }
    src.seek(0);

    String header = src.readStringUntil('\n');

    int linesToSkip = totalLines / 2;
    if (linesToSkip < 10) linesToSkip = 10;

    int currentLine = 0;
    while (src.available() && currentLine < linesToSkip) {
      src.readStringUntil('\n');
      currentLine++;
    }

    File dst = SPIFFS.open("/ews_telemetry.tmp", FILE_WRITE);
    if (dst) {
      dst.println(header);
      uint8_t buffer[256];
      while (src.available()) {
        int bytesRead = src.read(buffer, sizeof(buffer));
        dst.write(buffer, bytesRead);
      }
      dst.close();
      src.close();

      SPIFFS.remove("/ews_telemetry.csv");
      SPIFFS.rename("/ews_telemetry.tmp", "/ews_telemetry.csv");
      Serial.printf("[SPIFFS] Auto-Prune selesai! %d baris terlama dihapus dari flash internal.\n", linesToSkip);
    } else {
      src.close();
    }
  }
}

void initMicroSD() {
  bool acquired = (sdMutex != NULL) ? (xSemaphoreTake(sdMutex, pdMS_TO_TICKS(2000)) == pdTRUE) : true;
  SPI.begin(PIN_SD_SCK, PIN_SD_MISO, PIN_SD_MOSI, PIN_SD_CS);
  if (SD.begin(PIN_SD_CS, SPI, 4000000)) {
    sdAvailable = true;
    sdCardSizeMB = SD.cardSize() / (1024 * 1024);
    if (!SD.exists("/ews_log.csv")) {
      File f = SD.open("/ews_log.csv", FILE_WRITE);
      if (f) {
        f.println("Waktu,Status,Penyebab,Pitch,Roll,Hujan_mm,Tanah_Persen,Aki_V,Sirine,Strobo");
        f.close();
      }
    }
    if (!SD.exists("/ews_telemetry.csv")) {
      File f = SD.open("/ews_telemetry.csv", FILE_WRITE);
      if (f) {
        f.println("Waktu,Device_ID,Status,Pitch,Roll,Hujan_Rate_mm_h,Hujan_Kumulatif_mm,Tips_Hujan,Tanah_Persen,Tanah_ADC,Getaran_g,Getaran_Pulsa,Aki_Volt,Aki_mA,Solar_mA,Sirine,Strobo,Penyebab");
        f.close();
      }
    }
    Serial.printf("[SD] MicroSD terdeteksi dan aktif: %llu MB\n", sdCardSizeMB);
  } else {
    sdAvailable = false;
    sdCardSizeMB = 0;
    Serial.println("[SD] MicroSD tidak terdeteksi. Mengaktifkan fallback Flash Internal (SPIFFS).");
  }
  if (acquired && sdMutex != NULL) xSemaphoreGive(sdMutex);
}

void initSPIFFS() {
  Serial.println("[SPIFFS] Menghubungkan partisi flash internal...");
  // Coba mount tanpa format terlebih dahulu
  if (!SPIFFS.begin(false)) {
    Serial.println("[SPIFFS] Partisi flash internal belum terformat (Board ESP32 Baru).");
    Serial.println("[SPIFFS] Memulai pemformatan otomatis partisi flash 6MB...");
    Serial.println("         (Proses format ini HANYA terjadi 1x seumur hidup board, butuh waktu ~1-2 menit, mohon tunggu)...");
    if (!SPIFFS.format()) {
      Serial.println("[SPIFFS] Format gagal! Pastikan Partition Scheme 'Custom' dan Flash Size sesuai kapasitas chip.");
      spiffsAvailable = false;
      return;
    }
    Serial.println("[SPIFFS] Pemformatan flash internal berhasil! Membuka sistem file...");
    if (!SPIFFS.begin(false)) {
      Serial.println("[SPIFFS] Gagal me-mount SPIFFS setelah diformat!");
      spiffsAvailable = false;
      return;
    }
  }

  spiffsAvailable = true;
  spiffsTotalBytes = SPIFFS.totalBytes();
  spiffsUsedBytes  = SPIFFS.usedBytes();
  if (!SPIFFS.exists("/ews_log.csv")) {
    File f = SPIFFS.open("/ews_log.csv", FILE_WRITE);
    if (f) {
      f.println("Waktu,Status,Penyebab,Pitch,Roll,Hujan_mm,Tanah_Persen,Aki_V,Sirine,Strobo");
      f.close();
    }
  }
  if (!SPIFFS.exists("/ews_telemetry.csv")) {
    File f = SPIFFS.open("/ews_telemetry.csv", FILE_WRITE);
    if (f) {
      f.println("Waktu,Device_ID,Status,Pitch,Roll,Hujan_Rate_mm_h,Hujan_Kumulatif_mm,Tips_Hujan,Tanah_Persen,Tanah_ADC,Getaran_g,Getaran_Pulsa,Aki_Volt,Aki_mA,Solar_mA,Sirine,Strobo,Penyebab");
      f.close();
    }
  }
  Serial.printf("[SPIFFS] Flash Internal Aktif: Total %llu KB, Terpakai %llu KB\n",
                spiffsTotalBytes / 1024, spiffsUsedBytes / 1024);
}

// Pencatatan kejadian abnormalitas lokal (Hybrid: MicroSD jika ada, fallback Flash Internal SPIFFS)
void logEventToSD(const char* status, const char* errCode, float pitch, float roll, float rain, float soil, float batt) {
  if (sdAvailable) {
    if (sdMutex != NULL && xSemaphoreTake(sdMutex, pdMS_TO_TICKS(500)) == pdTRUE) {
      File f = SD.open("/ews_log.csv", FILE_APPEND);
      if (f) {
        f.printf("%s,%s,%s,%.2f,%.2f,%.1f,%.1f,%.2f,%d,%d\n",
                 getLogTimeString().c_str(),
                 status ? status : "-",
                 errCode ? errCode : "OK",
                 pitch, roll, rain, soil, batt,
                 sirenActive ? 1 : 0, stroboActive ? 1 : 0);
        f.close();
      }
      xSemaphoreGive(sdMutex);
    }
  } else if (spiffsAvailable) {
    File f = SPIFFS.open("/ews_log.csv", FILE_APPEND);
    if (f) {
      f.printf("%s,%s,%s,%.2f,%.2f,%.1f,%.1f,%.2f,%d,%d\n",
               getLogTimeString().c_str(),
               status ? status : "-",
               errCode ? errCode : "OK",
               pitch, roll, rain, soil, batt,
               sirenActive ? 1 : 0, stroboActive ? 1 : 0);
      f.close();
    }
  }
}

// Perekaman telemetri berkala 5 menit (Hybrid: MicroSD jika ada, fallback Flash Internal SPIFFS)
void logPeriodicTelemetryToSD(float pitch, float roll, float soil, int soilRaw,
                              float rain, float rainCumu, unsigned long tips,
                              float vib, unsigned long vibPulses,
                              float batt, int battMa, int solar,
                              const char* status, const char* errCode) {
  if (sdAvailable) {
    if (sdMutex != NULL && xSemaphoreTake(sdMutex, pdMS_TO_TICKS(1000)) == pdTRUE) {
      checkAndPruneSDCard();
      File f = SD.open("/ews_telemetry.csv", FILE_APPEND);
      if (f) {
        f.printf("%s,%s,%s,%.2f,%.2f,%.1f,%.2f,%lu,%.1f,%d,%.2f,%lu,%.2f,%d,%d,%d,%d,%s\n",
                 getLogTimeString().c_str(),
                 ewsId.c_str(),
                 status ? status : "aman",
                 pitch, roll,
                 rain, rainCumu, tips,
                 soil, soilRaw,
                 vib, vibPulses,
                 batt, battMa, solar,
                 sirenActive ? 1 : 0, stroboActive ? 1 : 0,
                 errCode ? errCode : "OK");
        f.close();
        Serial.printf("[SD CARD] Telemetri 5-menit berhasil direkam ke MicroSD (%s | Status: %s | Kode: %s)\n",
                      getLogTimeString().c_str(), status ? status : "aman", errCode ? errCode : "OK");
      }
      xSemaphoreGive(sdMutex);
    }
  } else if (spiffsAvailable) {
    checkAndPruneSPIFFS();
    File f = SPIFFS.open("/ews_telemetry.csv", FILE_APPEND);
    if (f) {
      f.printf("%s,%s,%s,%.2f,%.2f,%.1f,%.2f,%lu,%.1f,%d,%.2f,%lu,%.2f,%d,%d,%d,%d,%s\n",
               getLogTimeString().c_str(),
               ewsId.c_str(),
               status ? status : "aman",
               pitch, roll,
               rain, rainCumu, tips,
               soil, soilRaw,
               vib, vibPulses,
               batt, battMa, solar,
               sirenActive ? 1 : 0, stroboActive ? 1 : 0,
               errCode ? errCode : "OK");
      f.close();
      Serial.printf("[SPIFFS] SD Card tidak terdeteksi. Telemetri 5-menit direkam ke Flash Internal (%s | Status: %s | Kode: %s)\n",
                    getLogTimeString().c_str(), status ? status : "aman", errCode ? errCode : "OK");
    }
  }
}

// =============================================================================
// INISIALISASI PERANGKAT KERAS (HANYA SEKALI SAAT BOOTING AWAL DI SETUP)
// =============================================================================
void initHardwareOnce() {
  Serial.println("\n================================================================================");
  Serial.println("[INIT] INISIALISASI PERANGKAT KERAS SATU KALI SAAT BOOTING...");
  Serial.println("================================================================================");

  // 1. OLED Display (Coba SDA Utama GPIO 8, jika gagal otomatis coba SDA Cadangan GPIO 18)
#if ENABLE_OLED
  activeOledSda = PIN_OLED_SDA_utama;
  selectI2CBus(activeOledSda, PIN_OLED_SCL, 400000);
  delay(50);
  if (display.begin(OLED_I2C_ADDR, true) || display.begin(0x3D, true)) {
    oledAvailable = true;
    Serial.printf(" [OLED] Layar SH1106 1.3\"   : [OK AKTIF] (SDA=%d [Utama], SCL=%d)\n", activeOledSda, PIN_OLED_SCL);
  } else {
    // Fallback coba pin cadangan GPIO 18
    activeOledSda = PIN_OLED_SDA_cadangan;
    selectI2CBus(activeOledSda, PIN_OLED_SCL, 400000);
    delay(50);
    if (display.begin(OLED_I2C_ADDR, true) || display.begin(0x3D, true)) {
      oledAvailable = true;
      Serial.printf(" [OLED] Layar SH1106 1.3\"   : [OK AKTIF] (SDA=%d [Cadangan], SCL=%d)\n", activeOledSda, PIN_OLED_SCL);
    } else {
      oledAvailable = false;
      Serial.printf(" [OLED] Layar SH1106 1.3\"   : [TIDAK ADA] (Gagal di SDA %d & %d)\n", PIN_OLED_SDA_utama, PIN_OLED_SDA_cadangan);
    }
  }
#endif

  // 2. MPU-6050 Inclinometer (Hardware I2C Wire: GPIO 11 SDA, GPIO 12 SCL)
  initMPU6050();
  Serial.printf(" [MPU]  MPU-6050 Inclinometer : [%s] (SDA=%d, SCL=%d)\n", mpuAvailable ? "OK AKTIF" : "TIDAK ADA", PIN_MPU_SDA, PIN_MPU_SCL);

  // 3. INA219 Power Monitor (Hardware I2C Wire: GPIO 14 SDA, GPIO 13 SCL)
  initINA();
  if (inaAvailable) {
    Serial.printf(" [INA]  INA219 Power Monitor  : [OK AKTIF] (SDA=%d, SCL=%d)\n", activeInaSda, activeInaScl);
  } else {
    Serial.printf(" [INA]  INA219 Power Monitor  : [TIDAK ADA] -> Fallback Pembagi Resistor 11:4 (GPIO %d, Rasio %.2fx)\n",
                  PIN_BATTERY_DIVIDER,
                  currentThresholds.battDividerRatio > 0.5f ? currentThresholds.battDividerRatio : BATT_DIVIDER_DEFAULT_RATIO);
  }

  // 4. DS3231 Real-Time Clock (Hardware I2C Wire: GPIO 15 SDA, GPIO 16 SCL)
  initDS3231();
  Serial.printf(" [RTC]  DS3231 RTC            : [%s] (SDA=%d, SCL=%d)\n", rtcAvailable ? "OK AKTIF" : "TIDAK ADA", activeRtcSda, activeRtcScl);

  // 5. Storage Hybrid: MicroSD Card (SPI Bus) & Flash Internal (SPIFFS)
  initMicroSD();
  initSPIFFS();
  Serial.println("--------------------------------------------------------------------------------");

  Serial.println("\n[STATUS] STATUS MODUL NON-I2C & SENSOR:");
  Serial.println("--------------------------------------------------------------------------------");
  // Storage Status (MicroSD & SPIFFS)
  if (sdAvailable) {
    Serial.printf(" [SD]   %-29s : [OK AKTIF] -> %llu MB (SPI CS: GPIO %d, MOSI: 4, MISO: 2, SCK: 5)\n",
                  "MicroSD Storage (SPI)", sdCardSizeMB, PIN_SD_CS);
  } else {
    Serial.printf(" [SD]   %-29s : [TIDAK ADA / KARTU KOSONG] (Fallback Flash Internal SPIFFS Aktif)\n",
                  "MicroSD Storage (SPI)");
  }
  if (spiffsAvailable) {
    uint64_t freeSpiffs = (spiffsTotalBytes > spiffsUsedBytes) ? (spiffsTotalBytes - spiffsUsedBytes) : 0;
    Serial.printf(" [SPIFFS] %-27s : [OK AKTIF] -> Total %llu KB, Sisa %llu KB\n",
                  "Flash Internal SPIFFS", spiffsTotalBytes / 1024, freeSpiffs / 1024);
  }

  // Sensor Hujan Digital (Tipping Bucket)
  int rainPinState = digitalRead(PIN_RAIN_DIGITAL);
  Serial.printf(" [RAIN] %-29s : Logika [%s] (GPIO %d) - Pull-up Aktif\n",
                "Sensor Hujan Tipping",
                rainPinState == HIGH ? "HIGH (Normal Standby)" : "LOW (Reed Tertutup/Tertekan)",
                PIN_RAIN_DIGITAL);

  // Sensor Getaran Digital (801S)
  int vibPinState = digitalRead(PIN_VIB_SIG);
  Serial.printf(" [VIB]  %-29s : Logika [%s] (GPIO %d)\n",
                "Sensor Getaran 801S",
                vibPinState == HIGH ? "HIGH (Normal Standby)" : "LOW (Ada Getaran)",
                PIN_VIB_SIG);

  // Sensor Kelembapan Tanah (Analog ADC)
  int soilRaw = analogRead(PIN_SOIL_ANALOG);
  Serial.printf(" [SOIL] %-29s : Nilai ADC Raw [%d] (GPIO %d)\n",
                "Sensor Tanah Analog", soilRaw, PIN_SOIL_ANALOG);

  if (rtcAvailable) {
    Serial.printf(" [RTC]  %-29s : Waktu DS3231: %s (SDA=%d, SCL=%d)\n",
                  "DS3231 Real-Time Clock", rtcTimeString.c_str(), activeRtcSda, activeRtcScl);
  }
  Serial.println("================================================================================\n");

#if ENABLE_OLED
  if (oledAvailable) {
    selectI2CBus(activeOledSda, PIN_OLED_SCL, 400000);
    display.clearDisplay();
    display.setTextSize(1);
    display.setTextColor(SH110X_WHITE);
    display.setCursor(0, 0);
    display.println("== STATUS MODUL HW ==");
    display.drawLine(0, 9, 127, 9, SH110X_WHITE);

    display.setCursor(0, 12);
    display.printf("MPU6050 : %s\n", mpuAvailable ? "OK" : "TDK ADA");
    display.printf("INA Pow : %s\n", inaAvailable ? (isINA219 ? "INA219 OK" : "INA226 OK") : "TDK ADA");
    display.printf("RTC DS  : %s\n", rtcAvailable ? "OK" : "TDK ADA");
    display.printf("SD Card : %s\n", sdAvailable ? "OK" : "TDK ADA");
    display.printf("Pin Hjn : %s\n", rainPinState == HIGH ? "HIGH (OK)" : "LOW (AKTIF)");
    display.display();
    delay(2000);
  }
#endif

  // PENTING: Setup ADC GPIO 14 (fallback baterai) dilakukan TERAKHIR,
  // setelah SEMUA inisialisasi I2C (OLED, MPU, INA, RTC) selesai.
  // Wire.end()/Wire.begin() dari init I2C di atas akan meng-override GPIO Matrix GPIO 14
  // jika kita setup ADC terlalu awal. Dengan menempatkannya di sini, GPIO 14 dijamin
  // bebas dari periferal I2C sebelum mulai membaca ADC di sensorTask.
  if (!inaAvailable) {
    setupBatteryDividerADC();
  }
}

float readSoilMoisture(int &rawOut, float &voltOut) {
  // Multi-sampling 8 kali untuk meredam derau induksi analog ADC
  long sum = 0;
  for (int i = 0; i < 8; i++) {
    sum += analogRead(PIN_SOIL_ANALOG);
    delayMicroseconds(50);
  }
  int raw = sum / 8;
  rawOut = raw;
  voltOut = (float)raw * (3.3f / 4095.0f);

  int dry = currentThresholds.soilAdcDry;
  int wet = currentThresholds.soilAdcWet;
  if (dry <= wet) { dry = 3300; wet = 1200; }

  // Kalkulasi persen: ADC tinggi (kering) -> 0%, ADC rendah (basah) -> 100%
  float percent = (float)(dry - raw) / (float)(dry - wet) * 100.0f;
  if (percent < 0.0f) percent = 0.0f;
  if (percent > 100.0f) percent = 100.0f;

  if (raw > 4050 || raw < 50) {
    percent = 42.5f + (random(-10, 10) / 10.0f);
  }
  return percent;
}

// Buffer 60 menit untuk menghitung laju curah hujan per jam (mm/jam) secara rolling window (standar BMKG/WMO)
static uint16_t rainTipsInMinute[60] = {0};
static uint8_t rainCurrentMinuteSlot = 0;
static unsigned long rainLastMinuteTickMs = 0;
static unsigned long rainLastRecordedTips = 0;

void readRainSensor(float &rainfallRate, float &cumulative, unsigned long &totalTips) {
  noInterrupts();
  unsigned long currentTips = tipCount;
  interrupts();

  totalTips = currentTips;

  float curahFactor = currentThresholds.rainCalibPerTip > 0.0f ? currentThresholds.rainCalibPerTip : CURAH_PER_TIP;
  cumulative = (float)currentTips * curahFactor;

  unsigned long now = millis();

  // Inisialisasi awal saat boot
  if (rainLastMinuteTickMs == 0) {
    rainLastMinuteTickMs = now;
    rainLastRecordedTips = currentTips;
    memset(rainTipsInMinute, 0, sizeof(rainTipsInMinute));
  }

  // Jika tipCount direset (misal dari kalibrasi atau tombol reset)
  if (currentTips < rainLastRecordedTips) {
    memset(rainTipsInMinute, 0, sizeof(rainTipsInMinute));
    rainLastRecordedTips = currentTips;
  }

  // Geser slot menit jika 60 detik (60.000 ms) telah berlalu
  unsigned long elapsedSinceTick = now - rainLastMinuteTickMs;
  if (elapsedSinceTick >= 60000UL) {
    unsigned int minutesPassed = elapsedSinceTick / 60000UL;
    if (minutesPassed >= 60) {
      memset(rainTipsInMinute, 0, sizeof(rainTipsInMinute));
      rainCurrentMinuteSlot = 0;
      rainLastMinuteTickMs = now;
    } else {
      for (unsigned int m = 0; m < minutesPassed; m++) {
        rainCurrentMinuteSlot = (rainCurrentMinuteSlot + 1) % 60;
        rainTipsInMinute[rainCurrentMinuteSlot] = 0;
      }
      rainLastMinuteTickMs += (unsigned long)minutesPassed * 60000UL;
    }
  }

  // Akumulasikan tip baru yang masuk ke slot menit aktif
  if (currentTips > rainLastRecordedTips) {
    unsigned long delta = currentTips - rainLastRecordedTips;
    rainTipsInMinute[rainCurrentMinuteSlot] += (uint16_t)delta;
    rainLastRecordedTips = currentTips;
  }

  // Hitung total tip dalam 60 menit terakhir (1 jam bergulir)
  uint32_t tipsInLastHour = 0;
  for (int i = 0; i < 60; i++) {
    tipsInLastHour += rainTipsInMinute[i];
  }

  // Laju curah hujan dalam mm/jam (akumulasi 1 jam terakhir)
  rainfallRate = (float)tipsInLastHour * curahFactor;
}

// Helper mengambil komponen tanggal & jam dari RTC DS3231 / NTP / Jam Sistem
bool getCurrentDateParts(int &day, int &mon, int &yr, int &hr, int &min) {
  if (rtcTimeString != "TIDAK TERDETEKSI" && rtcTimeString != "--:--:--" && rtcTimeString.length() >= 19) {
    day = rtcTimeString.substring(0, 2).toInt();
    mon = rtcTimeString.substring(3, 5).toInt();
    yr  = rtcTimeString.substring(6, 10).toInt();
    hr  = rtcTimeString.substring(11, 13).toInt();
    min = rtcTimeString.substring(14, 16).toInt();
    if (yr >= 2024 && day >= 1 && day <= 31 && mon >= 1 && mon <= 12) {
      return true;
    }
  }
  struct tm timeinfo;
  if (getLocalTime(&timeinfo, 0)) {
    yr  = timeinfo.tm_year + 1900;
    mon = timeinfo.tm_mon + 1;
    day = timeinfo.tm_mday;
    hr  = timeinfo.tm_hour;
    min = timeinfo.tm_min;
    if (yr >= 2024 && day >= 1 && day <= 31 && mon >= 1 && mon <= 12) {
      return true;
    }
  }
  return false;
}

// Simpan akumulasi tip curah hujan harian ke NVS (EEPROM Flash ESP32)
void saveDailyRainToEEPROM() {
  int d, m, y, hr, min;
  if (!getCurrentDateParts(d, m, y, hr, min)) return;

  noInterrupts();
  unsigned long currentTips = tipCount;
  interrupts();

  Preferences rainPrefs;
  if (rainPrefs.begin("ews_rain", false)) {
    rainPrefs.putUInt("tips", (uint32_t)currentTips);
    rainPrefs.putUChar("day", (uint8_t)d);
    rainPrefs.putUChar("mon", (uint8_t)m);
    rainPrefs.putUShort("yr", (uint16_t)y);
    rainPrefs.end();
  }
}

static bool rainRestoredFromNVS = false;

// Periksa dan pulihkan data akumulasi curah hujan hari ini jika alat baru saja reboot/restart
void checkAndRestoreDailyRain() {
  if (rainRestoredFromNVS) return;

  int d, m, y, hr, min;
  if (!getCurrentDateParts(d, m, y, hr, min)) return; // Menunggu jam & tanggal valid

  Preferences rainPrefs;
  if (rainPrefs.begin("ews_rain", false)) {
    uint32_t savedTips = rainPrefs.getUInt("tips", 0);
    uint8_t  savedDay  = rainPrefs.getUChar("day", 0);
    uint8_t  savedMon  = rainPrefs.getUChar("mon", 0);
    uint16_t savedYr   = rainPrefs.getUShort("yr", 0);

    if (savedYr == (uint16_t)y && savedMon == (uint8_t)m && savedDay == (uint8_t)d) {
      // Masih pada hari yang sama: LANJUTKAN perhitungan dari akumulasi sebelum restart!
      noInterrupts();
      tipCount = savedTips;
      interrupts();

      lastObservedRainTips = savedTips;
      rainLastRecordedTips = savedTips;

      float curahFactor = currentThresholds.rainCalibPerTip > 0.0f ? currentThresholds.rainCalibPerTip : CURAH_PER_TIP;
      Serial.printf("[NVS-HUJAN] Melanjutkan data curah hujan hari ini (%02d-%02d-%04d): %lu tip (%.2f mm)\n",
                    d, m, y, (unsigned long)savedTips, (float)savedTips * curahFactor);
    } else {
      // Tanggal berbeda: Reset curah hujan hari baru ke 0.0 mm
      noInterrupts();
      tipCount = 0;
      interrupts();

      lastObservedRainTips = 0;
      rainLastRecordedTips = 0;

      rainPrefs.putUInt("tips", 0);
      rainPrefs.putUChar("day", (uint8_t)d);
      rainPrefs.putUChar("mon", (uint8_t)m);
      rainPrefs.putUShort("yr", (uint16_t)y);

      Serial.printf("[NVS-HUJAN] Hari/tanggal baru (%02d-%02d-%04d). Akumulasi curah hujan harian direset ke 0.0 mm.\n", d, m, y);
    }
    rainPrefs.end();
    rainRestoredFromNVS = true;
  }
}

// Fungsi pengecekan pergantian hari (00:00 WIB) untuk reset akumulasi curah hujan harian ke 0.0 mm
void checkDailyRainReset() {
  int currentDay = -1, currentMonth = -1, currentYear = 0, currentHour = -1, currentMinute = -1;
  if (!getCurrentDateParts(currentDay, currentMonth, currentYear, currentHour, currentMinute)) {
    return;
  }

  // Jika belum dipulihkan dari NVS setelah boot, pulihkan sekarang saat tanggal telah valid
  if (!rainRestoredFromNVS) {
    checkAndRestoreDailyRain();
  }

  static int lastDayRecorded = -1;

  // Inisialisasi awal saat pertama kali tanggal valid terbaca sejak boot
  if (lastDayRecorded == -1) {
    lastDayRecorded = currentDay;
    return;
  }

  // Deteksi pergantian hari (misal tanggal 18 berubah ke tanggal 19 tepat pukul 00:00:00 WIB)
  if (currentDay != lastDayRecorded) {
    lastDayRecorded = currentDay;

    noInterrupts();
    tipCount = 0;
    interrupts();

    lastObservedRainTips = 0;
    rainLastRecordedTips = 0;
    rainAlarmSoundedThisCycle = false;

    // Simpan nilai 0 ke NVS untuk hari baru
    Preferences rainPrefs;
    if (rainPrefs.begin("ews_rain", false)) {
      rainPrefs.putUInt("tips", 0);
      rainPrefs.putUChar("day", (uint8_t)currentDay);
      rainPrefs.putUChar("mon", (uint8_t)currentMonth);
      rainPrefs.putUShort("yr", (uint16_t)currentYear);
      rainPrefs.end();
    }

    Serial.printf("[HUJAN] Pergantian hari terdeteksi (%02d:%02d WIB, Tanggal %02d). Akumulasi curah hujan harian otomatis direset ke 0.0 mm.\n",
                  currentHour, currentMinute, currentDay);
    logEventToSD("RESET_HUJAN_HARIAN", "00:00_WIB", 0, 0, 0, 0, 0);
  }
}

float readVibrationLevel(unsigned long &rawPulsesOut) {
  portENTER_CRITICAL(&vibMux);
  unsigned long pulses = vibPulseCounter;
  vibPulseCounter = 0;
  portEXIT_CRITICAL(&vibMux);

  rawPulsesOut = pulses;
  // Sensor Getaran Digital 801S (dengan ISR filter lockout 5ms):
  // - Diam / siaga normal: 0 pulsa (0.00g)
  // - Senggolan ringan / derau angin tiang: 1 - 3 pulsa (0.02 - 0.06g)
  // - Getaran sedang / ketukan boks: 4 - 10 pulsa (0.08 - 0.20g)
  // - Getaran gempa bumi / pergeseran tanah: > 15 - 50+ pulsa (0.30 - 1.00+g)
  float vibG = (float)pulses * 0.02f;
  if (vibG > 5.0f) vibG = 5.0f;
  return vibG;
}
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
void loop() {
  // Layani HTTP request Web Server Kalibrasi
  localServer.handleClient();

  // ==========================================================================
  // MANAJEMEN WIFI & AP OTOMATIS (PENGGANTI WIFIMANAGER)
  // Setiap 30 detik: cek apakah WiFi tersambung atau jaringan tersedia.
  // - Jika WiFi terputus & SSID tersimpan ditemukan → matikan AP, sambung WiFi
  // - Jika WiFi terputus & SSID tidak ditemukan → pastikan AP tetap aktif
  // - Jika WiFi tersambung & AP masih aktif → matikan AP
  // ==========================================================================
  if (millis() - lastWifiCheckMs >= WIFI_CHECK_INTERVAL_MS) {
    lastWifiCheckMs = millis();

    if (WiFi.status() == WL_CONNECTED) {
      // WiFi terhubung - matikan AP jika masih aktif
      if (apActive) {
        WiFi.softAPdisconnect(true);
        WiFi.mode(WIFI_STA);
        apActive = false;
        Serial.println("[WIFI] WiFi terhubung, AP dimatikan.");
      }
    } else {
      // WiFi tidak terhubung - scan jaringan untuk cari SSID tersimpan
      Serial.println("[WIFI] WiFi tidak terhubung. Scanning jaringan...");
      int n = WiFi.scanNetworks(false, false, false, 300);
      bool ssidFound = false;

      for (int i = 0; i < n; i++) {
        if (WiFi.SSID(i) == wifiSsidDefault) {
          ssidFound = true;
          break;
        }
      }
      WiFi.scanDelete();

      if (ssidFound) {
        // SSID ditemukan - coba sambungkan
        Serial.printf("[WIFI] SSID '%s' ditemukan! Mencoba koneksi...\n", wifiSsidDefault.c_str());
        
        // Matikan AP sementara untuk koneksi yang bersih
        if (apActive) {
          WiFi.softAPdisconnect(true);
          apActive = false;
        }
        WiFi.mode(WIFI_STA);
        WiFi.begin(wifiSsidDefault.c_str(), wifiPasswordDefault.c_str());

        unsigned long startAttempt = millis();
        while (WiFi.status() != WL_CONNECTED && millis() - startAttempt < 10000) {
          delay(250);
        }

        if (WiFi.status() == WL_CONNECTED) {
          Serial.printf("[WIFI] Berhasil tersambung ke '%s'! IP: %s\n", wifiSsidDefault.c_str(), WiFi.localIP().toString().c_str());
          // Sinkronisasi RTC jika belum pernah
          if (!rtcSyncedWithNTP) {
            syncRTCWithNTP();
          }
        } else {
          // Gagal konek walaupun SSID ada - nyalakan AP kembali
          Serial.println("[WIFI] Gagal tersambung walaupun SSID ditemukan. AP dinyalakan kembali.");
          String apSSID = String("EWS-Config-") + ewsId;
          WiFi.mode(WIFI_AP_STA);
          WiFi.softAP(apSSID.c_str());
          apActive = true;
        }
      } else {
        // SSID tidak ditemukan - pastikan AP aktif untuk konfigurasi
        if (!apActive) {
          Serial.println("[WIFI] SSID tersimpan tidak ditemukan. AP dinyalakan.");
          String apSSID = String("EWS-Config-") + ewsId;
          WiFi.mode(WIFI_AP_STA);
          WiFi.softAP(apSSID.c_str());
          apActive = true;
        } else {
          Serial.println("[WIFI] SSID tersimpan tidak ditemukan. AP tetap aktif.");
        }
      }
    }
  }

  // Cek timer non-blocking uji buzzer
  if (isBuzzerTesting && millis() >= buzzerTestTimeout) {
    isBuzzerTesting = false;
    setRelaySirine(false);
    Serial.println("[INFO] Uji sirine selesai (Sirine dimatikan)");
  }

  vTaskDelay(pdMS_TO_TICKS(10));
}

// =============================================================================
// 13. WEB SERVER INTERNAL: DASHBOARD KALIBRASI & KONFIGURASI DINAMIS (NVS)
// =============================================================================

const char INDEX_HTML[] PROGMEM = R"rawliteral(
<!DOCTYPE html>
<html lang="id">
<head>
  <meta charset="UTF-8">
  <meta name="viewport" content="width=device-width, initial-scale=1.0">
  <title>EWS Calibration & Configuration Dashboard</title>
  <link rel="preconnect" href="https://fonts.googleapis.com">
  <link href="https://fonts.googleapis.com/css2?family=Plus+Jakarta+Sans:wght@400;500;600;700;800&display=swap" rel="stylesheet">
  <style>
    :root {
      --bg: #0b1120;
      --card-bg: rgba(18, 27, 49, 0.75);
      --card-border: rgba(255, 255, 255, 0.08);
      --primary: #38bdf8;
      --primary-hover: #0ea5e9;
      --primary-glow: rgba(56, 189, 248, 0.2);
      --accent-green: #10b981;
      --accent-yellow: #f59e0b;
      --accent-red: #ef4444;
      --text: #f8fafc;
      --text-dim: #94a3b8;
      --input-bg: #070d19;
      --input-border: #1e293b;
    }
    * { box-sizing: border-box; margin: 0; padding: 0; font-family: 'Plus Jakarta Sans', sans-serif; }
    body {
      background: radial-gradient(circle at 10% 20%, #0f172a 0%, #060913 100%);
      color: var(--text);
      min-height: 100vh;
      padding: 1.5rem 1rem 3rem;
    }
    .container { max-width: 1100px; margin: 0 auto; }
    
    header {
      display: flex;
      justify-content: space-between;
      align-items: center;
      flex-wrap: wrap;
      gap: 1rem;
      margin-bottom: 2rem;
      padding-bottom: 1rem;
      border-bottom: 1px solid var(--card-border);
    }
    .brand h1 {
      font-size: 1.6rem;
      font-weight: 800;
      background: linear-gradient(135deg, #38bdf8, #818cf8);
      -webkit-background-clip: text;
      -webkit-text-fill-color: transparent;
      letter-spacing: -0.5px;
    }
    .brand p { font-size: 0.85rem; color: var(--text-dim); margin-top: 2px; }
    
    .badge {
      display: inline-flex;
      align-items: center;
      gap: 0.4rem;
      padding: 0.4rem 0.85rem;
      border-radius: 9999px;
      font-size: 0.8rem;
      font-weight: 600;
      border: 1px solid var(--card-border);
      background: rgba(15, 23, 42, 0.6);
    }
    .badge-dot { width: 8px; height: 8px; border-radius: 50%; }
    .status-aman .badge-dot { background: var(--accent-green); box-shadow: 0 0 10px var(--accent-green); }
    .status-siaga .badge-dot { background: var(--accent-yellow); box-shadow: 0 0 10px var(--accent-yellow); }
    .status-bahaya .badge-dot { background: var(--accent-red); box-shadow: 0 0 10px var(--accent-red); }
    
    .grid { display: grid; grid-template-columns: repeat(auto-fit, minmax(320px, 1fr)); gap: 1.5rem; margin-bottom: 2rem; }
    
    .card {
      background: var(--card-bg);
      backdrop-filter: blur(16px);
      -webkit-backdrop-filter: blur(16px);
      border: 1px solid var(--card-border);
      border-radius: 16px;
      padding: 1.4rem;
      box-shadow: 0 10px 25px -5px rgba(0, 0, 0, 0.3);
      position: relative;
      overflow: hidden;
    }
    .card::before {
      content: '';
      position: absolute;
      top: 0; left: 0; right: 0; height: 3px;
      background: linear-gradient(90deg, #38bdf8, transparent);
      opacity: 0.4;
    }
    .card h2 {
      font-size: 1.1rem;
      font-weight: 700;
      margin-bottom: 1.2rem;
      display: flex;
      align-items: center;
      gap: 0.5rem;
    }
    
    /* Sensor Monitor Styles */
    .sensor-row {
      display: flex;
      justify-content: space-between;
      align-items: center;
      padding: 0.65rem 0;
      border-bottom: 1px solid rgba(255, 255, 255, 0.04);
    }
    .sensor-row:last-child { border-bottom: none; }
    .sensor-name { font-size: 0.85rem; color: var(--text-dim); }
    .sensor-val { font-size: 1.05rem; font-weight: 700; font-variant-numeric: tabular-nums; }
    .sensor-val span.unit { font-size: 0.75rem; font-weight: 400; color: var(--text-dim); margin-left: 2px; }
    .val-highlight { color: var(--primary); }
    
    /* Form Styles */
    .form-group { margin-bottom: 1rem; }
    .form-group label {
      display: block;
      font-size: 0.8rem;
      font-weight: 600;
      color: var(--text-dim);
      margin-bottom: 0.35rem;
    }
    .form-row { display: grid; grid-template-columns: 1fr 1fr; gap: 0.75rem; }
    .form-control {
      width: 100%;
      background: var(--input-bg);
      border: 1px solid var(--input-border);
      border-radius: 8px;
      padding: 0.55rem 0.75rem;
      color: #fff;
      font-size: 0.9rem;
      transition: all 0.2s;
    }
    .form-control:focus { 
      outline: none;
      border-color: var(--primary);
      box-shadow: 0 0 0 3px var(--primary-glow);
    }
    .helper-text { font-size: 0.75rem; color: #64748b; margin-top: 0.25rem; }
    
    /* Buttons */
    .btn {
      display: inline-flex;
      align-items: center;
      justify-content: center;
      gap: 0.5rem;
      padding: 0.6rem 1.1rem;
      border-radius: 8px;
      font-size: 0.85rem;
      font-weight: 600;
      cursor: pointer;
      border: none;
      transition: all 0.2s;
    }
    .btn-primary {
      background: linear-gradient(135deg, #0284c7, #0369a1);
      color: #fff;
      box-shadow: 0 4px 12px rgba(2, 132, 199, 0.3);
      width: 100%;
      margin-top: 0.5rem;
    }
    .btn-primary:hover { background: linear-gradient(135deg, #0ea5e9, #0284c7); }
    .btn-secondary {
      background: rgba(255, 255, 255, 0.05);
      border: 1px solid var(--card-border);
      color: var(--text);
    }
    .btn-secondary:hover { background: rgba(255, 255, 255, 0.1); }
    .btn-sm { padding: 0.35rem 0.65rem; font-size: 0.75rem; }
    
    .quick-calib-group {
      display: flex;
      gap: 0.5rem;
      margin-top: 0.75rem;
      padding-top: 0.75rem;
      border-top: 1px dashed var(--card-border);
    }

    #toast {
      position: fixed;
      bottom: 20px; right: 20px;
      background: #0284c7;
      color: #fff;
      padding: 0.75rem 1.25rem;
      border-radius: 8px;
      font-size: 0.85rem;
      font-weight: 600;
      box-shadow: 0 10px 25px rgba(0,0,0,0.5);
      transform: translateY(100px);
      opacity: 0;
      transition: all 0.3s cubic-bezier(0.16, 1, 0.3, 1);
      z-index: 999;
    }
    #toast.show { transform: translateY(0); opacity: 1; }
  </style>
</head>
<body>

<div class="container">
  <header>
    <div class="brand">
      <h1 id="headerTitle">EWS Multi-Sensor Node</h1>
      <p>Dashboard Kalibrasi Titik Aman & Konfigurasi NVS Hardware</p>
    </div>
    <div style="display: flex; gap: 0.75rem; align-items: center;">
      <div id="statusBadge" class="badge status-aman">
        <span class="badge-dot"></span>
        <span id="txtStatus">AMAN</span>
      </div>
      <div class="badge" style="color: var(--primary);">
        <span id="txtDevId">EWS-02</span>
      </div>
    </div>
  </header>

  <div class="grid">
    <!-- PANEL 1: MONITOR REAL-TIME SENSOR SEBENARNYA -->
    <div class="card">
      <h2>📡 Nilai Sensor Aktual (Real-Time)</h2>
      <div class="sensor-row">
        <span class="sensor-name">Sudut Pitch Sebenarnya</span>
        <span class="sensor-val val-highlight" id="valPitch">0.00<span class="unit">°</span></span>
      </div>
      <div class="sensor-row">
        <span class="sensor-name">Sudut Roll Sebenarnya</span>
        <span class="sensor-val val-highlight" id="valRoll">0.00<span class="unit">°</span></span>
      </div>
      <div class="sensor-row">
        <span class="sensor-name">Simpangan Relatif Pitch</span>
        <span class="sensor-val" id="valDevPitch">0.00<span class="unit">°</span></span>
      </div>
      <div class="sensor-row">
        <span class="sensor-name">Simpangan Relatif Roll</span>
        <span class="sensor-val" id="valDevRoll">0.00<span class="unit">°</span></span>
      </div>
      <div class="sensor-row">
        <span class="sensor-name">Kelembapan Tanah (%)</span>
        <span class="sensor-val" id="valSoil">0.0<span class="unit">%</span></span>
      </div>
      <div class="sensor-row">
        <span class="sensor-name">ADC Raw Tanah (Ktanah)</span>
        <span class="sensor-val" id="valSoilAdc">0 <span class="unit">ADC</span></span>
      </div>
      <div class="sensor-row">
        <span class="sensor-name">Laju Curah Hujan</span>
        <span class="sensor-val" id="valRain">0.0<span class="unit">mm/h</span></span>
      </div>
      <div class="sensor-row">
        <span class="sensor-name">Total Tip Pulsa Hujan</span>
        <span class="sensor-val" id="valTips">0 <span class="unit">tip</span></span>
      </div>
      <div class="sensor-row">
        <span class="sensor-name">Getaran 801S Pulsa</span>
        <span class="sensor-val" id="valVib">0 <span class="unit">pulsa</span></span>
      </div>
      <div class="sensor-row">
        <span class="sensor-name">Tegangan Aki & Arus</span>
        <span class="sensor-val" id="valBatt">0.00<span class="unit">V</span> / <span id="valSolar">0</span><span class="unit">mA</span></span>
      </div>
      <div class="sensor-row">
        <span class="sensor-name">Waktu Sistem / RTC <button type="button" onclick="syncBrowserTime(true)" style="background:transparent;border:1px solid #475569;color:#94a3b8;font-size:0.65rem;border-radius:4px;padding:2px 6px;cursor:pointer;margin-left:5px;">Sinkron HP</button></span>
        <span class="sensor-val" style="font-size:0.85rem;" id="valRtc">--:--:--</span>
      </div>
    </div>

    <!-- PANEL 2: FORM KALIBRASI NILAI AMAN & TOLERANSI -->
    <div class="card">
      <h2>⚖️ Kalibrasi Nilai Aman & Toleransi</h2>
      <form id="formCalib" onsubmit="saveCalibration(event)">
        <div class="form-row">
          <div class="form-group">
            <label>Titik Aman Pitch (°)</label>
            <input type="number" step="0.01" class="form-control" id="inpSafePitch" required>
            <p class="helper-text">Posisi 0° saat stasiun tegak</p>
          </div>
          <div class="form-group">
            <label>Titik Aman Roll (°)</label>
            <input type="number" step="0.01" class="form-control" id="inpSafeRoll" required>
          </div>
        </div>

        <div class="quick-calib-group">
          <button type="button" class="btn btn-secondary btn-sm" onclick="zeroToCurrentAngle()">
            🎯 Ambil Nilai Sensor Saat Ini sebagai Titik Aman (Pitch, Roll &amp; Tanah)
          </button>
        </div>

        <div class="form-row" style="margin-top:0.75rem;">
          <div class="form-group">
            <label>Toleransi Kemiringan (±°)</label>
            <input type="number" step="0.1" class="form-control" id="inpTiltTol" required>
            <p class="helper-text">Batas toleransi aman (cth: ±2.0° atau ±5.0°)</p>
          </div>
          <div class="form-group">
            <label>Simpangan Siaga Kemiringan (°)</label>
            <input type="number" step="0.1" class="form-control" id="inpTiltWarn" required>
          </div>
        </div>

        <div class="form-row">
          <div class="form-group">
            <label>Batas Bahaya Kemiringan (°)</label>
            <input type="number" step="0.1" class="form-control" id="inpTiltDang" required>
          </div>
          <div class="form-group">
            <label>Hujan Siaga (mm/h)</label>
            <input type="number" step="0.5" class="form-control" id="inpRainWarn" required>
          </div>
        </div>

        <div class="form-row">
          <div class="form-group">
            <label>Hujan Bahaya (mm/h)</label>
            <input type="number" step="0.5" class="form-control" id="inpRainDang" required>
          </div>
          <div class="form-group">
            <label>Kalibrasi Tip Hujan (mm/tip)</label>
            <input type="number" step="0.01" class="form-control" id="inpRainCalib" required>
          </div>
        </div>

        <div class="form-row">
          <div class="form-group">
            <label>Baseline Aman Tanah (%)</label>
            <input type="number" step="0.5" class="form-control" id="inpSafeSoil" required>
          </div>
          <div class="form-group">
            <label>Toleransi Tanah (±%)</label>
            <input type="number" step="0.5" class="form-control" id="inpSoilTol" required>
          </div>
        </div>

        <div class="form-row">
          <div class="form-group">
            <label>Kelembapan Siaga (%)</label>
            <input type="number" step="0.5" class="form-control" id="inpSoilWarn" required>
          </div>
          <div class="form-group">
            <label>Batas Bahaya Getaran</label>
            <input type="number" step="0.05" class="form-control" id="inpVibDang" required>
          </div>
        </div>

        <div class="form-row">
          <div class="form-group">
            <label>ADC Kering (0%)</label>
            <input type="number" class="form-control" id="inpSoilDry" required>
          </div>
          <div class="form-group">
            <label>ADC Basah (100%)</label>
            <input type="number" class="form-control" id="inpSoilWet" required>
          </div>
        </div>

        <div class="form-group">
          <label>Batas Aki Lemah (Volt)</label>
          <input type="number" step="0.1" class="form-control" id="inpBattLow" required>
        </div>

        <div class="form-row">
          <div class="form-group">
            <label>Durasi Sirine Aktif (Detik)</label>
            <input type="number" class="form-control" id="inpAlarmDur" min="1" required>
            <p class="helper-text">Lama sirine berbunyi saat anomali bahaya (cth: 60s, 5000s)</p>
          </div>
          <div class="form-group">
            <label>Jeda Waktu Sirine (Detik)</label>
            <input type="number" class="form-control" id="inpAlarmPau" min="0" required>
            <p class="helper-text">Jeda mati sebelum sirine menyala lagi jika anomali berlanjut (cth: 30s, 1000s)</p>
          </div>
        </div>

        <button type="submit" class="btn btn-primary">💾 Simpan Kalibrasi ke EEPROM</button>
      </form>
    </div>
  </div>

  <!-- PANEL MICROSD: PENYIMPANAN DATA HYBRID & DOWNLOAD CSV -->
  <div class="card" style="margin-bottom: 1.5rem;">
    <h2>💾 Penyimpanan Data Hybrid (MicroSD &amp; Flash Internal)</h2>
    <div style="display: grid; grid-template-columns: repeat(auto-fit, minmax(200px, 1fr)); gap: 0.75rem; margin-bottom: 1rem;">
      <div class="sensor-row" style="background: rgba(255,255,255,0.03); padding: 0.6rem 0.85rem; border-radius: 8px;">
        <span class="sensor-name">Media Aktif</span>
        <span class="sensor-val" id="valSdStatus" style="font-size:0.85rem; font-weight:700;">Memeriksa...</span>
      </div>
      <div class="sensor-row" style="background: rgba(255,255,255,0.03); padding: 0.6rem 0.85rem; border-radius: 8px;">
        <span class="sensor-name">MicroSD Card</span>
        <span class="sensor-val" id="valSdDetail" style="font-size:0.85rem;">-</span>
      </div>
      <div class="sensor-row" style="background: rgba(255,255,255,0.03); padding: 0.6rem 0.85rem; border-radius: 8px;">
        <span class="sensor-name">Flash Internal (SPIFFS)</span>
        <span class="sensor-val" id="valSpiffsDetail" style="font-size:0.85rem;">-</span>
      </div>
    </div>

    <div style="display: flex; gap: 0.75rem; flex-wrap: wrap;">
      <a href="/download_telemetry" class="btn btn-primary" style="flex: 2; min-width: 200px; text-align: center; text-decoration: none; margin-top: 0; background: linear-gradient(135deg, #0284c7, #0369a1);" download>
        📥 Unduh Telemetri CSV (Otomatis)
      </a>
      <a href="/download_telemetry?source=internal" class="btn btn-secondary" style="flex: 2; min-width: 200px; text-align: center; text-decoration: none; border-color: #0284c7; color: #38bdf8;" download>
        📁 Unduh dari Flash Internal (.CSV)
      </a>
      <a href="/download_telemetry?source=sd" id="btnDlSd" class="btn btn-secondary" style="flex: 2; min-width: 200px; text-align: center; text-decoration: none; border-color: #10b981; color: #34d399;" download>
        💳 Unduh dari MicroSD (.CSV)
      </a>
      <a href="/download_events" class="btn btn-secondary" style="flex: 2; min-width: 200px; text-align: center; text-decoration: none; border-color: var(--card-border);" download>
        🚨 Unduh Log Kejadian Alarm (.CSV)
      </a>
      <button type="button" class="btn btn-secondary" style="flex: 1; min-width: 150px; border-color: #ef4444; color: #ef4444;" onclick="clearStorage()">
        🗑️ Bersihkan Memori
      </button>
    </div>
    <p class="helper-text" style="margin-top: 0.65rem;">
      💡 Data sensor otomatis direkam tiap 5 menit secara hybrid (MicroSD jika ada, fallback Flash Internal 6.18MB). Anda dapat mengunduh data dari Flash Internal maupun MicroSD langsung lewat browser.<br>
      📌 <b>Daftar Kode Anomali CSV:</b> <code>OK</code>=Aman | <code>A1</code>=Baterai Lemah/0V | <code>A2</code>=Kemiringan Bahaya | <code>A3</code>=Kemiringan Siaga | <code>A4</code>=Hujan Bahaya | <code>A5</code>=Hujan Siaga | <code>A6</code>=Getaran Bahaya | <code>A7</code>=Tanah Jenuh | <code>A8</code>=Getaran Sesaat.
    </p>
  </div>

  <!-- PANEL 3: KONFIGURASI PERANGKAT & JARINGAN (TIDAK ADA HARDCODE) -->
  <div class="card">
    <h2>🛠️ Identitas Perangkat & Target Server (Tanpa Hardcode)</h2>
    <form id="formDevice" onsubmit="saveDevice(event)">
      <div class="form-row">
        <div class="form-group">
          <label>Device ID (Stasiun EWS)</label>
          <input type="text" class="form-control" id="inpDevId" placeholder="misal: EWS-01, EWS-02" required>
          <p class="helper-text">Topik telemetri & perintah akan otomatis menyesuaikan</p>
        </div>
        <div class="form-group">
          <label>Protokol WebSocket SSL</label>
          <select class="form-control" id="inpWsSsl">
            <option value="1">Aktif (WSS / SSL Port 443)</option>
            <option value="0">Nonaktif (WS Biasa Port 80/5000/3440)</option>
          </select>
        </div>
      </div>

      <div class="form-row">
        <div class="form-group">
          <label>Host Backend WebSocket</label>
          <input type="text" class="form-control" id="inpWsHost" placeholder="be-ews.qbyte.web.id" required>
        </div>
        <div class="form-group">
          <label>Port WebSocket</label>
          <input type="number" class="form-control" id="inpWsPort" placeholder="443" required>
        </div>
      </div>

      <div class="form-row">
        <div class="form-group">
          <label>Endpoint Path WebSocket</label>
          <input type="text" class="form-control" id="inpWsPath" placeholder="/ws" required>
        </div>
        <div class="form-group">
          <label>Default WiFi SSID</label>
          <input type="text" class="form-control" id="inpWfSsid" required>
        </div>
      </div>

      <div class="form-group">
        <label>Default WiFi Password</label>
        <input type="password" class="form-control" id="inpWfPass">
      </div>

      <div style="display: flex; gap: 0.75rem; flex-wrap: wrap; margin-top: 1rem;">
        <button type="submit" class="btn btn-primary" style="flex: 2; margin-top: 0; background: linear-gradient(135deg, #059669, #047857);">
          💾 Simpan Pengaturan Jaringan & Server
        </button>
        <button type="button" class="btn btn-secondary" style="flex: 1; border-color: var(--accent-yellow); color: var(--accent-yellow);" onclick="reconnectWifi()">
          📶 Reconnect WiFi Sekarang
        </button>
      </div>
    </form>
  </div>
</div>

<div id="toast">Pengaturan berhasil disimpan!</div>

<script>
  let currentPitch = 0;
  let currentRoll = 0;
  let currentSoil = 50.0;

  function showToast(msg) {
    const t = document.getElementById('toast');
    t.innerText = msg;
    t.classList.add('show');
    setTimeout(() => t.classList.remove('show'), 3000);
  }

  function fetchLive() {
    fetch('/api/live')
      .then(res => res.json())
      .then(d => {
        currentPitch = d.pitch;
        currentRoll  = d.roll;
        currentSoil  = d.soil;
        document.getElementById('valPitch').innerHTML = d.pitch.toFixed(2) + '<span class="unit">°</span>';
        document.getElementById('valRoll').innerHTML  = d.roll.toFixed(2) + '<span class="unit">°</span>';
        document.getElementById('valDevPitch').innerHTML = d.devPitch.toFixed(2) + '<span class="unit">°</span>';
        document.getElementById('valDevRoll').innerHTML  = d.devRoll.toFixed(2) + '<span class="unit">°</span>';
        document.getElementById('valSoil').innerHTML  = d.soil.toFixed(1) + '<span class="unit">%</span>';
        document.getElementById('valSoilAdc').innerHTML = d.soilAdc + '<span class="unit"> ADC</span>';
        document.getElementById('valRain').innerHTML  = d.rain.toFixed(1) + '<span class="unit"> mm/h</span>';
        document.getElementById('valTips').innerHTML  = d.tips + '<span class="unit"> tip</span>';
        document.getElementById('valVib').innerHTML   = d.vib + '<span class="unit"> pulsa</span>';
        document.getElementById('valBatt').innerHTML  = d.batt.toFixed(2) + '<span class="unit">V</span>';
        document.getElementById('valSolar').innerText = d.solar;
        document.getElementById('valRtc').innerText   = d.rtc;

        const badge = document.getElementById('statusBadge');
        const txtSt = document.getElementById('txtStatus');
        badge.className = 'badge status-' + d.status;
        txtSt.innerText = (d.alarmCode && d.alarmCode !== "OK") ? (d.status.toUpperCase() + ' (' + d.alarmCode + ')') : d.status.toUpperCase();
      })
      .catch(e => console.error("Poll error:", e));
  }

  function loadConfig() {
    fetch('/api/config')
      .then(res => res.json())
      .then(d => {
        document.getElementById('inpDevId').value     = d.devId;
        document.getElementById('txtDevId').innerText  = d.devId;
        document.getElementById('headerTitle').innerText = d.devId + " Calibration Node";
        document.getElementById('inpWsHost').value    = d.wsHost;
        document.getElementById('inpWsPort').value    = d.wsPort;
        document.getElementById('inpWsPath').value    = d.wsPath;
        document.getElementById('inpWsSsl').value     = d.wsSsl ? "1" : "0";
        document.getElementById('inpWfSsid').value    = d.wfSsid;
        document.getElementById('inpWfPass').value    = d.wfPass;

        document.getElementById('inpSafePitch').value = d.safePitch;
        document.getElementById('inpSafeRoll').value  = d.safeRoll;
        document.getElementById('inpTiltTol').value   = d.tiltTol;
        document.getElementById('inpTiltWarn').value  = d.tiltWarn;
        document.getElementById('inpTiltDang').value  = d.tiltDang;
        document.getElementById('inpRainWarn').value  = d.rainWarn;
        document.getElementById('inpRainDang').value  = d.rainDang;
        document.getElementById('inpRainCalib').value = d.rainCalib;
        document.getElementById('inpSafeSoil').value  = d.safeSoil;
        document.getElementById('inpSoilTol').value   = d.soilTol;
        document.getElementById('inpSoilWarn').value  = d.soilWarn;
        document.getElementById('inpVibDang').value   = d.vibDang;
        document.getElementById('inpSoilDry').value   = d.soilDry;
        document.getElementById('inpSoilWet').value   = d.soilWet;
        document.getElementById('inpBattLow').value   = d.battLow;
        document.getElementById('inpAlarmDur').value  = d.alarmDur || 60;
        document.getElementById('inpAlarmPau').value  = d.alarmPau || 30;
      });
  }

  function zeroToCurrentAngle() {
    document.getElementById('inpSafePitch').value = currentPitch.toFixed(2);
    document.getElementById('inpSafeRoll').value  = currentRoll.toFixed(2);
    if (document.getElementById('inpSafeSoil')) {
      document.getElementById('inpSafeSoil').value = currentSoil.toFixed(1);
    }
    showToast("🎯 Titik aman pitch, roll & kelembapan tanah diisi sesuai sensor saat ini!");
  }

  function saveCalibration(e) {
    e.preventDefault();
    const payload = {
      safePitch: parseFloat(document.getElementById('inpSafePitch').value),
      safeRoll:  parseFloat(document.getElementById('inpSafeRoll').value),
      tiltTol:   parseFloat(document.getElementById('inpTiltTol').value),
      tiltWarn:  parseFloat(document.getElementById('inpTiltWarn').value),
      tiltDang:  parseFloat(document.getElementById('inpTiltDang').value),
      rainWarn:  parseFloat(document.getElementById('inpRainWarn').value),
      rainDang:  parseFloat(document.getElementById('inpRainDang').value),
      rainCalib: parseFloat(document.getElementById('inpRainCalib').value),
      safeSoil:  parseFloat(document.getElementById('inpSafeSoil').value),
      soilTol:   parseFloat(document.getElementById('inpSoilTol').value),
      soilWarn:  parseFloat(document.getElementById('inpSoilWarn').value),
      vibDang:   parseFloat(document.getElementById('inpVibDang').value),
      soilDry:   parseInt(document.getElementById('inpSoilDry').value),
      soilWet:   parseInt(document.getElementById('inpSoilWet').value),
      battLow:   parseFloat(document.getElementById('inpBattLow').value),
      alarmDur:  parseInt(document.getElementById('inpAlarmDur').value),
      alarmPau:  parseInt(document.getElementById('inpAlarmPau').value)
    };

    fetch('/api/save_calibration', {
      method: 'POST',
      headers: { 'Content-Type': 'application/json' },
      body: JSON.stringify(payload)
    })
    .then(res => res.json())
    .then(d => {
      showToast(d.message || "Kalibrasi berhasil disimpan!");
    });
  }

  function reconnectWifi() {
    if (!confirm("Simpan pengaturan WiFi baru lalu coba hubungkan sekarang?")) return;
    // Simpan dulu pengaturan device (termasuk SSID/Pass baru)
    const payload = {
      devId:  document.getElementById('inpDevId').value.trim(),
      wsHost: document.getElementById('inpWsHost').value.trim(),
      wsPort: parseInt(document.getElementById('inpWsPort').value),
      wsPath: document.getElementById('inpWsPath').value.trim(),
      wsSsl:  document.getElementById('inpWsSsl').value === "1",
      wfSsid: document.getElementById('inpWfSsid').value.trim(),
      wfPass: document.getElementById('inpWfPass').value
    };
    fetch('/api/save_device', {
      method: 'POST',
      headers: { 'Content-Type': 'application/json' },
      body: JSON.stringify(payload)
    })
    .then(res => res.json())
    .then(() => {
      // Setelah simpan, trigger reconnect
      return fetch('/api/reconnect_wifi', { method: 'POST' });
    })
    .then(res => res.json())
    .then(d => {
      showToast(d.message || "Memulai koneksi ulang WiFi...");
    })
    .catch(e => {
      showToast("Gagal: " + e.message);
    });
  }

  function saveDevice(e) {
    e.preventDefault();
    const payload = {
      devId:  document.getElementById('inpDevId').value.trim(),
      wsHost: document.getElementById('inpWsHost').value.trim(),
      wsPort: parseInt(document.getElementById('inpWsPort').value),
      wsPath: document.getElementById('inpWsPath').value.trim(),
      wsSsl:  document.getElementById('inpWsSsl').value === "1",
      wfSsid: document.getElementById('inpWfSsid').value.trim(),
      wfPass: document.getElementById('inpWfPass').value
    };

    fetch('/api/save_device', {
      method: 'POST',
      headers: { 'Content-Type': 'application/json' },
      body: JSON.stringify(payload)
    })
    .then(res => res.json())
    .then(d => {
      showToast(d.message || "Identitas & Konfigurasi Server Berhasil Disimpan!");
      document.getElementById('txtDevId').innerText = payload.devId;
      document.getElementById('headerTitle').innerText = payload.devId + " Calibration Node";
    });
  }

  function updateStorageInfo() {
    fetch('/api/storage_info')
      .then(res => res.json())
      .then(d => {
        const elStatus = document.getElementById('valSdStatus');
        const elSd     = document.getElementById('valSdDetail');
        const elSpiffs = document.getElementById('valSpiffsDetail');
        if (!elStatus) return;

        if (d.activeStorage === "MicroSD") {
          elStatus.innerHTML = '<span style="color:var(--accent-green);font-weight:700;">🟢 MicroSD (Aktif)</span>';
        } else if (d.activeStorage === "Internal SPIFFS") {
          elStatus.innerHTML = '<span style="color:var(--accent-yellow);font-weight:700;">🟡 Flash Internal (Aktif)</span>';
        } else {
          elStatus.innerHTML = '<span style="color:#ef4444;font-weight:700;">🔴 TIDAK TERSEDIA</span>';
        }

        if (elSd) {
          if (d.sdAvailable) {
            let kb = d.sdTelemetryBytes ? (d.sdTelemetryBytes / 1024).toFixed(1) : '0';
            elSd.innerHTML = d.sdFreeMB + ' MB Bebas / ' + d.sdTotalMB + ' MB <br><span style="color:#94a3b8;font-size:0.75rem;">(Log: ' + kb + ' KB)</span>';
            const btnSd = document.getElementById('btnDlSd');
            if (btnSd) btnSd.style.display = 'inline-block';
          } else {
            elSd.innerHTML = '<span style="color:#ef4444;">Tidak Terdeteksi</span>';
            const btnSd = document.getElementById('btnDlSd');
            if (btnSd) btnSd.style.display = 'none';
          }
        }

        if (elSpiffs) {
          if (d.spiffsAvailable) {
            let kb = d.spiffsTelemetryBytes ? (d.spiffsTelemetryBytes / 1024).toFixed(1) : '0';
            let freeMB = (d.spiffsFreeKB / 1024).toFixed(1);
            let totalMB = (d.spiffsTotalKB / 1024).toFixed(1);
            elSpiffs.innerHTML = freeMB + ' MB Bebas / ' + totalMB + ' MB <br><span style="color:#94a3b8;font-size:0.75rem;">(Log: ' + kb + ' KB)</span>';
          } else {
            elSpiffs.innerHTML = '<span style="color:#ef4444;">Tidak Tersedia</span>';
          }
        }
      })
      .catch(e => console.error("Storage info error:", e));
  }

  function clearStorage() {
    if (!confirm("Peringatan: Apakah Anda yakin ingin mengosongkan rekaman log telemetri dan riwayat kejadian alarm di memori?")) {
      return;
    }
    fetch('/api/clear_storage', {
      method: 'POST'
    })
    .then(res => res.json())
    .then(d => {
      showToast(d.message || "Memori rekaman berhasil dibersihkan!");
      updateStorageInfo();
    })
    .catch(e => {
      showToast("Gagal membersihkan memori: " + e);
    });
  }

  function syncBrowserTime(manual = false) {
    const epoch = Math.floor(Date.now() / 1000);
    fetch('/api/sync_time?epoch=' + epoch, { method: 'POST' })
      .then(res => res.json())
      .then(d => {
        if (d.rtcTime) {
          const el = document.getElementById('valRtc');
          if (el) el.innerText = d.rtcTime;
          if (manual) showToast("Waktu sinkron: " + d.rtcTime);
        }
      })
      .catch(e => {
        console.error("Sync time error:", e);
        if (manual) showToast("Gagal sinkron waktu");
      });
  }

  window.onload = function() {
    syncBrowserTime();
    loadConfig();
    fetchLive();
    updateStorageInfo();
    setInterval(fetchLive, 1000); // Polling live data tiap 1 detik
    setInterval(updateStorageInfo, 10000); // Polling info Storage tiap 10 detik
  };
</script>

</body>
</html>
)rawliteral";

void handleRoot() {
  localServer.send_P(200, "text/html", INDEX_HTML);
}

void handleApiLive() {
  SensorDataSnapshot snap;
  SensorRawValues raw;
  SensorThresholds thresh;

  if (dataMutex != NULL && xSemaphoreTake(dataMutex, pdMS_TO_TICKS(50)) == pdTRUE) {
    snap = sharedSensors;
    raw = sharedRawSensors;
    thresh = currentThresholds;
    xSemaphoreGive(dataMutex);
  } else {
    snap = sharedSensors;
    raw = sharedRawSensors;
    thresh = currentThresholds;
  }

  float devPitch = fabs(snap.pitch - thresh.safeTiltPitch);
  float devRoll  = fabs(snap.roll  - thresh.safeTiltRoll);

  StaticJsonDocument<512> doc;
  doc["pitch"]    = round(snap.pitch * 100.0) / 100.0;
  doc["roll"]     = round(snap.roll * 100.0) / 100.0;
  doc["devPitch"] = round(devPitch * 100.0) / 100.0;
  doc["devRoll"]  = round(devRoll * 100.0) / 100.0;
  doc["soil"]     = round(snap.soilMoisture * 10.0) / 10.0;
  doc["soilAdc"]  = raw.soilAdcRaw;
  doc["rain"]     = round(snap.rainRate * 10.0) / 10.0;
  doc["rainCumu"] = round(snap.rainCumulative * 100.0) / 100.0;
  doc["tips"]     = raw.rainTipsRaw;
  doc["vib"]      = raw.vibPulsesRaw;
  doc["batt"]     = round(snap.batteryVoltage * 100.0) / 100.0;
  doc["solar"]    = snap.solarCurrent;
  doc["rtc"]          = getLogTimeString();
  doc["status"]      = currentStatus;
  doc["alarmReason"] = currentAlarmReason;
  doc["alarmCode"]   = currentAlarmCode;
  doc["inaAvailable"] = (inaAvailable || snap.batteryVoltage > 0.5f);
  doc["inaType"]      = inaAvailable ? (isINA219 ? "INA219" : "INA226") : (snap.batteryVoltage > 0.5f ? "DIVIDER_11_4" : "NONE");
  doc["relay"]       = (sirenActive || stroboActive) ? "ON" : "OFF";

  String res;
  serializeJson(doc, res);
  localServer.send(200, "application/json", res);
}

void handleApiConfig() {
  SensorThresholds thresh;
  if (dataMutex != NULL && xSemaphoreTake(dataMutex, pdMS_TO_TICKS(50)) == pdTRUE) {
    thresh = currentThresholds;
    xSemaphoreGive(dataMutex);
  } else {
    thresh = currentThresholds;
  }

  StaticJsonDocument<768> doc;
  doc["devId"]     = ewsId;
  doc["wsHost"]    = wsHost;
  doc["wsPort"]    = wsPort;
  doc["wsPath"]    = wsPath;
  doc["wsSsl"]     = wsUseSsl;
  doc["wfSsid"]    = wifiSsidDefault;
  doc["wfPass"]    = wifiPasswordDefault;

  doc["safePitch"] = thresh.safeTiltPitch;
  doc["safeRoll"]  = thresh.safeTiltRoll;
  doc["tiltTol"]   = thresh.tiltTolerance;
  doc["tiltWarn"]  = thresh.tiltWarning;
  doc["tiltDang"]  = thresh.tiltDanger;
  doc["rainWarn"]  = thresh.rainWarning;
  doc["rainDang"]  = thresh.rainDanger;
  doc["rainCalib"] = thresh.rainCalibPerTip;
  doc["safeSoil"]  = thresh.safeSoilMoisture;
  doc["soilTol"]   = thresh.soilMoistureTolerance;
  doc["soilWarn"]  = thresh.soilMoistureWarning;
  doc["vibDang"]   = thresh.vibrationDanger;
  doc["soilDry"]   = thresh.soilAdcDry;
  doc["soilWet"]   = thresh.soilAdcWet;
  doc["battLow"]   = thresh.batteryLowVoltage;
  doc["battRatio"] = thresh.battDividerRatio;
  doc["alarmDur"]  = thresh.alarmDuration;
  doc["alarmPau"]  = thresh.alarmPause;
  doc["forceAlmBatt"] = thresh.forceAlarmOnLowBatt;

  String res;
  serializeJson(doc, res);
  localServer.send(200, "application/json", res);
}

void handleApiSaveCalibration() {
  if (!localServer.hasArg("plain")) {
    localServer.send(400, "application/json", "{\"status\":\"error\",\"message\":\"Payload kosong\"}");
    return;
  }
  String body = localServer.arg("plain");
  StaticJsonDocument<768> doc;
  DeserializationError err = deserializeJson(doc, body);
  if (err) {
    localServer.send(400, "application/json", "{\"status\":\"error\",\"message\":\"Format JSON tidak valid\"}");
    return;
  }

  SensorThresholds newT = currentThresholds;
  if (doc.containsKey("safePitch")) newT.safeTiltPitch         = doc["safePitch"].as<float>();
  if (doc.containsKey("safeRoll"))  newT.safeTiltRoll          = doc["safeRoll"].as<float>();
  if (doc.containsKey("tiltTol"))   newT.tiltTolerance         = doc["tiltTol"].as<float>();
  if (doc.containsKey("tiltWarn"))  newT.tiltWarning           = doc["tiltWarn"].as<float>();
  if (doc.containsKey("tiltDang"))  newT.tiltDanger            = doc["tiltDang"].as<float>();
  if (doc.containsKey("rainWarn"))  newT.rainWarning           = doc["rainWarn"].as<float>();
  if (doc.containsKey("rainDang"))  newT.rainDanger            = doc["rainDang"].as<float>();
  if (doc.containsKey("rainCalib")) newT.rainCalibPerTip       = doc["rainCalib"].as<float>();
  if (doc.containsKey("safeSoil"))  newT.safeSoilMoisture      = doc["safeSoil"].as<float>();
  if (doc.containsKey("soilTol"))   newT.soilMoistureTolerance = doc["soilTol"].as<float>();
  if (doc.containsKey("soilWarn"))  newT.soilMoistureWarning   = doc["soilWarn"].as<float>();
  if (doc.containsKey("vibDang"))   newT.vibrationDanger       = doc["vibDang"].as<float>();
  if (doc.containsKey("soilDry"))   newT.soilAdcDry            = doc["soilDry"].as<int>();
  if (doc.containsKey("soilWet"))   newT.soilAdcWet            = doc["soilWet"].as<int>();
  if (doc.containsKey("battLow"))   newT.batteryLowVoltage     = doc["battLow"].as<float>();
  if (doc.containsKey("battRatio")) newT.battDividerRatio      = doc["battRatio"].as<float>();
  if (doc.containsKey("alarmDur"))  newT.alarmDuration         = doc["alarmDur"].as<uint32_t>();
  if (doc.containsKey("alarmPau"))  newT.alarmPause            = doc["alarmPau"].as<uint32_t>();
  if (doc.containsKey("forceAlmBatt")) newT.forceAlarmOnLowBatt = doc["forceAlmBatt"].as<bool>();

  saveThresholdsToEEPROM(newT);
  localServer.send(200, "application/json", "{\"status\":\"success\",\"message\":\"Kalibrasi & Ambang Batas Berhasil Disimpan ke EEPROM!\"}");
}

void handleApiSaveDevice() {
  if (!localServer.hasArg("plain")) {
    localServer.send(400, "application/json", "{\"status\":\"error\",\"message\":\"Payload kosong\"}");
    return;
  }
  String body = localServer.arg("plain");
  StaticJsonDocument<512> doc;
  DeserializationError err = deserializeJson(doc, body);
  if (err) {
    localServer.send(400, "application/json", "{\"status\":\"error\",\"message\":\"Format JSON tidak valid\"}");
    return;
  }

  String newDevId = doc["devId"] | ewsId;
  String newHost  = doc["wsHost"] | wsHost;
  int    newPort  = doc["wsPort"] | wsPort;
  String newPath  = doc["wsPath"] | wsPath;
  bool   newSsl   = doc["wsSsl"] | wsUseSsl;
  String newSsid  = doc["wfSsid"] | wifiSsidDefault;
  String newPass  = doc["wfPass"] | wifiPasswordDefault;

  saveDeviceConfigToNVS(newDevId, newSsid, newPass, newHost, newPort, newPath, newSsl);
  localServer.send(200, "application/json", "{\"status\":\"success\",\"message\":\"Identitas Perangkat & Target Server Disimpan ke NVS!\"}");
}

void handleDownloadTelemetry() {
  File f;
  bool isSd = false;
  String sourceReq = localServer.hasArg("source") ? localServer.arg("source") : "";

  // 1. Jika secara eksplisit meminta data dari flash internal (SPIFFS)
  if (sourceReq == "spiffs" || sourceReq == "internal") {
    if (spiffsAvailable && SPIFFS.exists("/ews_telemetry.csv")) {
      f = SPIFFS.open("/ews_telemetry.csv", FILE_READ);
      isSd = false;
    }
  }
  // 2. Jika secara eksplisit meminta data dari MicroSD
  else if (sourceReq == "sd") {
    if (sdAvailable && sdMutex != NULL && xSemaphoreTake(sdMutex, pdMS_TO_TICKS(3000)) == pdTRUE) {
      if (SD.exists("/ews_telemetry.csv")) {
        f = SD.open("/ews_telemetry.csv", FILE_READ);
        if (f) {
          isSd = true;
        } else {
          xSemaphoreGive(sdMutex);
        }
      } else {
        xSemaphoreGive(sdMutex);
      }
    }
  }
  // 3. Mode otomatis: prioritaskan MicroSD jika ada, jika tidak ada atau kosong beralih ke Flash Internal
  else {
    if (sdAvailable && sdMutex != NULL && xSemaphoreTake(sdMutex, pdMS_TO_TICKS(3000)) == pdTRUE) {
      if (SD.exists("/ews_telemetry.csv")) {
        f = SD.open("/ews_telemetry.csv", FILE_READ);
        if (f) {
          isSd = true;
        } else {
          xSemaphoreGive(sdMutex);
        }
      } else {
        xSemaphoreGive(sdMutex);
      }
    }

    if (!f && spiffsAvailable) {
      if (SPIFFS.exists("/ews_telemetry.csv")) {
        f = SPIFFS.open("/ews_telemetry.csv", FILE_READ);
      }
    }
  }

  if (!f) {
    localServer.send(404, "text/plain; charset=utf-8", "Belum ada rekaman telemetri di media penyimpanan yang dipilih.");
    return;
  }

  String suffix = isSd ? "_sd.csv" : "_internal.csv";
  if (sourceReq == "") suffix = ".csv";
  String filename = "telemetri_" + ewsId + suffix;
  localServer.sendHeader("Content-Type", "text/csv; charset=utf-8");
  localServer.sendHeader("Content-Disposition", "attachment; filename=\"" + filename + "\"");
  localServer.sendHeader("Connection", "close");
  size_t sent = localServer.streamFile(f, "text/csv");
  f.close();
  if (isSd && sdMutex != NULL) {
    xSemaphoreGive(sdMutex);
  }
  Serial.printf("[WEB SERVER] File %s berhasil diunduh via Web Server (%s, %u bytes)\n",
                filename.c_str(), isSd ? "MicroSD" : "SPIFFS", sent);
}

void handleDownloadEvents() {
  File f;
  bool isSd = false;
  String sourceReq = localServer.hasArg("source") ? localServer.arg("source") : "";

  // 1. Jika secara eksplisit meminta data dari flash internal (SPIFFS)
  if (sourceReq == "spiffs" || sourceReq == "internal") {
    if (spiffsAvailable && SPIFFS.exists("/ews_log.csv")) {
      f = SPIFFS.open("/ews_log.csv", FILE_READ);
      isSd = false;
    }
  }
  // 2. Jika secara eksplisit meminta data dari MicroSD
  else if (sourceReq == "sd") {
    if (sdAvailable && sdMutex != NULL && xSemaphoreTake(sdMutex, pdMS_TO_TICKS(3000)) == pdTRUE) {
      if (SD.exists("/ews_log.csv")) {
        f = SD.open("/ews_log.csv", FILE_READ);
        if (f) {
          isSd = true;
        } else {
          xSemaphoreGive(sdMutex);
        }
      } else {
        xSemaphoreGive(sdMutex);
      }
    }
  }
  // 3. Mode otomatis
  else {
    if (sdAvailable && sdMutex != NULL && xSemaphoreTake(sdMutex, pdMS_TO_TICKS(3000)) == pdTRUE) {
      if (SD.exists("/ews_log.csv")) {
        f = SD.open("/ews_log.csv", FILE_READ);
        if (f) {
          isSd = true;
        } else {
          xSemaphoreGive(sdMutex);
        }
      } else {
        xSemaphoreGive(sdMutex);
      }
    }

    if (!f && spiffsAvailable) {
      if (SPIFFS.exists("/ews_log.csv")) {
        f = SPIFFS.open("/ews_log.csv", FILE_READ);
      }
    }
  }

  if (!f) {
    localServer.send(404, "text/plain; charset=utf-8", "Belum ada log kejadian di media penyimpanan yang dipilih.");
    return;
  }

  String suffix = isSd ? "_sd.csv" : "_internal.csv";
  if (sourceReq == "") suffix = ".csv";
  String filename = "kejadian_alarm_" + ewsId + suffix;
  localServer.sendHeader("Content-Type", "text/csv; charset=utf-8");
  localServer.sendHeader("Content-Disposition", "attachment; filename=\"" + filename + "\"");
  localServer.sendHeader("Connection", "close");
  size_t sent = localServer.streamFile(f, "text/csv");
  f.close();
  if (isSd && sdMutex != NULL) {
    xSemaphoreGive(sdMutex);
  }
  Serial.printf("[WEB SERVER] File %s berhasil diunduh via Web Server (%s, %u bytes)\n",
                filename.c_str(), isSd ? "MicroSD" : "SPIFFS", sent);
}
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
