arisfebriyanto193/EWS/(commit log)

2026-09-29 feat: integrasi monitoring kuota dan pulsa Telkomsel modem 4G per node EWS
    [Drill_NPTH_Through.DRL, Drill_PTH_Through.DRL, Drill_PTH_Through_Via.DRL, Gerber_BoardOutlineLayer.GKO, Gerber_BottomLayer.GBL, Gerber_BottomSilkscreenLayer.GBO, Gerber_BottomSolderMaskLayer.GBS, Gerber_TopLayer.GTL]
2026-10-12 fix(trap): update schema, telemetry insert with active_preset and offline status
2026-10-18 feat: sinkronisasi penyebab alarm, logika relay aman INA 0V, siklus 1x sirine hujan, dan modal sensor pemicu di web
2026-10-18 feat: fallback pembagi tegangan resistor (11:4) pada GPIO 14 saat sensor INA219 tidak terpasang
2026-10-18 fix(ews): resolve battery warning flickering on websocket stream and polish trigger cause modal layout with portal
2026-10-18 fix(ews): remove solar and load current from battery card, sync real-time voltage directly from websocket
2026-10-18 feat(ews): deactivate relay during siaga status, relay only activates on bahaya
2026-10-18 fix(ews): fix tilt SIAGA evaluation, synchronize ESP32 thresholds to telemetry and database, and display safe tolerance correctly in modals
2026-10-18 fix(vibration): add 5ms ISR debounce lockout, switch to FALLING edge, and implement multi-cycle persistence anti-false-alarm filter
2026-10-18 feat(ui): sederhanakan modal menjadi 2 pilihan utama: unduh file ESP32 atau dari database server
2026-10-18 feat: persist daily rain to NVS across reboot and add remote restart button
2026-10-24 feat(trap): implement configurable sensorCooldownSec (default 5s) across ESP32, backend, and frontend
2026-10-24 feat(trap): make min and max distance detection thresholds configurable in ESP32 webserver and web dashboard
2026-10-25 fix: perbaikan script up.sh dan bersihkan typo esp32
